vvinhvvo98/Basketball-Launcher/docs/FINAL.JPEG

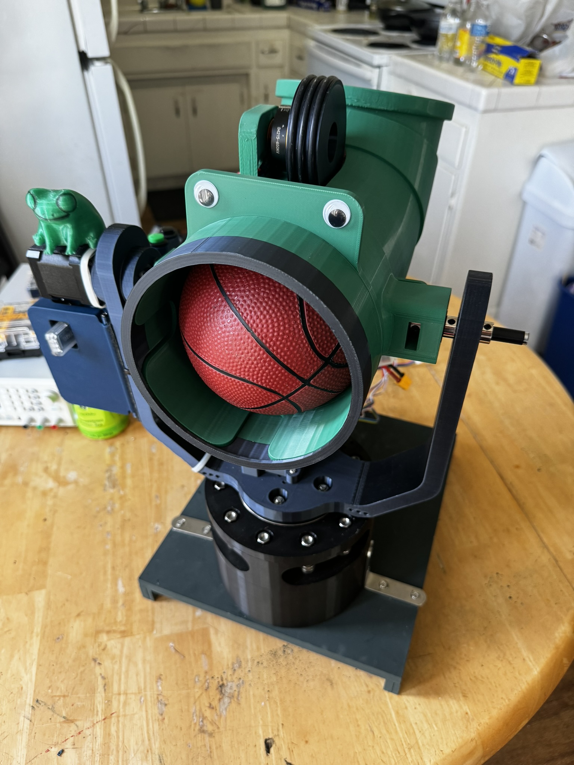
docs/FINAL.JPEG
