vvinhvvo98/Basketball-Launcher/docs/nut.png

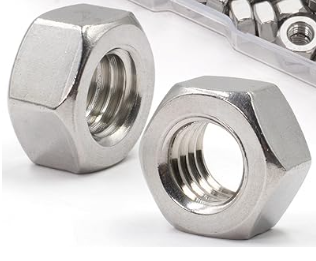
docs/nut.png
