vvinhvvo98/Basketball-Launcher/docs/latex/reports_detail.tex

\chapter{REFERENCE}
\label{reports_detail}\index{REFERENCE@{REFERENCE}}
\doxysection{OVERALL REPORT}\label{reports_detail_doc4}
 {\texttt{  }} 

~\newline
~\newline
~\newline
\doxysection{PROPOSAL}\label{reports_detail_doc1}
 {\texttt{  }} 

~\newline
~\newline
~\newline
\doxysection{REFERENCE MANUAL}\label{reports_detail_doc3}
 {\texttt{  }} 

~\newline
~\newline
~\newline
\doxysection{IDEATION SKETCH}\label{reports_detail_doc5}
 {\texttt{  }} 

~\newline
~\newline
~\newline
\doxysection{LAUNCHER SCHEMATIC}\label{reports_detail_doc8}
 {\texttt{  }} 

~\newline
~\newline
~\newline
\doxysection{CONTROLLER SCHEMATIC}\label{reports_detail_doc7}
 {\texttt{  }} 

~\newline
~\newline
~\newline
\doxysection{BILL OF MATERIAL}\label{reports_detail_doc2}
 {\texttt{  }} 

~\newline
~\newline
~\newline
\doxysection{3D MODEL}\label{reports_detail_doc6}
 {\texttt{  }} 

~\newline
~\newline
~\newline
\doxysection{YOUTUBE}\label{reports_detail_youtube11}
 {\texttt{  }} 

~\newline
~\newline
~\newline
\doxysection{REPOSITORY}\label{reports_detail_repository1}
 {\texttt{  }}
