vvinhvvo98/Basketball-Launcher/docs/latex/mpu6050_8h.tex

\doxysection{Ball\+\_\+\+Launcher\+\_\+\+Controller/\+Core/\+Inc/mpu6050.h File Reference}
\label{mpu6050_8h}\index{Ball\_Launcher\_Controller/Core/Inc/mpu6050.h@{Ball\_Launcher\_Controller/Core/Inc/mpu6050.h}}

Header for \doxyref{mpu6050.\+c}{p.}{mpu6050_8c} file. This file contains the common defines of the application.  

{\ttfamily \#include $<$stdio.\+h$>$}\newline
{\ttfamily \#include $<$stdint.\+h$>$}\newline
{\ttfamily \#include "{}stm32f4xx\+\_\+hal.\+h"{}}\newline
\doxysubsubsection*{Data Structures}
\begin{DoxyCompactItemize}
\item 
struct \textbf{ MPU6050}
\begin{DoxyCompactList}\small\item\em Struct representing a mpu6050 imu sensor. \end{DoxyCompactList}\end{DoxyCompactItemize}
\doxysubsubsection*{Functions}
\begin{DoxyCompactItemize}
\item 
uint16\+\_\+t \textbf{ mpu6050\+\_\+init} (\textbf{ MPU6050} $\ast$imux, I2\+C\+\_\+\+Handle\+Type\+Def $\ast$hi2c)
\begin{DoxyCompactList}\small\item\em Initializes the \doxyref{MPU6050}{p.}{struct_m_p_u6050} sensor. \end{DoxyCompactList}\item 
void \textbf{ mpu6050\+\_\+calibrate} (\textbf{ MPU6050} $\ast$imux)
\begin{DoxyCompactList}\small\item\em Calibrates the \doxyref{MPU6050}{p.}{struct_m_p_u6050} sensor. \end{DoxyCompactList}\item 
void \textbf{ mpu6050\+\_\+update} (\textbf{ MPU6050} $\ast$imux)
\begin{DoxyCompactList}\small\item\em Updates the \doxyref{MPU6050}{p.}{struct_m_p_u6050} sensor data. \end{DoxyCompactList}\item 
int16\+\_\+t \textbf{ mpu6050\+\_\+get\+\_\+gX} (\textbf{ MPU6050} $\ast$imux)
\begin{DoxyCompactList}\small\item\em Gets the calibrated X-\/axis gyroscope data. \end{DoxyCompactList}\item 
int16\+\_\+t \textbf{ mpu6050\+\_\+get\+\_\+gY} (\textbf{ MPU6050} $\ast$imux)
\begin{DoxyCompactList}\small\item\em Gets the calibrated Y-\/axis gyroscope data. \end{DoxyCompactList}\item 
int16\+\_\+t \textbf{ mpu6050\+\_\+get\+\_\+gZ} (\textbf{ MPU6050} $\ast$imux)
\begin{DoxyCompactList}\small\item\em Gets the calibrated Z-\/axis gyroscope data. \end{DoxyCompactList}\item 
int32\+\_\+t \textbf{ mpu6050\+\_\+get\+\_\+X} (\textbf{ MPU6050} $\ast$imux)
\begin{DoxyCompactList}\small\item\em Gets the X-\/axis accelerometer data. \end{DoxyCompactList}\item 
int32\+\_\+t \textbf{ mpu6050\+\_\+get\+\_\+Y} (\textbf{ MPU6050} $\ast$imux)
\begin{DoxyCompactList}\small\item\em Gets the Y-\/axis accelerometer data. \end{DoxyCompactList}\item 
int32\+\_\+t \textbf{ mpu6050\+\_\+get\+\_\+Z} (\textbf{ MPU6050} $\ast$imux)
\begin{DoxyCompactList}\small\item\em Gets the Z-\/axis accelerometer data. \end{DoxyCompactList}\end{DoxyCompactItemize}

\doxysubsection{Detailed Description}
Header for \doxyref{mpu6050.\+c}{p.}{mpu6050_8c} file. This file contains the common defines of the application. 

\doxysubsection{Function Documentation}
\label{mpu6050_8h_afce6eaf948ee778c47de0ee0a1eed19b} 
\index{mpu6050.h@{mpu6050.h}!mpu6050\_calibrate@{mpu6050\_calibrate}}
\index{mpu6050\_calibrate@{mpu6050\_calibrate}!mpu6050.h@{mpu6050.h}}
\doxysubsubsection{mpu6050\_calibrate()}
{\footnotesize\ttfamily void mpu6050\+\_\+calibrate (\begin{DoxyParamCaption}\item[{\textbf{ MPU6050} $\ast$}]{imux }\end{DoxyParamCaption})}

Calibrates the \doxyref{MPU6050}{p.}{struct_m_p_u6050} sensor. 

\begin{DoxyParams}{Parameters}
{\em imux} & Pointer to the \doxyref{MPU6050}{p.}{struct_m_p_u6050} structure. \\
\hline
\end{DoxyParams}
\label{mpu6050_8h_a9ea00ce90e91d89bd407680c26e726bc} 
\index{mpu6050.h@{mpu6050.h}!mpu6050\_get\_gX@{mpu6050\_get\_gX}}
\index{mpu6050\_get\_gX@{mpu6050\_get\_gX}!mpu6050.h@{mpu6050.h}}
\doxysubsubsection{mpu6050\_get\_gX()}
{\footnotesize\ttfamily int16\+\_\+t mpu6050\+\_\+get\+\_\+gX (\begin{DoxyParamCaption}\item[{\textbf{ MPU6050} $\ast$}]{imux }\end{DoxyParamCaption})}

Gets the calibrated X-\/axis gyroscope data. 

\begin{DoxyParams}{Parameters}
{\em imux} & Pointer to the \doxyref{MPU6050}{p.}{struct_m_p_u6050} structure. \\
\hline
\end{DoxyParams}
\begin{DoxyReturn}{Returns}
int16\+\_\+t Calibrated X-\/axis gyroscope data. 
\end{DoxyReturn}
\label{mpu6050_8h_aff1ec64e5ad571812ea3cdede42fb546} 
\index{mpu6050.h@{mpu6050.h}!mpu6050\_get\_gY@{mpu6050\_get\_gY}}
\index{mpu6050\_get\_gY@{mpu6050\_get\_gY}!mpu6050.h@{mpu6050.h}}
\doxysubsubsection{mpu6050\_get\_gY()}
{\footnotesize\ttfamily int16\+\_\+t mpu6050\+\_\+get\+\_\+gY (\begin{DoxyParamCaption}\item[{\textbf{ MPU6050} $\ast$}]{imux }\end{DoxyParamCaption})}

Gets the calibrated Y-\/axis gyroscope data. 

\begin{DoxyParams}{Parameters}
{\em imux} & Pointer to the \doxyref{MPU6050}{p.}{struct_m_p_u6050} structure. \\
\hline
\end{DoxyParams}
\begin{DoxyReturn}{Returns}
int16\+\_\+t Calibrated Y-\/axis gyroscope data. 
\end{DoxyReturn}
\label{mpu6050_8h_a43d5b475f578b8f07e2281ced858173f} 
\index{mpu6050.h@{mpu6050.h}!mpu6050\_get\_gZ@{mpu6050\_get\_gZ}}
\index{mpu6050\_get\_gZ@{mpu6050\_get\_gZ}!mpu6050.h@{mpu6050.h}}
\doxysubsubsection{mpu6050\_get\_gZ()}
{\footnotesize\ttfamily int16\+\_\+t mpu6050\+\_\+get\+\_\+gZ (\begin{DoxyParamCaption}\item[{\textbf{ MPU6050} $\ast$}]{imux }\end{DoxyParamCaption})}

Gets the calibrated Z-\/axis gyroscope data. 

\begin{DoxyParams}{Parameters}
{\em imux} & Pointer to the \doxyref{MPU6050}{p.}{struct_m_p_u6050} structure. \\
\hline
\end{DoxyParams}
\begin{DoxyReturn}{Returns}
int16\+\_\+t Calibrated Z-\/axis gyroscope data. 
\end{DoxyReturn}
\label{mpu6050_8h_a46f9847b0bc4a9ac73eeeaba24bb8dfc} 
\index{mpu6050.h@{mpu6050.h}!mpu6050\_get\_X@{mpu6050\_get\_X}}
\index{mpu6050\_get\_X@{mpu6050\_get\_X}!mpu6050.h@{mpu6050.h}}
\doxysubsubsection{mpu6050\_get\_X()}
{\footnotesize\ttfamily int32\+\_\+t mpu6050\+\_\+get\+\_\+X (\begin{DoxyParamCaption}\item[{\textbf{ MPU6050} $\ast$}]{imux }\end{DoxyParamCaption})}

Gets the X-\/axis accelerometer data. 

\begin{DoxyParams}{Parameters}
{\em imux} & Pointer to the \doxyref{MPU6050}{p.}{struct_m_p_u6050} structure. \\
\hline
\end{DoxyParams}
\begin{DoxyReturn}{Returns}
int32\+\_\+t X-\/axis accelerometer data. 
\end{DoxyReturn}
\label{mpu6050_8h_a604feb09984cc64950d98b711044bbf3} 
\index{mpu6050.h@{mpu6050.h}!mpu6050\_get\_Y@{mpu6050\_get\_Y}}
\index{mpu6050\_get\_Y@{mpu6050\_get\_Y}!mpu6050.h@{mpu6050.h}}
\doxysubsubsection{mpu6050\_get\_Y()}
{\footnotesize\ttfamily int32\+\_\+t mpu6050\+\_\+get\+\_\+Y (\begin{DoxyParamCaption}\item[{\textbf{ MPU6050} $\ast$}]{imux }\end{DoxyParamCaption})}

Gets the Y-\/axis accelerometer data. 

\begin{DoxyParams}{Parameters}
{\em imux} & Pointer to the \doxyref{MPU6050}{p.}{struct_m_p_u6050} structure. \\
\hline
\end{DoxyParams}
\begin{DoxyReturn}{Returns}
int32\+\_\+t Y-\/axis accelerometer data. 
\end{DoxyReturn}
\label{mpu6050_8h_a34ebf02768ba66f4d160afe9adbcc458} 
\index{mpu6050.h@{mpu6050.h}!mpu6050\_get\_Z@{mpu6050\_get\_Z}}
\index{mpu6050\_get\_Z@{mpu6050\_get\_Z}!mpu6050.h@{mpu6050.h}}
\doxysubsubsection{mpu6050\_get\_Z()}
{\footnotesize\ttfamily int32\+\_\+t mpu6050\+\_\+get\+\_\+Z (\begin{DoxyParamCaption}\item[{\textbf{ MPU6050} $\ast$}]{imux }\end{DoxyParamCaption})}

Gets the Z-\/axis accelerometer data. 

\begin{DoxyParams}{Parameters}
{\em imux} & Pointer to the \doxyref{MPU6050}{p.}{struct_m_p_u6050} structure. \\
\hline
\end{DoxyParams}
\begin{DoxyReturn}{Returns}
int32\+\_\+t Z-\/axis accelerometer data. 
\end{DoxyReturn}
\label{mpu6050_8h_a84091077cde2737d6afa76ee69cbe2e7} 
\index{mpu6050.h@{mpu6050.h}!mpu6050\_init@{mpu6050\_init}}
\index{mpu6050\_init@{mpu6050\_init}!mpu6050.h@{mpu6050.h}}
\doxysubsubsection{mpu6050\_init()}
{\footnotesize\ttfamily uint16\+\_\+t mpu6050\+\_\+init (\begin{DoxyParamCaption}\item[{\textbf{ MPU6050} $\ast$}]{imux,  }\item[{I2\+C\+\_\+\+Handle\+Type\+Def $\ast$}]{hi2c }\end{DoxyParamCaption})}

Initializes the \doxyref{MPU6050}{p.}{struct_m_p_u6050} sensor. 

\begin{DoxyParams}{Parameters}
{\em imux} & Pointer to the \doxyref{MPU6050}{p.}{struct_m_p_u6050} structure. \\
\hline
{\em hi2c} & Pointer to the I2C handle structure. \\
\hline
\end{DoxyParams}
\begin{DoxyReturn}{Returns}
uint16\+\_\+t Returns 1 if initialization is successful, otherwise 0. 
\end{DoxyReturn}
\label{mpu6050_8h_a617e3e6502d7a67be5e844967eb454f3} 
\index{mpu6050.h@{mpu6050.h}!mpu6050\_update@{mpu6050\_update}}
\index{mpu6050\_update@{mpu6050\_update}!mpu6050.h@{mpu6050.h}}
\doxysubsubsection{mpu6050\_update()}
{\footnotesize\ttfamily void mpu6050\+\_\+update (\begin{DoxyParamCaption}\item[{\textbf{ MPU6050} $\ast$}]{imux }\end{DoxyParamCaption})}

Updates the \doxyref{MPU6050}{p.}{struct_m_p_u6050} sensor data. 

\begin{DoxyParams}{Parameters}
{\em imux} & Pointer to the \doxyref{MPU6050}{p.}{struct_m_p_u6050} structure. \\
\hline
{\em dt} & Time interval in milliseconds. \\
\hline
\end{DoxyParams}
