vvinhvvo98/Basketball-Launcher/docs/latex/stm32f4xx__it___c_8h.tex

\doxysection{Ball\+\_\+\+Launcher\+\_\+\+Controller/\+Core/\+Inc/stm32f4xx\+\_\+it\+\_\+C.h File Reference}
\label{stm32f4xx__it___c_8h}\index{Ball\_Launcher\_Controller/Core/Inc/stm32f4xx\_it\_C.h@{Ball\_Launcher\_Controller/Core/Inc/stm32f4xx\_it\_C.h}}

This file contains the headers of the interrupt handlers.  

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

\doxysubsection{Detailed Description}
This file contains the headers of the interrupt handlers. 

\begin{DoxyAttention}{Attention}

\end{DoxyAttention}
Copyright (c) 2024 STMicroelectronics. All rights reserved.

This software is licensed under terms that can be found in the LICENSE file in the root directory of this software component. If no LICENSE file comes with this software, it is provided AS-\/\+IS. 

\doxysubsection{Function Documentation}
\label{stm32f4xx__it___c_8h_a850cefb17a977292ae5eb4cafa9976c3} 
\index{stm32f4xx\_it\_C.h@{stm32f4xx\_it\_C.h}!BusFault\_Handler@{BusFault\_Handler}}
\index{BusFault\_Handler@{BusFault\_Handler}!stm32f4xx\_it\_C.h@{stm32f4xx\_it\_C.h}}
\doxysubsubsection{BusFault\_Handler()}
{\footnotesize\ttfamily void Bus\+Fault\+\_\+\+Handler (\begin{DoxyParamCaption}\item[{void}]{ }\end{DoxyParamCaption})}

This function handles Pre-\/fetch fault, memory access fault. 

\label{stm32f4xx__it___c_8h_adbdfb05858cc36fc520974df37ec3cb0} 
\index{stm32f4xx\_it\_C.h@{stm32f4xx\_it\_C.h}!DebugMon\_Handler@{DebugMon\_Handler}}
\index{DebugMon\_Handler@{DebugMon\_Handler}!stm32f4xx\_it\_C.h@{stm32f4xx\_it\_C.h}}
\doxysubsubsection{DebugMon\_Handler()}
{\footnotesize\ttfamily void Debug\+Mon\+\_\+\+Handler (\begin{DoxyParamCaption}\item[{void}]{ }\end{DoxyParamCaption})}

This function handles Debug monitor. 

\label{stm32f4xx__it___c_8h_a2bffc10d5bd4106753b7c30e86903bea} 
\index{stm32f4xx\_it\_C.h@{stm32f4xx\_it\_C.h}!HardFault\_Handler@{HardFault\_Handler}}
\index{HardFault\_Handler@{HardFault\_Handler}!stm32f4xx\_it\_C.h@{stm32f4xx\_it\_C.h}}
\doxysubsubsection{HardFault\_Handler()}
{\footnotesize\ttfamily void Hard\+Fault\+\_\+\+Handler (\begin{DoxyParamCaption}\item[{void}]{ }\end{DoxyParamCaption})}

This function handles Hard fault interrupt. 

\label{stm32f4xx__it___c_8h_a3150f74512510287a942624aa9b44cc5} 
\index{stm32f4xx\_it\_C.h@{stm32f4xx\_it\_C.h}!MemManage\_Handler@{MemManage\_Handler}}
\index{MemManage\_Handler@{MemManage\_Handler}!stm32f4xx\_it\_C.h@{stm32f4xx\_it\_C.h}}
\doxysubsubsection{MemManage\_Handler()}
{\footnotesize\ttfamily void Mem\+Manage\+\_\+\+Handler (\begin{DoxyParamCaption}\item[{void}]{ }\end{DoxyParamCaption})}

This function handles Memory management fault. 

\label{stm32f4xx__it___c_8h_a6ad7a5e3ee69cb6db6a6b9111ba898bc} 
\index{stm32f4xx\_it\_C.h@{stm32f4xx\_it\_C.h}!NMI\_Handler@{NMI\_Handler}}
\index{NMI\_Handler@{NMI\_Handler}!stm32f4xx\_it\_C.h@{stm32f4xx\_it\_C.h}}
\doxysubsubsection{NMI\_Handler()}
{\footnotesize\ttfamily void NMI\+\_\+\+Handler (\begin{DoxyParamCaption}\item[{void}]{ }\end{DoxyParamCaption})}

This function handles Non maskable interrupt. 

\label{stm32f4xx__it___c_8h_a6303e1f258cbdc1f970ce579cc015623} 
\index{stm32f4xx\_it\_C.h@{stm32f4xx\_it\_C.h}!PendSV\_Handler@{PendSV\_Handler}}
\index{PendSV\_Handler@{PendSV\_Handler}!stm32f4xx\_it\_C.h@{stm32f4xx\_it\_C.h}}
\doxysubsubsection{PendSV\_Handler()}
{\footnotesize\ttfamily void Pend\+SV\+\_\+\+Handler (\begin{DoxyParamCaption}\item[{void}]{ }\end{DoxyParamCaption})}

This function handles Pendable request for system service. 

\label{stm32f4xx__it___c_8h_a3e5ddb3df0d62f2dc357e64a3f04a6ce} 
\index{stm32f4xx\_it\_C.h@{stm32f4xx\_it\_C.h}!SVC\_Handler@{SVC\_Handler}}
\index{SVC\_Handler@{SVC\_Handler}!stm32f4xx\_it\_C.h@{stm32f4xx\_it\_C.h}}
\doxysubsubsection{SVC\_Handler()}
{\footnotesize\ttfamily void SVC\+\_\+\+Handler (\begin{DoxyParamCaption}\item[{void}]{ }\end{DoxyParamCaption})}

This function handles System service call via SWI instruction. 

\label{stm32f4xx__it___c_8h_ab5e09814056d617c521549e542639b7e} 
\index{stm32f4xx\_it\_C.h@{stm32f4xx\_it\_C.h}!SysTick\_Handler@{SysTick\_Handler}}
\index{SysTick\_Handler@{SysTick\_Handler}!stm32f4xx\_it\_C.h@{stm32f4xx\_it\_C.h}}
\doxysubsubsection{SysTick\_Handler()}
{\footnotesize\ttfamily void Sys\+Tick\+\_\+\+Handler (\begin{DoxyParamCaption}\item[{void}]{ }\end{DoxyParamCaption})}

This function handles System tick timer. 

\label{stm32f4xx__it___c_8h_a1d98923de2ed6b7309b66f9ba2971647} 
\index{stm32f4xx\_it\_C.h@{stm32f4xx\_it\_C.h}!UsageFault\_Handler@{UsageFault\_Handler}}
\index{UsageFault\_Handler@{UsageFault\_Handler}!stm32f4xx\_it\_C.h@{stm32f4xx\_it\_C.h}}
\doxysubsubsection{UsageFault\_Handler()}
{\footnotesize\ttfamily void Usage\+Fault\+\_\+\+Handler (\begin{DoxyParamCaption}\item[{void}]{ }\end{DoxyParamCaption})}

This function handles Undefined instruction or illegal state.
