vvinhvvo98/Basketball-Launcher/docs/latex/main_8h.tex

\doxysection{Ball\+\_\+\+Launcher\+\_\+\+Main/\+Core/\+Inc/main.h File Reference}
\label{main_8h}\index{Ball\_Launcher\_Main/Core/Inc/main.h@{Ball\_Launcher\_Main/Core/Inc/main.h}}

Header for \doxyref{main.\+c}{p.}{main_8c} file. This file contains the common defines of the application.  

{\ttfamily \#include "{}stm32f4xx\+\_\+hal.\+h"{}}\newline
\doxysubsubsection*{Functions}
\begin{DoxyCompactItemize}
\item 
void \textbf{ HAL\+\_\+\+TIM\+\_\+\+Msp\+Post\+Init} (TIM\+\_\+\+Handle\+Type\+Def $\ast$htim)
\item 
void \textbf{ Error\+\_\+\+Handler} (void)
\begin{DoxyCompactList}\small\item\em This function is executed in case of error occurrence. \end{DoxyCompactList}\end{DoxyCompactItemize}

\doxysubsection{Detailed Description}
Header for \doxyref{main.\+c}{p.}{main_8c} file. This file contains the common defines of the application. 

\begin{DoxyAttention}{Attention}

\end{DoxyAttention}
Copyright (c) 2024 STMicroelectronics. All rights reserved.

This software is licensed under terms that can be found in the LICENSE file in the root directory of this software component. If no LICENSE file comes with this software, it is provided AS-\/\+IS. 

\doxysubsection{Function Documentation}
\label{main_8h_a1730ffe1e560465665eb47d9264826f9} 
\index{main.h@{main.h}!Error\_Handler@{Error\_Handler}}
\index{Error\_Handler@{Error\_Handler}!main.h@{main.h}}
\doxysubsubsection{Error\_Handler()}
{\footnotesize\ttfamily void Error\+\_\+\+Handler (\begin{DoxyParamCaption}\item[{void}]{ }\end{DoxyParamCaption})}

This function is executed in case of error occurrence. 

\begin{DoxyRetVals}{Return values}
{\em None} & \\
\hline
\end{DoxyRetVals}
\label{main_8h_ae70bce6c39d0b570a7523b86738cec4b} 
\index{main.h@{main.h}!HAL\_TIM\_MspPostInit@{HAL\_TIM\_MspPostInit}}
\index{HAL\_TIM\_MspPostInit@{HAL\_TIM\_MspPostInit}!main.h@{main.h}}
\doxysubsubsection{HAL\_TIM\_MspPostInit()}
{\footnotesize\ttfamily void HAL\+\_\+\+TIM\+\_\+\+Msp\+Post\+Init (\begin{DoxyParamCaption}\item[{TIM\+\_\+\+Handle\+Type\+Def $\ast$}]{htim }\end{DoxyParamCaption})}

TIM2 GPIO Configuration PA1 -\/-\/-\/-\/-\/-\/$>$ TIM2\+\_\+\+CH2 PA2 -\/-\/-\/-\/-\/-\/$>$ TIM2\+\_\+\+CH3

TIM3 GPIO Configuration PB5 -\/-\/-\/-\/-\/-\/$>$ TIM3\+\_\+\+CH2
