vvinhvvo98/Basketball-Launcher/docs/latex/main___c_8c.tex

\doxysection{Ball\+\_\+\+Launcher\+\_\+\+Controller/\+Core/\+Src/main\+\_\+C.c File Reference}
\label{main___c_8c}\index{Ball\_Launcher\_Controller/Core/Src/main\_C.c@{Ball\_Launcher\_Controller/Core/Src/main\_C.c}}

Main program body.  

{\ttfamily \#include "{}main.\+h"{}}\newline
{\ttfamily \#include "{}mpu6050.\+h"{}}\newline
{\ttfamily \#include $<$stdio.\+h$>$}\newline
{\ttfamily \#include $<$string.\+h$>$}\newline
\doxysubsubsection*{Functions}
\begin{DoxyCompactItemize}
\item 
void \textbf{ System\+Clock\+\_\+\+Config} (void)
\begin{DoxyCompactList}\small\item\em System Clock Configuration. \end{DoxyCompactList}\item 
int \textbf{ main} (void)
\begin{DoxyCompactList}\small\item\em The application entry point. \end{DoxyCompactList}\item 
void \textbf{ Error\+\_\+\+Handler} (void)
\begin{DoxyCompactList}\small\item\em This function is executed in case of error occurrence. \end{DoxyCompactList}\end{DoxyCompactItemize}
\doxysubsubsection*{Variables}
\begin{DoxyCompactItemize}
\item 
I2\+C\+\_\+\+Handle\+Type\+Def \textbf{ hi2c1}
\item 
UART\+\_\+\+Handle\+Type\+Def \textbf{ huart1}
\item 
UART\+\_\+\+Handle\+Type\+Def \textbf{ huart2}
\item 
int16\+\_\+t \textbf{ gX} = 0
\item 
int16\+\_\+t \textbf{ gY} = 0
\item 
int16\+\_\+t \textbf{ gZ} = 0
\item 
uint16\+\_\+t \textbf{ stat} = 0
\item 
uint16\+\_\+t \textbf{ shot} = 0
\item 
uint16\+\_\+t \textbf{ move} = 0
\item 
uint16\+\_\+t \textbf{ STATE} = 0
\item 
uint16\+\_\+t \textbf{ STATE\+\_\+0\+\_\+\+INIT} = 0
\item 
uint16\+\_\+t \textbf{ STATE\+\_\+1\+\_\+\+ERROR} = 1
\item 
uint16\+\_\+t \textbf{ STATE\+\_\+2\+\_\+\+IMU} = 2
\item 
uint16\+\_\+t \textbf{ STATE\+\_\+3\+\_\+\+BUTTON\+\_\+\+LED} = 3
\item 
uint16\+\_\+t \textbf{ STATE\+\_\+4\+\_\+\+TRANSFER} = 4
\item 
char \textbf{ buffer} [100]
\end{DoxyCompactItemize}

\doxysubsection{Detailed Description}
Main program body. 

\begin{DoxyAttention}{Attention}

\end{DoxyAttention}
Copyright (c) 2024 STMicroelectronics. All rights reserved.

This software is licensed under terms that can be found in the LICENSE file in the root directory of this software component. If no LICENSE file comes with this software, it is provided AS-\/\+IS. 

\doxysubsection{Function Documentation}
\label{main___c_8c_a1730ffe1e560465665eb47d9264826f9} 
\index{main\_C.c@{main\_C.c}!Error\_Handler@{Error\_Handler}}
\index{Error\_Handler@{Error\_Handler}!main\_C.c@{main\_C.c}}
\doxysubsubsection{Error\_Handler()}
{\footnotesize\ttfamily void Error\+\_\+\+Handler (\begin{DoxyParamCaption}\item[{void}]{ }\end{DoxyParamCaption})}

This function is executed in case of error occurrence. 

\begin{DoxyRetVals}{Return values}
{\em None} & \\
\hline
\end{DoxyRetVals}
\label{main___c_8c_a840291bc02cba5474a4cb46a9b9566fe} 
\index{main\_C.c@{main\_C.c}!main@{main}}
\index{main@{main}!main\_C.c@{main\_C.c}}
\doxysubsubsection{main()}
{\footnotesize\ttfamily int main (\begin{DoxyParamCaption}\item[{void}]{ }\end{DoxyParamCaption})}

The application entry point. 

\begin{DoxyRetVals}{Return values}
{\em int} & \\
\hline
\end{DoxyRetVals}
\label{main___c_8c_a70af21c671abfcc773614a9a4f63d920} 
\index{main\_C.c@{main\_C.c}!SystemClock\_Config@{SystemClock\_Config}}
\index{SystemClock\_Config@{SystemClock\_Config}!main\_C.c@{main\_C.c}}
\doxysubsubsection{SystemClock\_Config()}
{\footnotesize\ttfamily void System\+Clock\+\_\+\+Config (\begin{DoxyParamCaption}\item[{void}]{ }\end{DoxyParamCaption})}

System Clock Configuration. 

\begin{DoxyRetVals}{Return values}
{\em None} & \\
\hline
\end{DoxyRetVals}
Configure the main internal regulator output voltage

Initializes the RCC Oscillators according to the specified parameters in the RCC\+\_\+\+Osc\+Init\+Type\+Def structure.

Initializes the CPU, AHB and APB buses clocks

\doxysubsection{Variable Documentation}
\label{main___c_8c_a542df3d5bbe8c96a672476931ec18220} 
\index{main\_C.c@{main\_C.c}!buffer@{buffer}}
\index{buffer@{buffer}!main\_C.c@{main\_C.c}}
\doxysubsubsection{buffer}
{\footnotesize\ttfamily char buffer[100]}

\label{main___c_8c_af311395520d3063de824b529c9cdb10d} 
\index{main\_C.c@{main\_C.c}!gX@{gX}}
\index{gX@{gX}!main\_C.c@{main\_C.c}}
\doxysubsubsection{gX}
{\footnotesize\ttfamily int16\+\_\+t gX = 0}

\label{main___c_8c_a158916f3f452bccade03134dd750e452} 
\index{main\_C.c@{main\_C.c}!gY@{gY}}
\index{gY@{gY}!main\_C.c@{main\_C.c}}
\doxysubsubsection{gY}
{\footnotesize\ttfamily int16\+\_\+t gY = 0}

\label{main___c_8c_a2c037649b97f103359d32fc55121c752} 
\index{main\_C.c@{main\_C.c}!gZ@{gZ}}
\index{gZ@{gZ}!main\_C.c@{main\_C.c}}
\doxysubsubsection{gZ}
{\footnotesize\ttfamily int16\+\_\+t gZ = 0}

\label{main___c_8c_af7b2c26e44dadaaa798a5c3d82914ba7} 
\index{main\_C.c@{main\_C.c}!hi2c1@{hi2c1}}
\index{hi2c1@{hi2c1}!main\_C.c@{main\_C.c}}
\doxysubsubsection{hi2c1}
{\footnotesize\ttfamily I2\+C\+\_\+\+Handle\+Type\+Def hi2c1}

\label{main___c_8c_a2cf715bef37f7e8ef385a30974a5f0d5} 
\index{main\_C.c@{main\_C.c}!huart1@{huart1}}
\index{huart1@{huart1}!main\_C.c@{main\_C.c}}
\doxysubsubsection{huart1}
{\footnotesize\ttfamily UART\+\_\+\+Handle\+Type\+Def huart1}

\label{main___c_8c_aa9479c261d65eecedd3d9582f7f0f89c} 
\index{main\_C.c@{main\_C.c}!huart2@{huart2}}
\index{huart2@{huart2}!main\_C.c@{main\_C.c}}
\doxysubsubsection{huart2}
{\footnotesize\ttfamily UART\+\_\+\+Handle\+Type\+Def huart2}

\label{main___c_8c_af0ccf006f74d313e9fcefe4a8edd47b8} 
\index{main\_C.c@{main\_C.c}!move@{move}}
\index{move@{move}!main\_C.c@{main\_C.c}}
\doxysubsubsection{move}
{\footnotesize\ttfamily uint16\+\_\+t move = 0}

\label{main___c_8c_a734a6bb09e6a5fc98ebb8436df7ae452} 
\index{main\_C.c@{main\_C.c}!shot@{shot}}
\index{shot@{shot}!main\_C.c@{main\_C.c}}
\doxysubsubsection{shot}
{\footnotesize\ttfamily uint16\+\_\+t shot = 0}

\label{main___c_8c_a9ebb6eed90bd90fa99f9cf9e1f6c69fd} 
\index{main\_C.c@{main\_C.c}!stat@{stat}}
\index{stat@{stat}!main\_C.c@{main\_C.c}}
\doxysubsubsection{stat}
{\footnotesize\ttfamily uint16\+\_\+t stat = 0}

\label{main___c_8c_a942cbc58d5df6ff6e78e7de2da6bb43d} 
\index{main\_C.c@{main\_C.c}!STATE@{STATE}}
\index{STATE@{STATE}!main\_C.c@{main\_C.c}}
\doxysubsubsection{STATE}
{\footnotesize\ttfamily uint16\+\_\+t STATE = 0}

\label{main___c_8c_a18428ffe41044eaa981a9aa5d12c0268} 
\index{main\_C.c@{main\_C.c}!STATE\_0\_INIT@{STATE\_0\_INIT}}
\index{STATE\_0\_INIT@{STATE\_0\_INIT}!main\_C.c@{main\_C.c}}
\doxysubsubsection{STATE\_0\_INIT}
{\footnotesize\ttfamily uint16\+\_\+t STATE\+\_\+0\+\_\+\+INIT = 0}

\label{main___c_8c_ac121bcf9c6185c1391e9d76671c0cab9} 
\index{main\_C.c@{main\_C.c}!STATE\_1\_ERROR@{STATE\_1\_ERROR}}
\index{STATE\_1\_ERROR@{STATE\_1\_ERROR}!main\_C.c@{main\_C.c}}
\doxysubsubsection{STATE\_1\_ERROR}
{\footnotesize\ttfamily uint16\+\_\+t STATE\+\_\+1\+\_\+\+ERROR = 1}

\label{main___c_8c_a5552820803f06a882be3bf1cdfbde998} 
\index{main\_C.c@{main\_C.c}!STATE\_2\_IMU@{STATE\_2\_IMU}}
\index{STATE\_2\_IMU@{STATE\_2\_IMU}!main\_C.c@{main\_C.c}}
\doxysubsubsection{STATE\_2\_IMU}
{\footnotesize\ttfamily uint16\+\_\+t STATE\+\_\+2\+\_\+\+IMU = 2}

\label{main___c_8c_aca0f5e1c40d574009ccfb91fe42929d0} 
\index{main\_C.c@{main\_C.c}!STATE\_3\_BUTTON\_LED@{STATE\_3\_BUTTON\_LED}}
\index{STATE\_3\_BUTTON\_LED@{STATE\_3\_BUTTON\_LED}!main\_C.c@{main\_C.c}}
\doxysubsubsection{STATE\_3\_BUTTON\_LED}
{\footnotesize\ttfamily uint16\+\_\+t STATE\+\_\+3\+\_\+\+BUTTON\+\_\+\+LED = 3}

\label{main___c_8c_a6e420747c5d2d0820f7a909bb0084f66} 
\index{main\_C.c@{main\_C.c}!STATE\_4\_TRANSFER@{STATE\_4\_TRANSFER}}
\index{STATE\_4\_TRANSFER@{STATE\_4\_TRANSFER}!main\_C.c@{main\_C.c}}
\doxysubsubsection{STATE\_4\_TRANSFER}
{\footnotesize\ttfamily uint16\+\_\+t STATE\+\_\+4\+\_\+\+TRANSFER = 4}
