vvinhvvo98/Basketball-Launcher/docs/latex/main___c_8h.tex

\doxysection{Ball\+\_\+\+Launcher\+\_\+\+Controller/\+Core/\+Inc/main\+\_\+C.h File Reference}
\label{main___c_8h}\index{Ball\_Launcher\_Controller/Core/Inc/main\_C.h@{Ball\_Launcher\_Controller/Core/Inc/main\_C.h}}

Header for \doxyref{main\+\_\+\+C.\+c}{p.}{main___c_8c} file. This file contains the common defines of the application.  

{\ttfamily \#include "{}stm32f4xx\+\_\+hal.\+h"{}}\newline
\doxysubsubsection*{Functions}
\begin{DoxyCompactItemize}
\item 
void \textbf{ Error\+\_\+\+Handler} (void)
\begin{DoxyCompactList}\small\item\em This function is executed in case of error occurrence. \end{DoxyCompactList}\end{DoxyCompactItemize}

\doxysubsection{Detailed Description}
Header for \doxyref{main\+\_\+\+C.\+c}{p.}{main___c_8c} file. This file contains the common defines of the application. 

\begin{DoxyAttention}{Attention}

\end{DoxyAttention}
Copyright (c) 2024 STMicroelectronics. All rights reserved.

This software is licensed under terms that can be found in the LICENSE file in the root directory of this software component. If no LICENSE file comes with this software, it is provided AS-\/\+IS. 

\doxysubsection{Function Documentation}
\label{main___c_8h_a1730ffe1e560465665eb47d9264826f9} 
\index{main\_C.h@{main\_C.h}!Error\_Handler@{Error\_Handler}}
\index{Error\_Handler@{Error\_Handler}!main\_C.h@{main\_C.h}}
\doxysubsubsection{Error\_Handler()}
{\footnotesize\ttfamily void Error\+\_\+\+Handler (\begin{DoxyParamCaption}\item[{void}]{ }\end{DoxyParamCaption})}

This function is executed in case of error occurrence. 

\begin{DoxyRetVals}{Return values}
{\em None} & \\
\hline
\end{DoxyRetVals}
