vvinhvvo98/Basketball-Launcher/docs/latex/sysmem_8c.tex

\doxysection{Ball\+\_\+\+Launcher\+\_\+\+Main/\+Core/\+Src/sysmem.c File Reference}
\label{sysmem_8c}\index{Ball\_Launcher\_Main/Core/Src/sysmem.c@{Ball\_Launcher\_Main/Core/Src/sysmem.c}}

STM32\+Cube\+IDE System Memory calls file.  

{\ttfamily \#include $<$errno.\+h$>$}\newline
{\ttfamily \#include $<$stdint.\+h$>$}\newline
\doxysubsubsection*{Functions}
\begin{DoxyCompactItemize}
\item 
void $\ast$ \textbf{ \+\_\+sbrk} (ptrdiff\+\_\+t incr)
\begin{DoxyCompactList}\small\item\em \doxyref{\+\_\+sbrk()}{p.}{sysmem_8c_a68125648bcce70b6bb3aa0be50e99700} allocates memory to the newlib heap and is used by malloc and others from the C library \end{DoxyCompactList}\end{DoxyCompactItemize}

\doxysubsection{Detailed Description}
STM32\+Cube\+IDE System Memory calls file. 

\begin{DoxyAuthor}{Author}
Generated by STM32\+Cube\+IDE \begin{DoxyVerb}       For more information about which C functions
       need which of these lowlevel functions
       please consult the newlib libc manual
\end{DoxyVerb}
 
\end{DoxyAuthor}
\begin{DoxyAttention}{Attention}

\end{DoxyAttention}
Copyright (c) 2024 STMicroelectronics. All rights reserved.

This software is licensed under terms that can be found in the LICENSE file in the root directory of this software component. If no LICENSE file comes with this software, it is provided AS-\/\+IS. 

\doxysubsection{Function Documentation}
\label{sysmem_8c_a68125648bcce70b6bb3aa0be50e99700} 
\index{sysmem.c@{sysmem.c}!\_sbrk@{\_sbrk}}
\index{\_sbrk@{\_sbrk}!sysmem.c@{sysmem.c}}
\doxysubsubsection{\_sbrk()}
{\footnotesize\ttfamily void $\ast$ \+\_\+sbrk (\begin{DoxyParamCaption}\item[{ptrdiff\+\_\+t}]{incr }\end{DoxyParamCaption})}

\doxyref{\+\_\+sbrk()}{p.}{sysmem_8c_a68125648bcce70b6bb3aa0be50e99700} allocates memory to the newlib heap and is used by malloc and others from the C library 

\begin{DoxyVerb}* ############################################################################
* #  .data  #  .bss  #       newlib heap       #          MSP stack          #
* #         #        #                         # Reserved by _Min_Stack_Size #
* ############################################################################
* ^-- RAM start      ^-- _end                             _estack, RAM end --^
* \end{DoxyVerb}

This implementation starts allocating at the \textquotesingle{}\+\_\+end\textquotesingle{} linker symbol The \textquotesingle{}\+\_\+\+Min\+\_\+\+Stack\+\_\+\+Size\textquotesingle{} linker symbol reserves a memory for the MSP stack The implementation considers \textquotesingle{}\+\_\+estack\textquotesingle{} linker symbol to be RAM end NOTE\+: If the MSP stack, at any point during execution, grows larger than the reserved size, please increase the \textquotesingle{}\+\_\+\+Min\+\_\+\+Stack\+\_\+\+Size\textquotesingle{}.

\begin{DoxyParams}{Parameters}
{\em incr} & Memory size \\
\hline
\end{DoxyParams}
\begin{DoxyReturn}{Returns}
Pointer to allocated memory 
\end{DoxyReturn}
