vvinhvvo98/Basketball-Launcher/docs/latex/system__stm32f4xx_8c.tex

\doxysection{Ball\+\_\+\+Launcher\+\_\+\+Main/\+Core/\+Src/system\+\_\+stm32f4xx.c File Reference}
\label{system__stm32f4xx_8c}\index{Ball\_Launcher\_Main/Core/Src/system\_stm32f4xx.c@{Ball\_Launcher\_Main/Core/Src/system\_stm32f4xx.c}}

CMSIS Cortex-\/\+M4 Device Peripheral Access Layer System Source File.  

{\ttfamily \#include "{}stm32f4xx.\+h"{}}\newline
\doxysubsubsection*{Macros}
\begin{DoxyCompactItemize}
\item 
\#define \textbf{ HSE\+\_\+\+VALUE}~((uint32\+\_\+t)25000000)
\item 
\#define \textbf{ HSI\+\_\+\+VALUE}~((uint32\+\_\+t)16000000)
\end{DoxyCompactItemize}
\doxysubsubsection*{Functions}
\begin{DoxyCompactItemize}
\item 
void \textbf{ System\+Init} (void)
\begin{DoxyCompactList}\small\item\em Setup the microcontroller system Initialize the FPU setting, vector table location and External memory configuration. \end{DoxyCompactList}\item 
void \textbf{ System\+Core\+Clock\+Update} (void)
\begin{DoxyCompactList}\small\item\em Update System\+Core\+Clock variable according to Clock Register Values. The System\+Core\+Clock variable contains the core clock (HCLK), it can be used by the user application to setup the Sys\+Tick timer or configure other parameters. \end{DoxyCompactList}\end{DoxyCompactItemize}
\doxysubsubsection*{Variables}
\begin{DoxyCompactItemize}
\item 
uint32\+\_\+t \textbf{ System\+Core\+Clock} = 16000000
\item 
const uint8\+\_\+t \textbf{ AHBPresc\+Table} [16] = \{0, 0, 0, 0, 0, 0, 0, 0, 1, 2, 3, 4, 6, 7, 8, 9\}
\item 
const uint8\+\_\+t \textbf{ APBPresc\+Table} [8] = \{0, 0, 0, 0, 1, 2, 3, 4\}
\end{DoxyCompactItemize}

\doxysubsection{Detailed Description}
CMSIS Cortex-\/\+M4 Device Peripheral Access Layer System Source File. 

\begin{DoxyAuthor}{Author}
MCD Application Team 
\end{DoxyAuthor}
This file provides two functions and one global variable to be called from user application\+:
\begin{DoxyItemize}
\item \doxyref{System\+Init()}{p.}{group___s_t_m32_f4xx___system___private___functions_ga93f514700ccf00d08dbdcff7f1224eb2}\+: This function is called at startup just after reset and before branch to main program. This call is made inside the "{}startup\+\_\+stm32f4xx.\+s"{} file.
\item System\+Core\+Clock variable\+: Contains the core clock (HCLK), it can be used by the user application to setup the Sys\+Tick timer or configure other parameters.
\item \doxyref{System\+Core\+Clock\+Update()}{p.}{group___s_t_m32_f4xx___system___private___functions_gae0c36a9591fe6e9c45ecb21a794f0f0f}\+: Updates the variable System\+Core\+Clock and must be called whenever the core clock is changed during program execution.
\end{DoxyItemize}

\begin{DoxyAttention}{Attention}

\end{DoxyAttention}
Copyright (c) 2017 STMicroelectronics. All rights reserved.

This software is licensed under terms that can be found in the LICENSE file in the root directory of this software component. If no LICENSE file comes with this software, it is provided AS-\/\+IS.
