vvinhvvo98/Basketball-Launcher/docs/25bearing.png

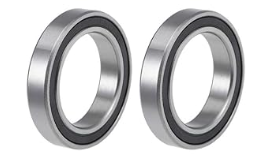
docs/25bearing.png
