vvinhvvo98/Basketball-Launcher/docs/35bearing.png

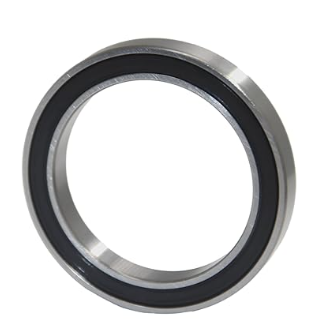
docs/35bearing.png
