vvinhvvo98/Basketball-Launcher/docs/45bearing.png

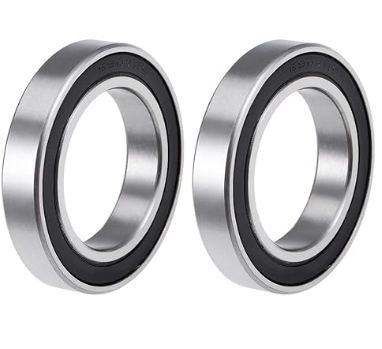
docs/45bearing.png
