vvinhvvo98/Basketball-Launcher/docs/basketball.png

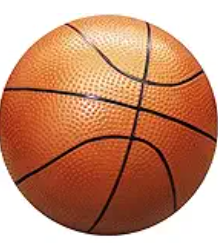
docs/basketball.png
