vvinhvvo98/Basketball-Launcher/docs/battery.png

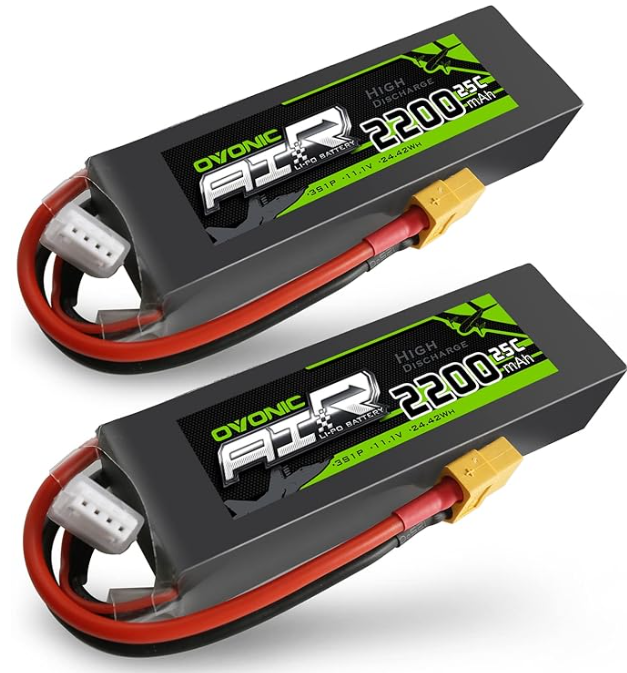
docs/battery.png
