vvinhvvo98/Basketball-Launcher/docs/bolt.png

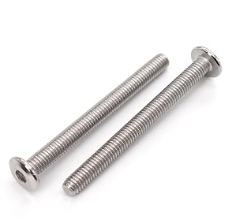
docs/bolt.png
