vvinhvvo98/Basketball-Launcher/docs/cable.png

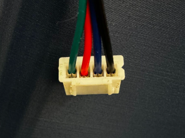
docs/cable.png
