vvinhvvo98/Basketball-Launcher/docs/CAD.png

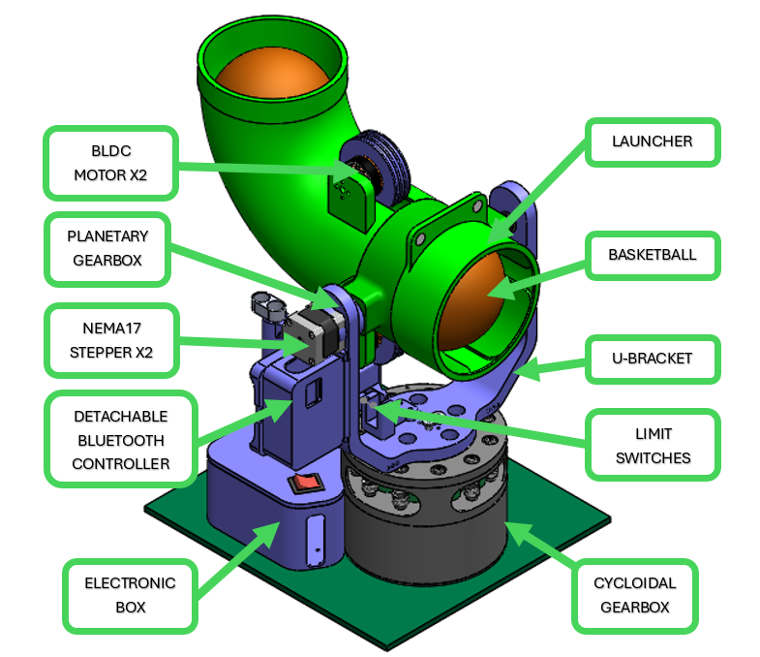
docs/CAD.png
