vvinhvvo98/Basketball-Launcher/docs/CG.png

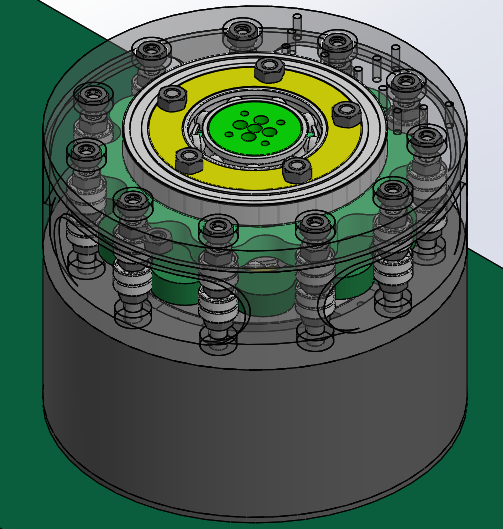
docs/CG.png
