vvinhvvo98/Basketball-Launcher/docs/d4215_bldc.png

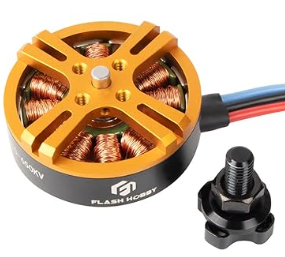
docs/d4215_bldc.png
