vvinhvvo98/Basketball-Launcher/docs/ebox.png

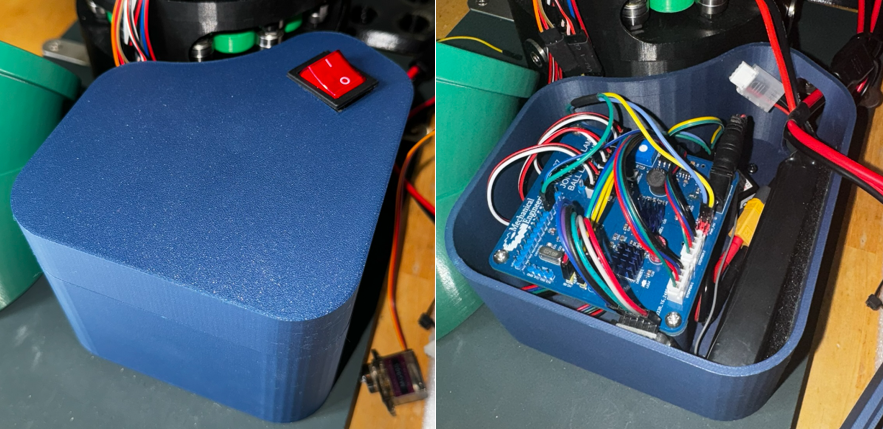
docs/ebox.png
