vvinhvvo98/Basketball-Launcher/docs/FINAL.png

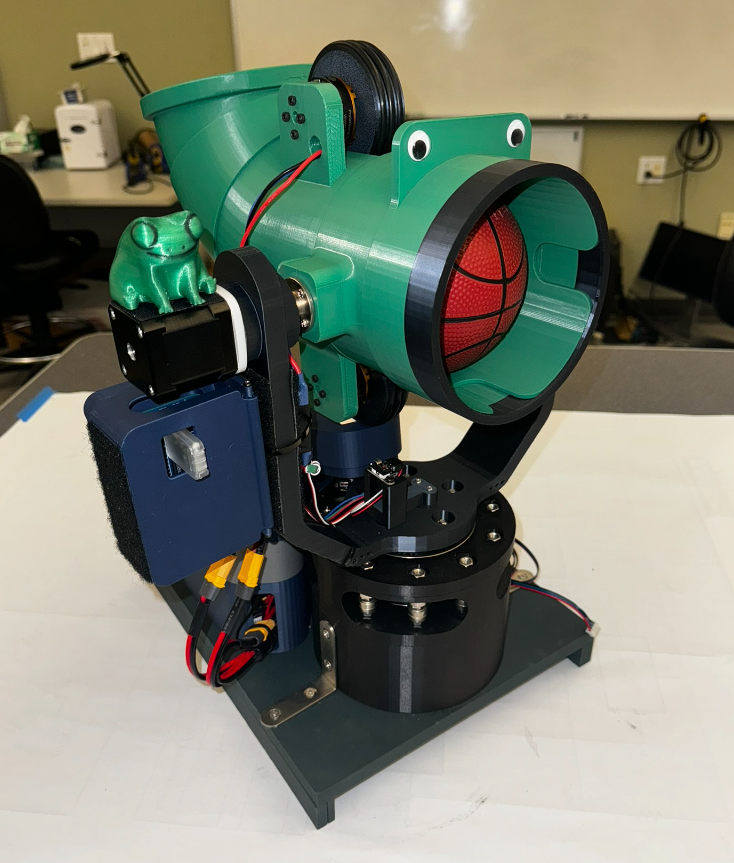
docs/FINAL.png
