vvinhvvo98/Basketball-Launcher/docs/finalpcb2.png

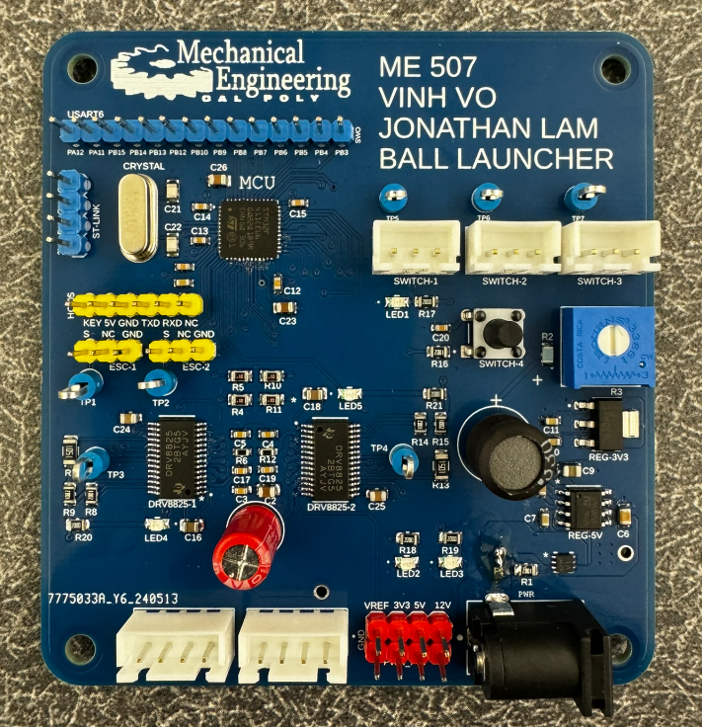
docs/finalpcb2.png
