vvinhvvo98/Basketball-Launcher/docs/fppf.png

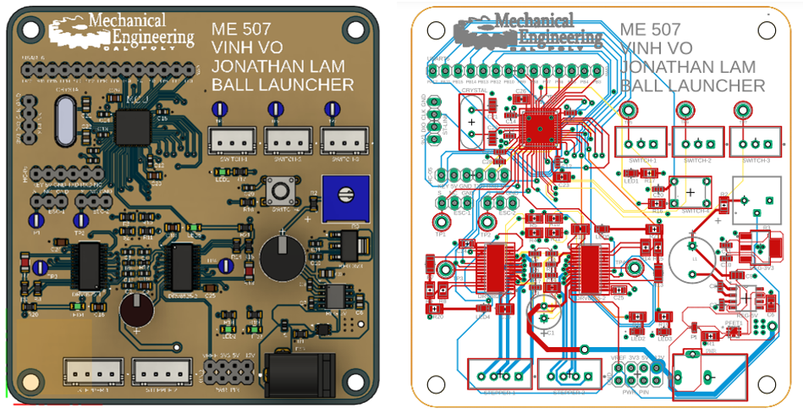
docs/fppf.png
