vvinhvvo98/Basketball-Launcher/docs/FSM2.png

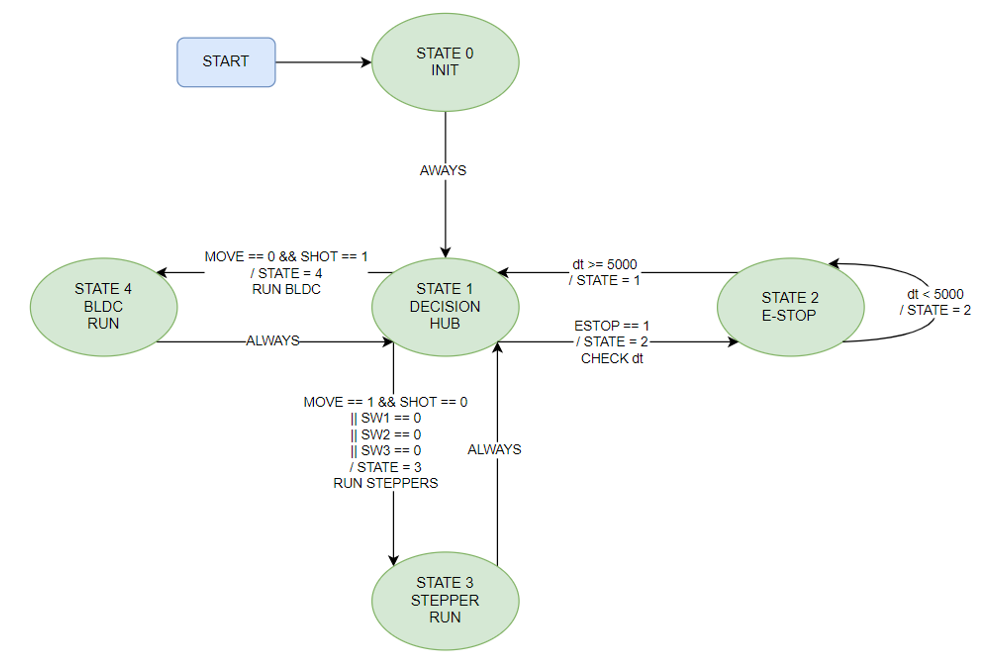
docs/FSM2.png
