vvinhvvo98/Basketball-Launcher/docs/github.png

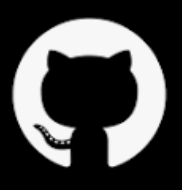
docs/github.png
