vvinhvvo98/Basketball-Launcher/docs/idea.png

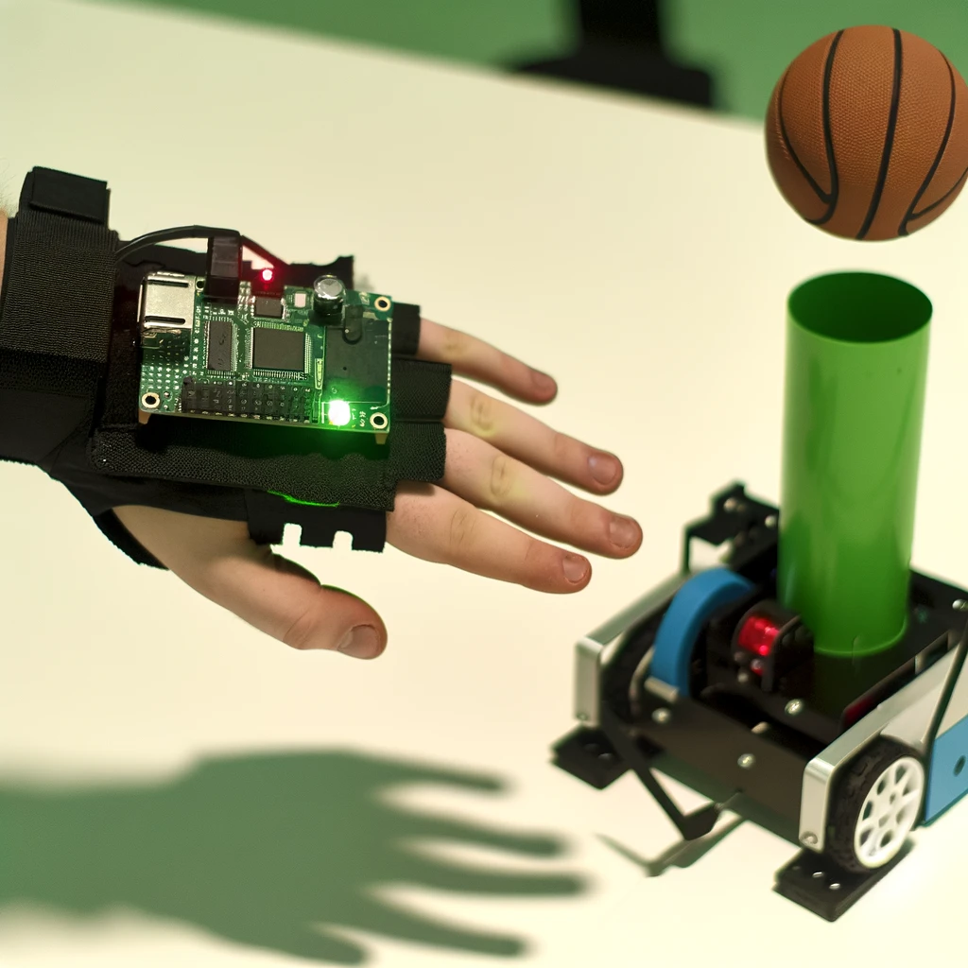
docs/idea.png
