vvinhvvo98/Basketball-Launcher/docs/latex/peashooter.png

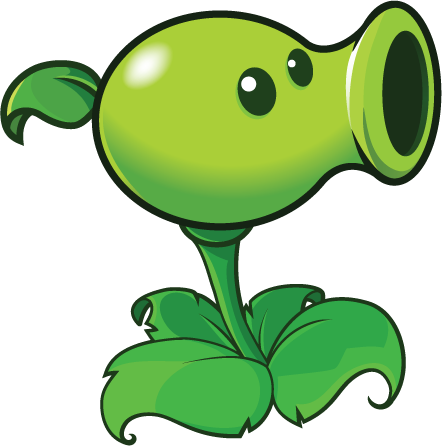
docs/latex/peashooter.png
