vvinhvvo98/Basketball-Launcher/docs/launcher.png

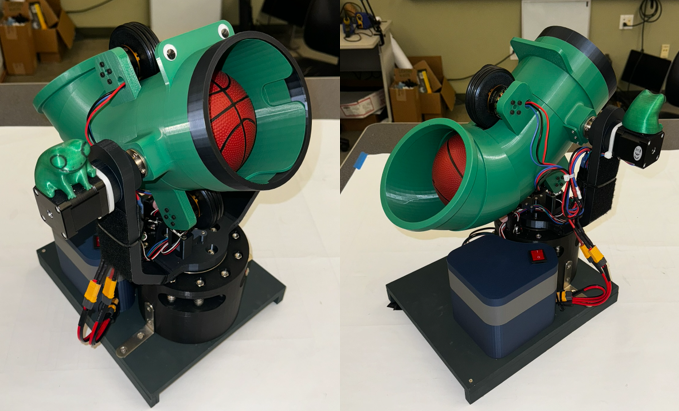
docs/launcher.png
