vvinhvvo98/Basketball-Launcher/docs/limit_switch.png

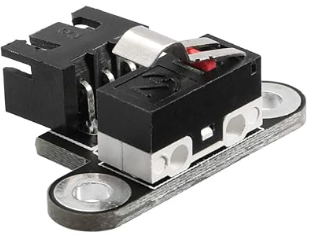
docs/limit_switch.png
