vvinhvvo98/Basketball-Launcher/docs/link.png

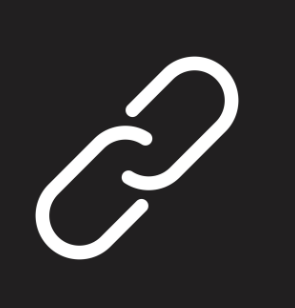
docs/link.png
