vvinhvvo98/Basketball-Launcher/docs/locknut.png

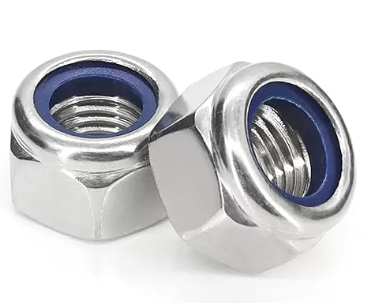
docs/locknut.png
