vvinhvvo98/Basketball-Launcher/docs/nema17.png

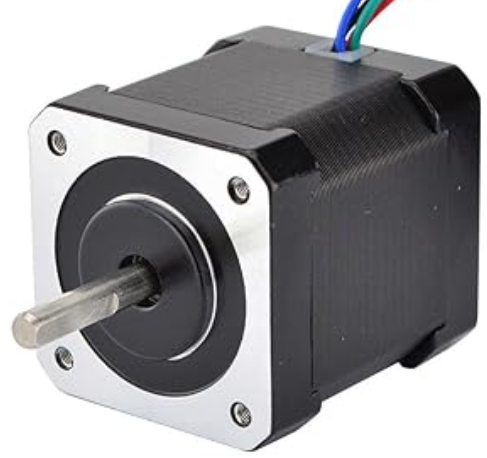
docs/nema17.png
