vvinhvvo98/Basketball-Launcher/docs/nema17_gearbox.png

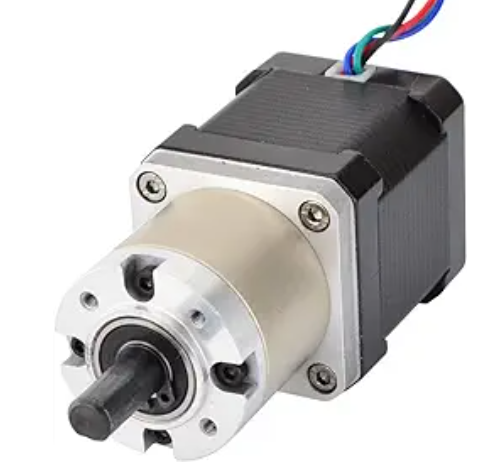
docs/nema17_gearbox.png
