vvinhvvo98/Basketball-Launcher/docs/o_ring.png

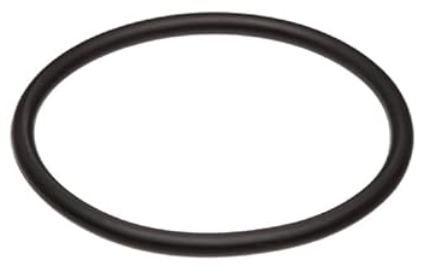
docs/o_ring.png
