vvinhvvo98/Basketball-Launcher/docs/pcb1.png

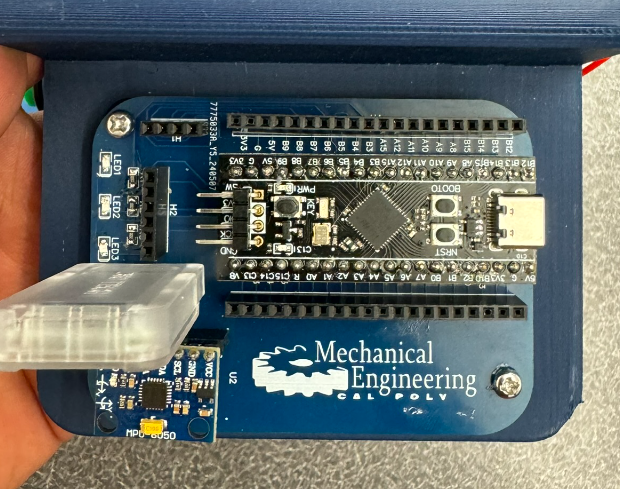
docs/pcb1.png
