vvinhvvo98/Basketball-Launcher/docs/PCBCONTROLLERLAYOUT.png

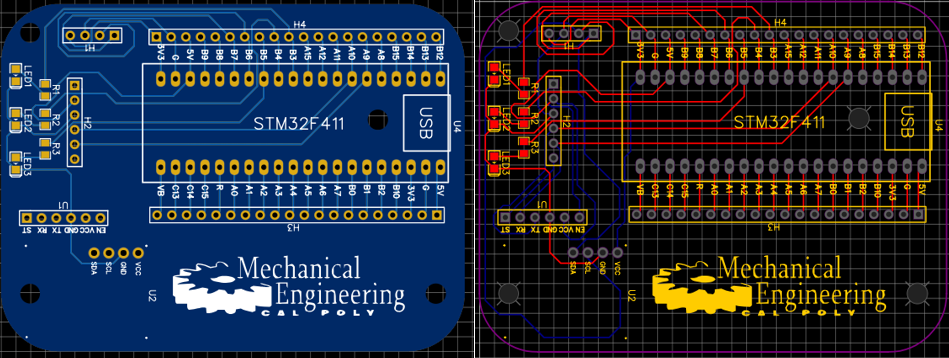
docs/PCBCONTROLLERLAYOUT.png
