vvinhvvo98/Basketball-Launcher/docs/pdf.png

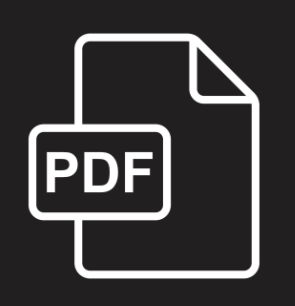
docs/pdf.png
