vvinhvvo98/Basketball-Launcher/docs/pp.png

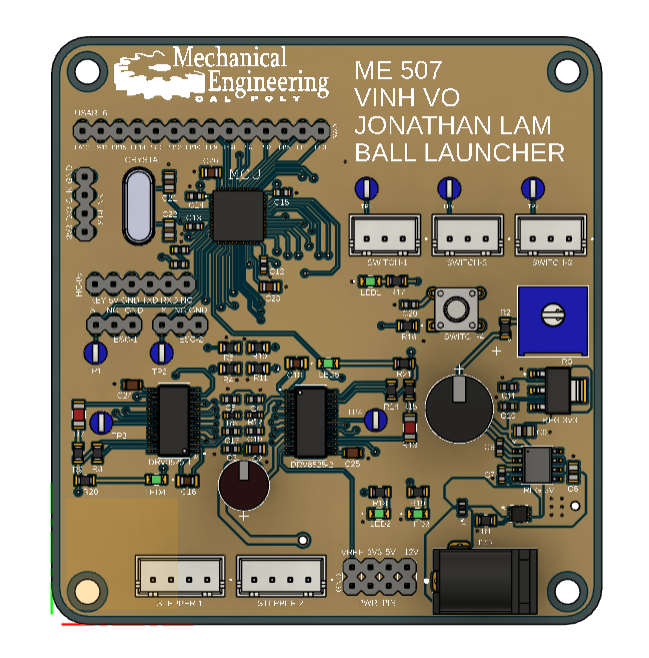
docs/pp.png
