vvinhvvo98/Basketball-Launcher/docs/solidworks.png

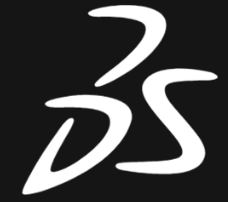
docs/solidworks.png
