vvinhvvo98/Basketball-Launcher/docs/switch.png

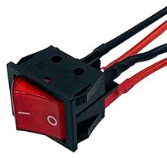
docs/switch.png
