vvinhvvo98/Basketball-Launcher/docs/ubec_esc.png

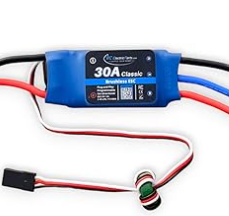
docs/ubec_esc.png
