vvinhvvo98/Basketball-Launcher/docs/xlsx.png

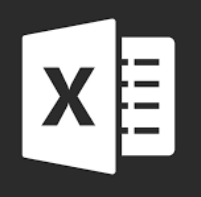
docs/xlsx.png
