vvinhvvo98/Basketball-Launcher/docs/youtube.png

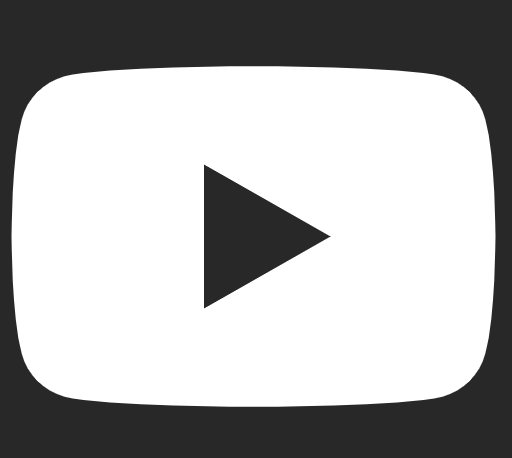
docs/youtube.png
