vvinhvvo98/Basketball-Launcher/images/bp.png

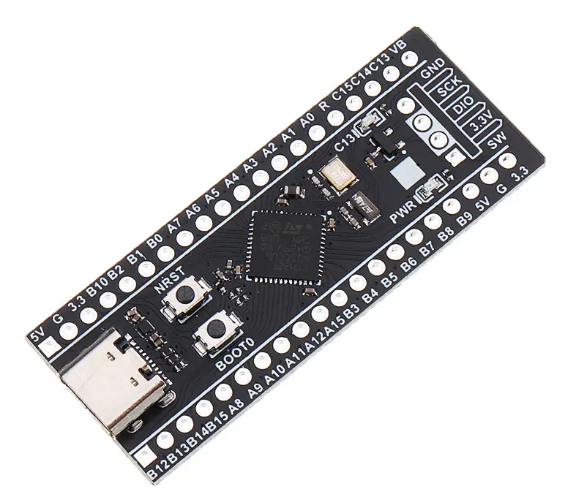
images/bp.png
