vvinhvvo98/Basketball-Launcher/images/brk.png

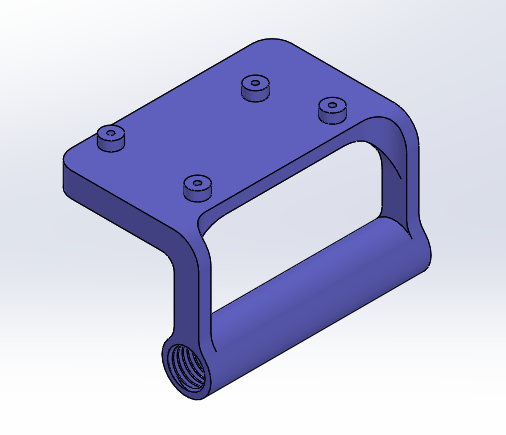
images/brk.png
