vvinhvvo98/Basketball-Launcher/images/button.png

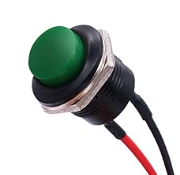
images/button.png
