vvinhvvo98/Basketball-Launcher/images/fp.png

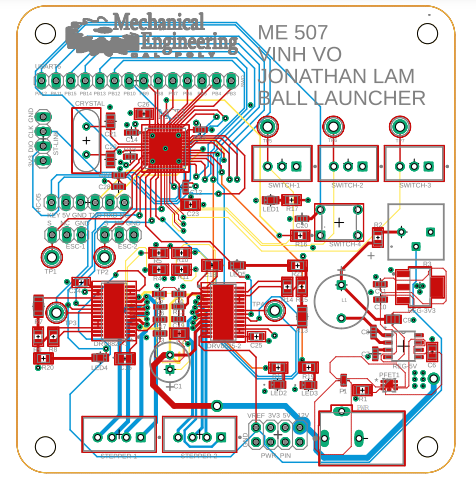
images/fp.png
