vvinhvvo98/Basketball-Launcher/images/hc05.png

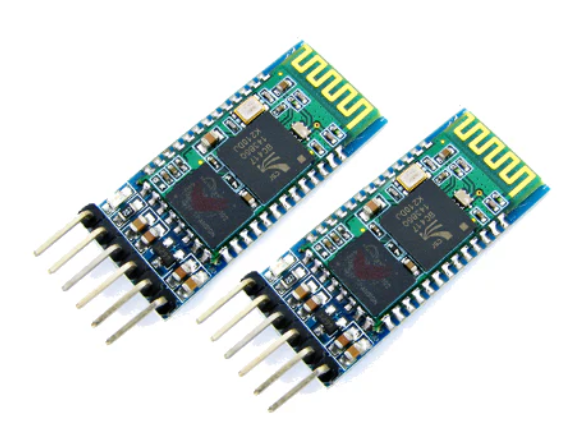
images/hc05.png
