vvinhvvo98/Basketball-Launcher/images/imu.png

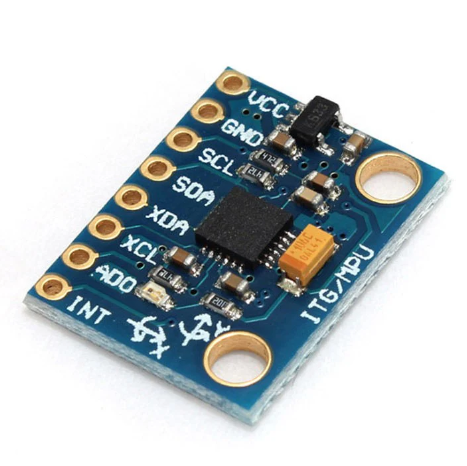
images/imu.png
