vvinhvvo98/Basketball-Launcher/images/led.png

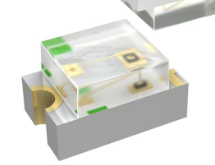
images/led.png
