vvinhvvo98/Basketball-Launcher/images/r.png

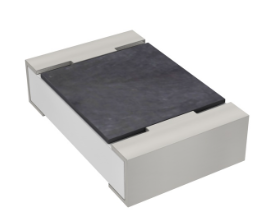
images/r.png
