vvinhvvo98/Basketball-Launcher/REPORTS/BOM(UPDATE).xlsx

Sheet: AMAZON
No | Picture | Parts | Unit Price | Qty | Total Amount
1 | #VALUE! | NEMA17 | $15.00 | 1 | $15.00
2 | #VALUE! | NEMA17 + GEAR BOX | $40.00 | 1 | $40.00
3 | #VALUE! | D421 BLDC | $27.00 | 2 | $54.00
4 | #VALUE! | UBEC ESC | $22.00 | 2 | $44.00
5 | #VALUE! | O RING | $2.00 | 2 | $4.00
6 | #VALUE! | SWITCH | $10.00 | 1 | $10.00
7 | #VALUE! | BASKETBALL | $6.00 | 1 | $6.00
8 | #VALUE! | HC-05 | $10.00 | 2 | $20.00
9 | #VALUE! | LIMIT SWITCH | $1.00 | 3 | $3.00
10 | #VALUE! | CONNECTOR | $10.00 | 1 | $10.00
11 | #VALUE! | CONNECTOR | $3.00 | 2 | $6.00
12 | #VALUE! | BATTERY | $18.00 | 2 | $36.00
13 | #VALUE! | FILLAMENT | $20.00 | 4 | $80.00
14 | #VALUE! | BEARINGS | $10.00 | 2 | $20.00
15 | #VALUE! | BEARINGS | $10.00 | 3 | $30.00
16 | #VALUE! | BEARINGS | $6.00 | 2 | $12.00
17 | #VALUE! | BEARINGS | $10.00 | 1 | $10.00
18 | #VALUE! | NUTS | $6.00 | 1 | $6.00
19 | #VALUE! | NUTS | $10.00 | 1 | $10.00
20 | #VALUE! | BOLTS | $10.00 | 2 | $20.00
 |  |  |  |  | $436.00

Sheet: DIGIKEY
No | Syms | Parts | Picture | Number Part | Amount | Cost | Total | Buy | Cost | Links
CONNECTORS
1 | PWR | CONN PWR JACK 2X5.5MM SOLDER | #VALUE! | PJ-102AH | 1 | $0.70 | $0.70 | 1 | $0.70 | https://www.digikey.com/en/products/detail/cui-devices/PJ-102AH/408448
2 | SWITCH-1 SWITCH-2 SWITCH-3 | CONN HEADER VERT 3POS 2.5MM | #VALUE! | B3B-XH-A | 3 | $0.21 | $0.63 | 4 | $0.84 | https://www.digikey.com/en/products/detail/jst-sales-america-inc/B3B-XH-A/1651046
3 | STEPPER-1 STEPPER-2 | CONN HEADER VERT 4POS 2.5MM | #VALUE! | B4B-XH-A | 2 | $0.23 | $0.46 | 3 | $0.69 | https://www.digikey.com/en/products/detail/jst-sales-america-inc/B4B-XH-A/1651047
CAPACITORS
4 | C16 C18 | CAP CER 0805 10NF 100V C0G 5% | #VALUE! | C0805C103J1GEC7800 | 2 | $0.14 | $0.29 | 4 | $0.58 | https://www.digikey.com/en/products/detail/kemet/C0805C103J1GEC7800/8644543
5 | C3, C4, C5 C8, C12, C13, C14,C15, C17, C19, C20, C27 | CAP CER 0.1UF 25V X7R 0603 | #VALUE! | CC0603KRX7R8BB104 | 12 | $0.10 | $1.20 | 20 | $2.00 | https://www.digikey.com/en/products/detail/yageo/CC0603KRX7R8BB104/2103079
6 | C2,C23 | CAP CER 4.7UF 25V X5R 0805 | #VALUE! | C2012X5R1E475K125AB | 2 | $0.19 | $0.38 | 5 | $0.95 | https://www.digikey.com/en/products/detail/tdk-corporation/C2012X5R1E475K125AB/1986842
7 | C6 | CAP CER 10UF 25V X5R 0805 | #VALUE! | CC0805KRX5R8BB106 | 1 | $0.38 | $0.38 | 3 | $1.14 | https://www.digikey.com/en/products/detail/yageo/CC0805KRX5R8BB106/7164524
8 | C1 | CAP ALUM 100UF 20% 25V RADIAL | #VALUE! | 860020473008 | 1 | $0.13 | $0.13 | 2 | $0.26 | https://www.digikey.com/en/products/detail/w%C3%BCrth-elektronik/860020473008/5727062
9 | C7, C10, C11, C28 | CAP CER 1UF 25V X5R 0603 | #VALUE! | CC0603KRX5R8BB105 | 4 | $0.10 | $0.40 | 10 | $1.00 | https://www.digikey.com/en/products/detail/yageo/CC0603KRX5R8BB105/2833610
10 | C9 | CAP CER 22UF 25V X5R 0805 | #VALUE! | CC0805MKX5R8BB226 | 1 | $0.41 | $0.41 | 3 | $1.23 | https://www.digikey.com/en/products/detail/yageo/CC0805MKX5R8BB226/5195309
11 | C21,C22 | CAP CER 30PF 25V NP0 0805 | #VALUE! | C0805C300M3GAC7800 | 2 | $0.24 | $0.48 | 5 | $1.20 | https://www.digikey.com/en/products/detail/kemet/C0805C300M3GAC7800/2212480?
12 | C24, C25 | CAP CER 0.47UF 25V X7R 0805 | #VALUE! | CGA4J2X7R1E474K125AA | 2 | $0.24 | $0.48 | 5 | $1.20 | https://www.digikey.com/en/products/detail/tdk-corporation/CGA4J2X7R1E474K125AA/2443725
RESISTORS
13 | R3 | TRIMMER 5K OHM 0.5W PC PIN TOP | #VALUE! | 3386P-1-502LF | 1 | $1.77 | $1.77 | 1 | $1.77 | https://www.digikey.com.br/en/models/1088535
14 | R2 | RES 50K OHM 0.1% 1/8W 0805 | #VALUE! | MCU08050D5002BP100 | 1 | $0.85 | $0.85 | 2 | $1.70 | https://www.digikey.com.br/en/products/detail/vishay-beyschlag-draloric-bc-components/MCU08050D5002BP100/8125783
14 | R1,R8,R9,R14,R15, R16 | RES 10K OHM 1% 1/8W 0805 | #VALUE! | RC0805FR-0710KL | 6 | $0.10 | $0.60 | 12 | $1.20 | https://www.digikey.com/en/products/detail/yageo/RC0805FR-0710KL/727535
15 | R7,R13 | RES 1.5K OHM 1% 1/4W 1206 | #VALUE! | RC1206FR-071K5L | 2 | $0.10 | $0.20 | 5 | $0.50 | https://www.digikey.com/en/products/detail/yageo/RC1206FR-071K5L/728441
16 | R6, R12 | RES SMD 1M OHM 1% 1/10W 0603 | #VALUE! | ERJ-3EKF1004V | 2 | $0.10 | $0.20 | 5 | $0.50 | https://www.digikey.com/en/products/detail/panasonic-electronic-components/ERJ-3EKF1004V/196033
17 | R4, R5,R10, R11 | RES 0.1 OHM 1% 1/4W 0805 | #VALUE! | ERJ-U6SFR10V | 4 | $0.66 | $2.64 | 8 | $5.28 | https://www.digikey.com/en/products/detail/panasonic-electronic-components/ERJ-U6SFR10V/2811822
18 | R17, R18, R19, R20, R21 | RES 200 OHM 1% 1/8W 0805 | #VALUE! | RC0805FR-07200RL | 5 | $0.10 | $0.50 | 10 | $1.00 | https://www.digikey.com/en/products/detail/yageo/RC0805FR-07200RL/727723
OTHERS
19 | F1 | FUSE BOARD MOUNT 4A 32VDC 0603 | #VALUE! | MFU0603FF04000P500 | 1 | $0.24 | $0.24 | 2 | $0.48 | https://www.digikey.com/en/products/detail/vishay-beyschlag-draloric-bc-components/MFU0603FF04000P500/1202614
20 | L1 | FIXED IND 33UH 1.7A 120 MOHM TH | #VALUE! | RLB0914-330KL | 1 | $0.42 | $0.42 | 2 | $0.84 | https://www.digikey.com/en/products/detail/bourns-inc/RLB0914-330KL/2561360
21 | SWITCH-4 | SWITCH TACTILE SPST-NO 0.05A 12V | #VALUE! | TL1105BF160Q | 1 | $0.20 | $0.20 | 2 | $0.40 | https://www.digikey.com/en/products/detail/e-switch/TL1105BF160Q/1358
22 | CRYSTAL | CRYSTAL 25.0000MHZ 20PF TH | #VALUE! | 631-FC4STCBMF25.0-ND | 1 | $0.34 | $0.34 | 2 | $0.68 | https://www.digikey.com/en/products/detail/fox-electronics/FC4STCBMF25-0/1024704
23 | TP1, TP2, TP3, TP4, TP5, TP6, TP7, TP8, TP9, TP 10 | PC TEST POINT MULTIPURPOSE BLUE | #VALUE! | 36-5127-ND | 10 | $0.38 | $3.80 | 10 | $3.80 | https://www.digikey.com/en/products/detail/keystone-electronics/5127/2170330
24 | LED 1, LED 2, LED 3, LED 4, LED 5 | LED BLUE CLEAR 0805 SMD | #VALUE! | VAOL-S8SB4 | 5 | $0.72 | $3.60 | 6 | $4.32 | https://www.digikey.com/en/models/4515728
IC
25 | REG-3V3 | IC REG LINEAR 3.3V 1A SOT223-4 | #VALUE! | TLV1117LV33DCYR | 1 | $0.35 | $0.35 | 2 | $0.70 | https://www.digikey.com/en/products/detail/texas-instruments/TLV1117LV33DCYR/2666508
26 | PFET1 | MOSFET P-CH 12V 8.2A DFN2020MD-6 | #VALUE! | PMPB15XP,115 | 1 | $0.47 | $0.47 | 2 | $0.94 | https://www.digikey.com/en/products/detail/nexperia-usa-inc/PMPB15XP-115/3679489
27 | REG-5V | IC REG BUCK 5V 1.5A 8SO | #VALUE! | L6981N50DR | 1 | $2.87 | $2.87 | 1 | $2.87 | https://www.digikey.com/en/products/detail/stmicroelectronics/L6981N50DR/16841560
28 | MCU | IC MCU 32BIT 512KB FLSH 48UFQFPN | #VALUE! | STM32F411CEU6 | 1 | $7.40 | $7.40 | 1 | $7.40 | https://www.digikey.com/en/products/detail/stmicroelectronics/STM32F411CEU6/4935720
29 | DRV8825-1 DRV8825-2 | IC MTR DRVR BIPLR 8.2-45V 28SSOP | #VALUE! | DRV8825 | 2 | $5.65 | $11.30 | 2 | $11.30 | https://www.digikey.com/en/products/detail/texas-instruments/DRV8825PWPR/2695909
30 | PCB | PCB ORDER | #VALUE! | MAIN PCB | 1 | $72.28 | $72.28 | 1 | $72.28 | https://jlcpcb.com/
 | PCB | PCB ORDER |  | CONTROL PCB | 1 | $26.42 | $26.42 | 1 | $26.42 | https://jlcpcb.com/
 |  |  |  | Total | 81 |  | $142.39 |  | $156.17
