vvinhvvo98/Basketball-Launcher/docs/bom.png

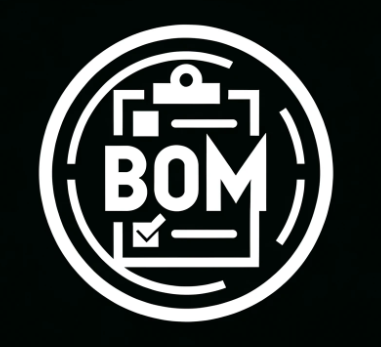
docs/bom.png
