vvinhvvo98/Basketball-Launcher/CAD/Controller_CAD/Assem2.SLDASM

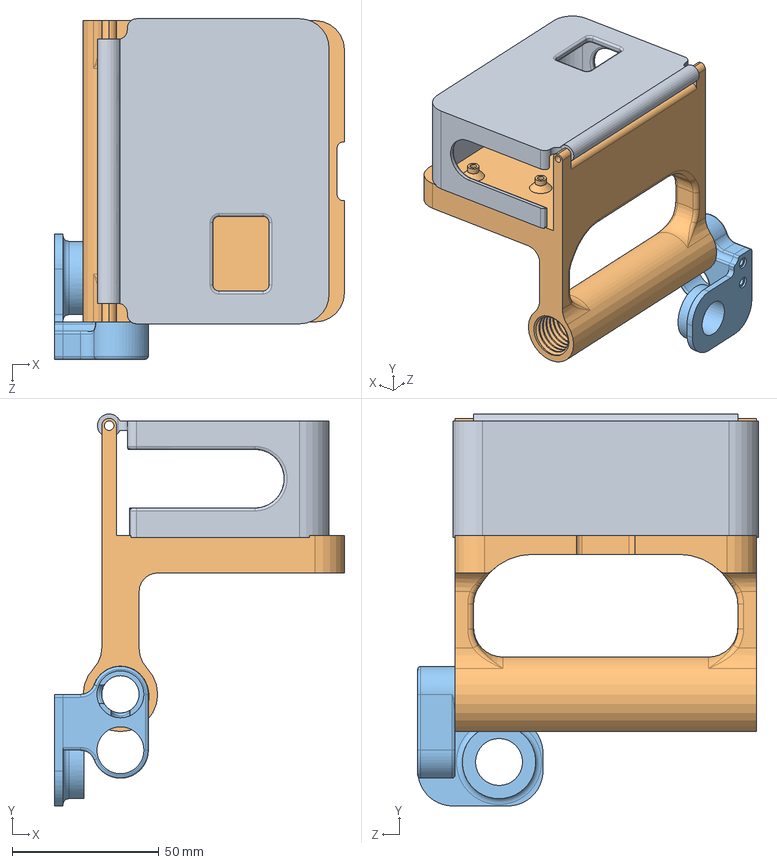
[picture p74: CAD file, 2024-06-01]
CAD/Controller_CAD/Assem2.SLDASM
98.8 x 133.6 x 116.0 mm
