vvinhvvo98/Basketball-Launcher/CAD/Launcher_CAD/Cycloidal Gear Box/Parts/ASSY/Nuts.SLDASM

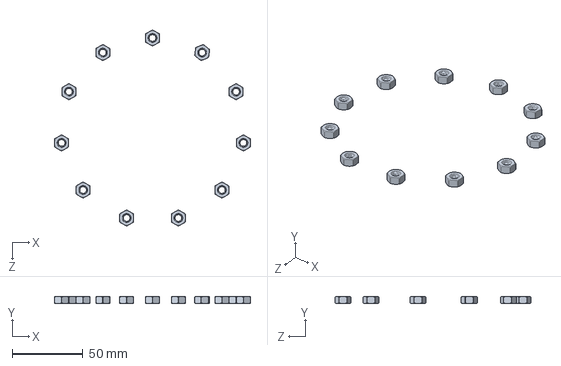
[picture p75: CAD file, 2024-05-14]
CAD/Launcher_CAD/Cycloidal Gear Box/Parts/ASSY/Nuts.SLDASM
138.7 x 5.00 x 138.8 mm
90592A016_Steel Hex Nut x 11
