vvinhvvo98/Basketball-Launcher/CAD/Launcher_CAD/Cycloidal Gear Box/Parts/ASSY/Bearings.SLDASM

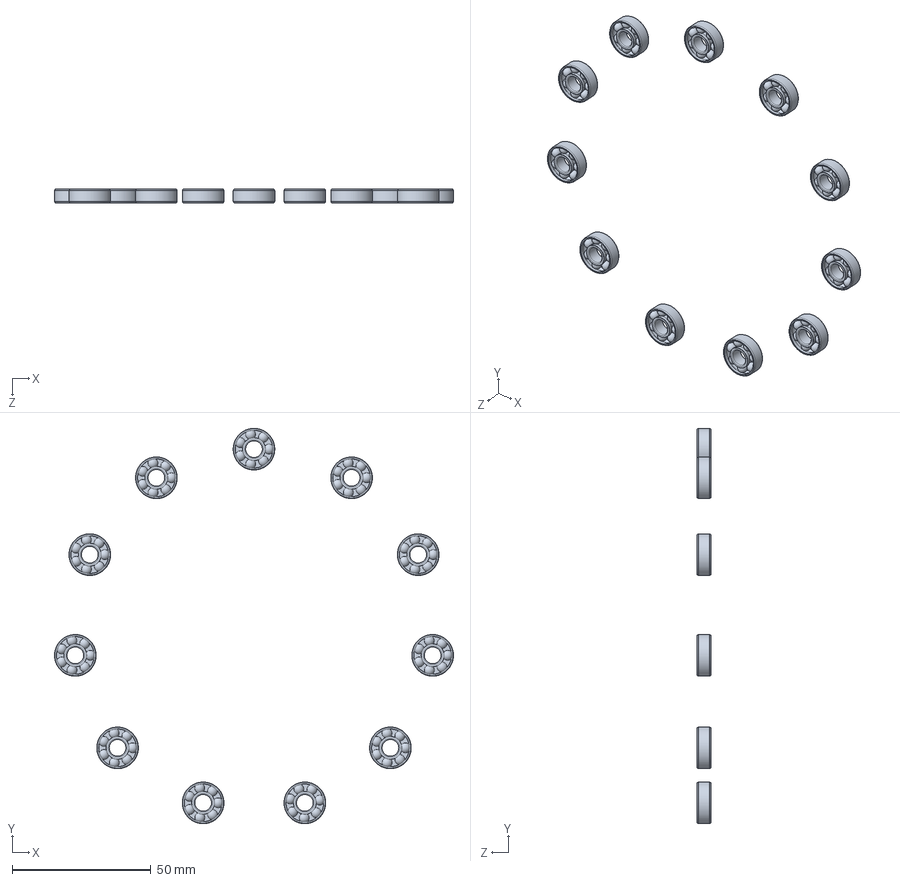
[picture p76: CAD file, 2024-05-14]
CAD/Launcher_CAD/Cycloidal Gear Box/Parts/ASSY/Bearings.SLDASM
143.7 x 142.4 x 5.00 mm
4668K121_Permanently Lubricated Stainless Steel Ball Bearing x 11
