vvinhvvo98/Basketball-Launcher/CAD/Launcher_CAD/Cycloidal Gear Box/Parts/Cycloidal Disk 2.SLDPRT

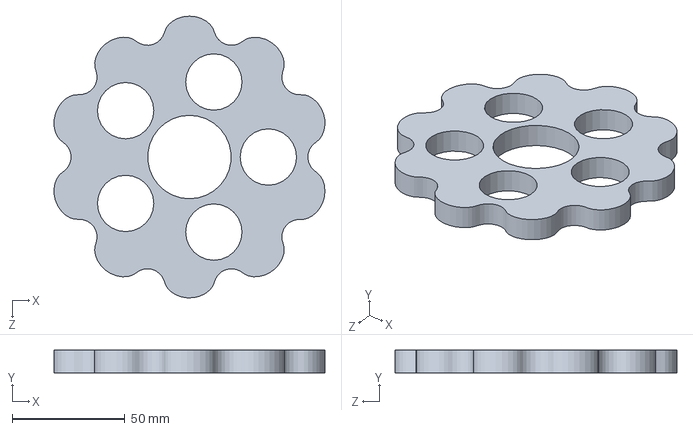
[picture p77: CAD file, 2024-05-14]
CAD/Launcher_CAD/Cycloidal Gear Box/Parts/Cycloidal Disk 2.SLDPRT
120.2 x 10.0 x 125.0 mm
