vvinhvvo98/Basketball-Launcher/CAD/Launcher_CAD/D4215 motor/D4215 Shaft.SLDPRT

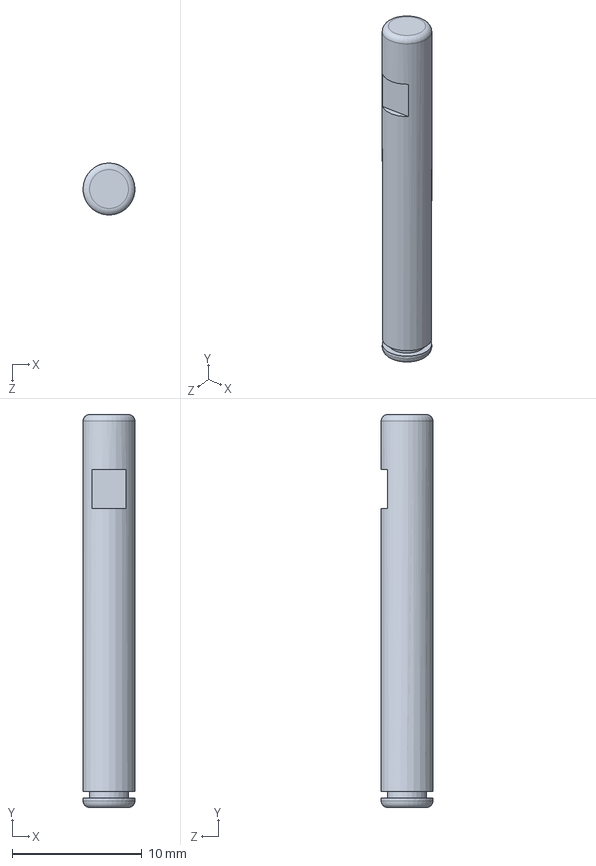
[picture p78: CAD file, 2024-05-14]
CAD/Launcher_CAD/D4215 motor/D4215 Shaft.SLDPRT
4.00 x 30.2 x 4.00 mm
