vvinhvvo98/Basketball-Launcher/CAD/Launcher_CAD/Stands.SLDPRT

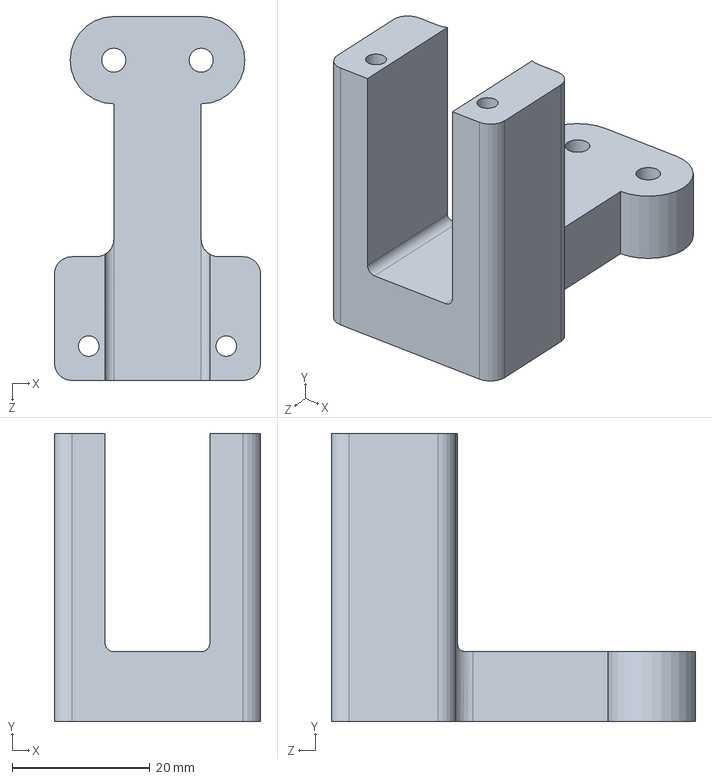
[picture p79: CAD file, 2024-06-13]
CAD/Launcher_CAD/Stands.SLDPRT
30.0 x 41.9 x 52.9 mm
