vvinhvvo98/Basketball-Launcher/CAD/Controller_CAD/Part2.SLDPRT

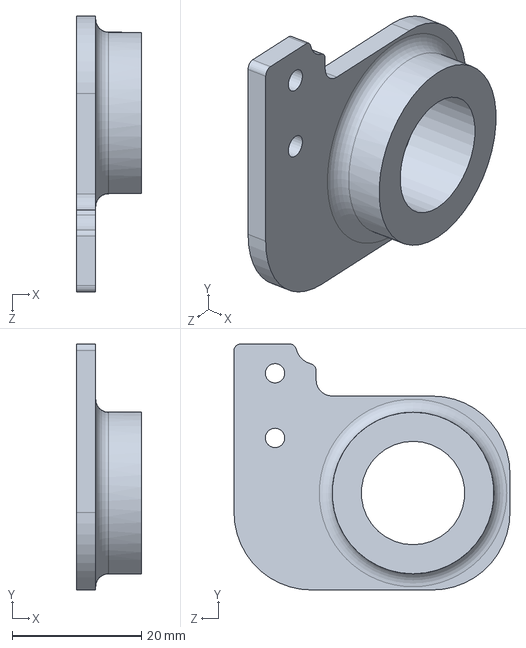
[picture p80: CAD file, 2024-06-01]
CAD/Controller_CAD/Part2.SLDPRT
10.0 x 38.0 x 42.7 mm
