vvinhvvo98/Basketball-Launcher/CAD/Launcher_CAD/lever.SLDPRT

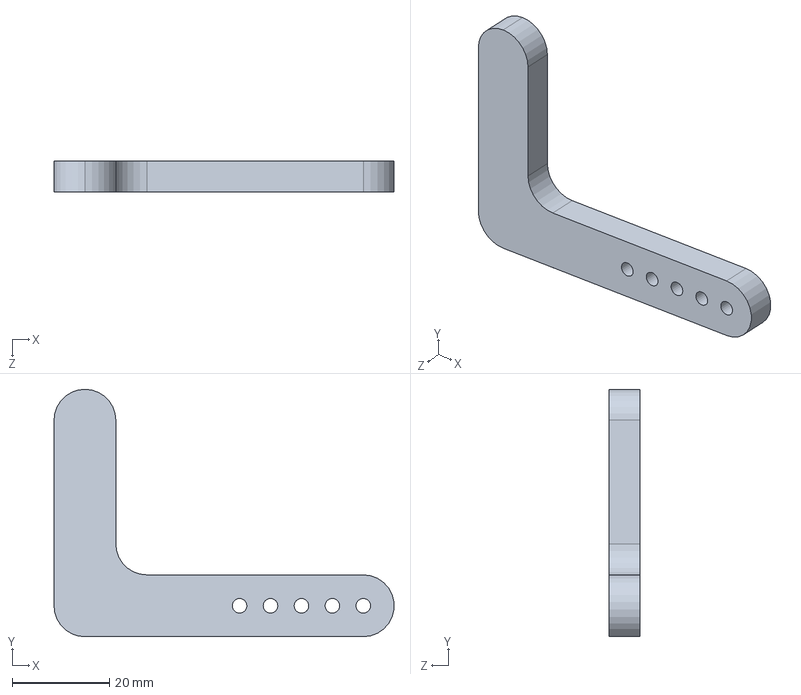
[picture p81: CAD file, 2024-06-03]
CAD/Launcher_CAD/lever.SLDPRT
69.8 x 50.8 x 6.35 mm
