vvinhvvo98/Basketball-Launcher/CAD/Controller_CAD/Part3.SLDPRT

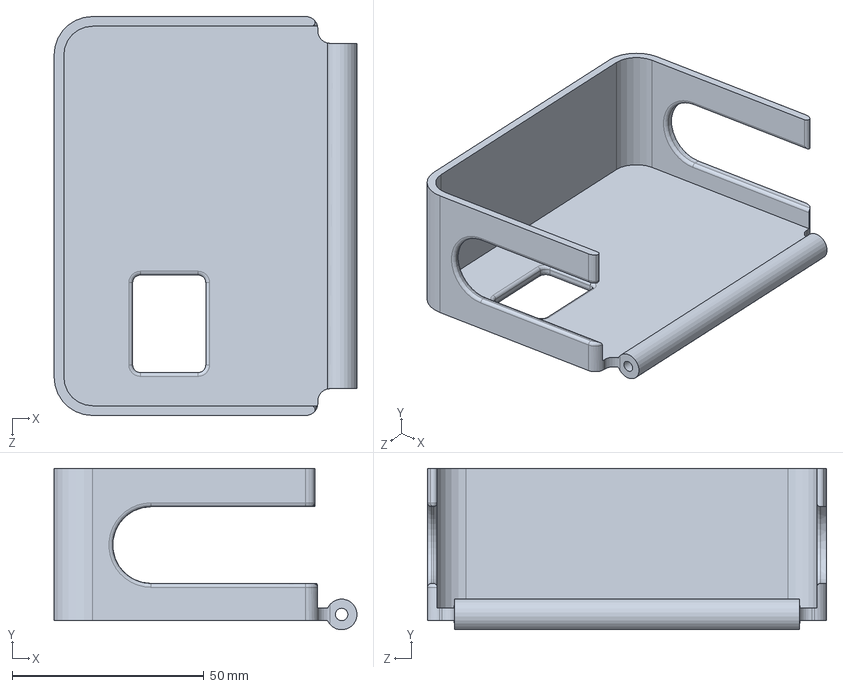
[picture p82: CAD file, 2024-05-22]
CAD/Controller_CAD/Part3.SLDPRT
78.9 x 42.0 x 104.0 mm
