vvinhvvo98/Basketball-Launcher/CAD/Launcher_CAD/D4215 motor/D4215 Rotor Top.SLDPRT

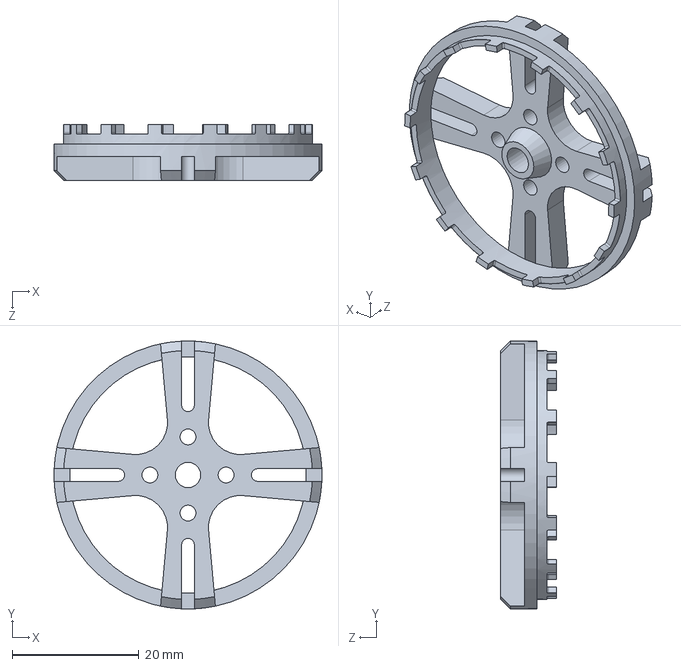
[picture p83: CAD file, 2024-05-14]
CAD/Launcher_CAD/D4215 motor/D4215 Rotor Top.SLDPRT
42.2 x 42.2 x 8.75 mm
