vvinhvvo98/Basketball-Launcher/CAD/Launcher_CAD/mg90s-horn.SLDPRT

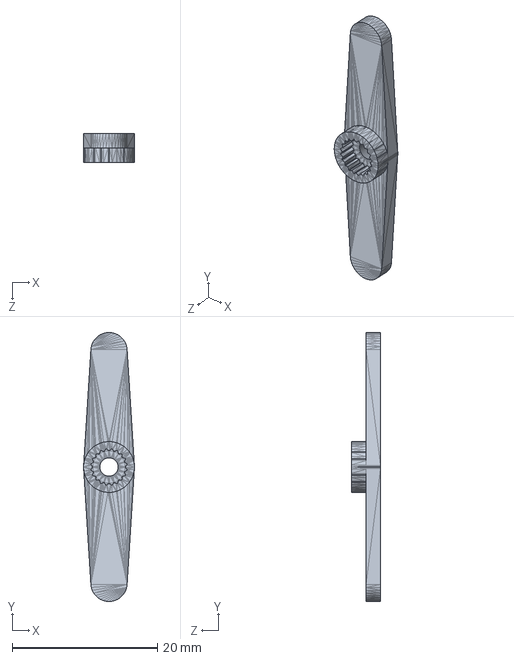
[picture p84: CAD file, 2024-06-03]
CAD/Launcher_CAD/mg90s-horn.SLDPRT
7.00 x 37.0 x 4.00 mm
