vvinhvvo98/Basketball-Launcher/CAD/Controller_CAD/Part1.SLDPRT

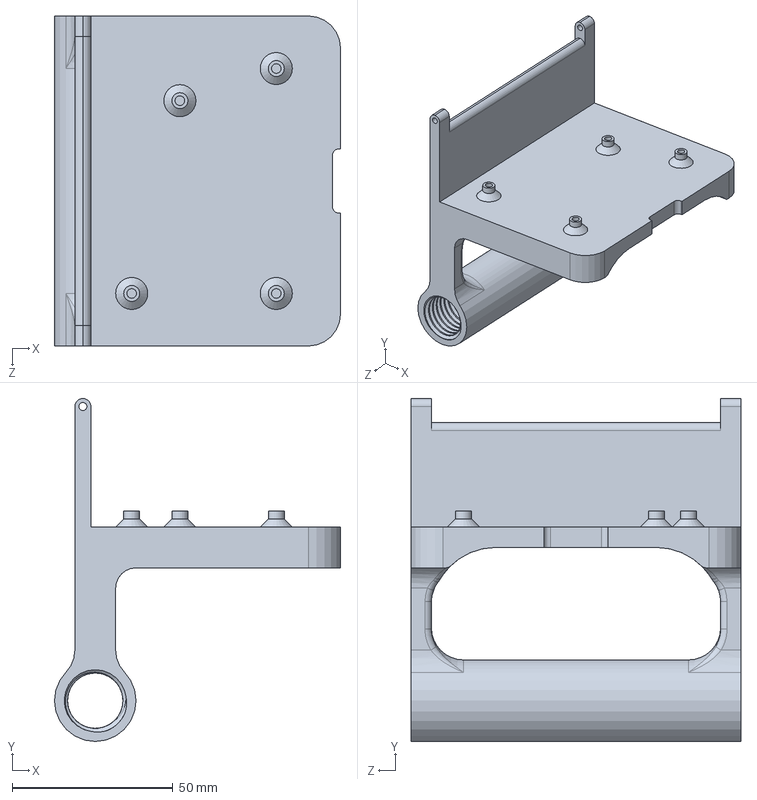
[picture p85: CAD file, 2024-05-20]
CAD/Controller_CAD/Part1.SLDPRT
89.1 x 106.8 x 102.7 mm
