vvinhvvo98/Basketball-Launcher/CAD/Launcher_CAD/Pipe2.SLDPRT

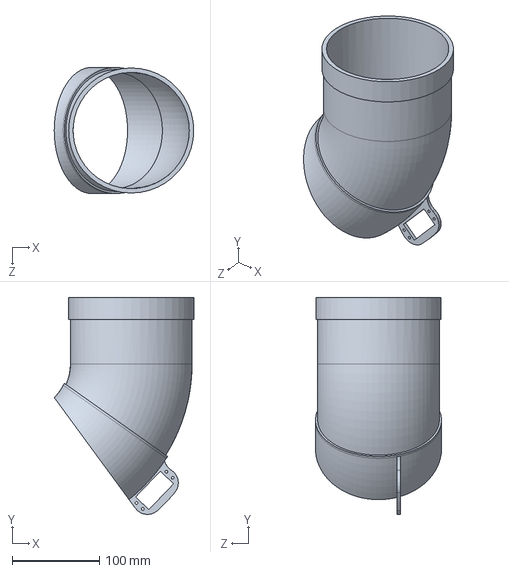
[picture p86: CAD file, 2024-06-03]
CAD/Launcher_CAD/Pipe2.SLDPRT
160.1 x 249.0 x 144.8 mm
