vvinhvvo98/Basketball-Launcher/CAD/Launcher_CAD/Cycloidal Gear Box/Parts/Box.SLDPRT

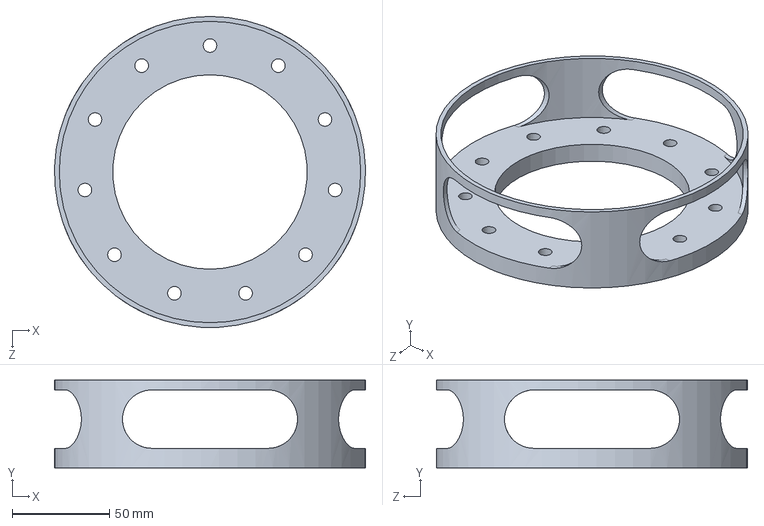
[picture p87: CAD file, 2024-05-14]
CAD/Launcher_CAD/Cycloidal Gear Box/Parts/Box.SLDPRT
159.9 x 45.0 x 160.0 mm
