vvinhvvo98/Basketball-Launcher/CAD/Launcher_CAD/D4215 motor/7804K1_Stainless Steel Ball Bearing.SLDPRT

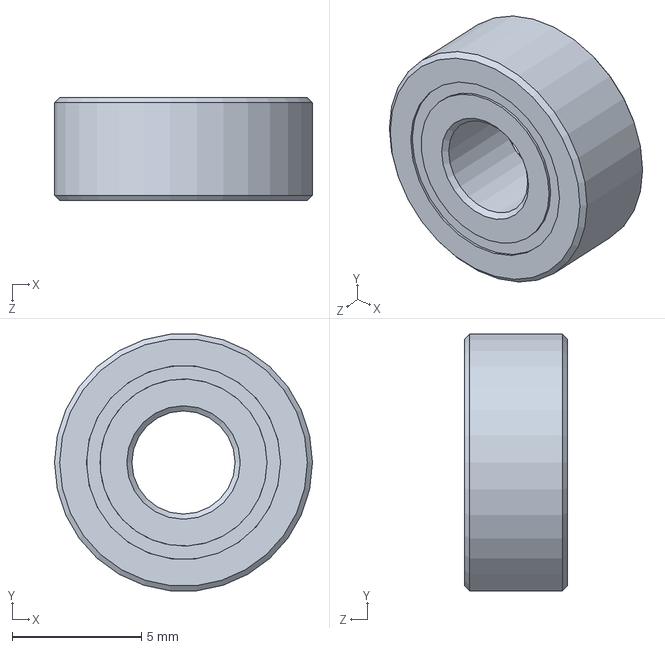
[picture p88: CAD file, 2024-05-14]
CAD/Launcher_CAD/D4215 motor/7804K1_Stainless Steel Ball Bearing.SLDPRT
10.0 x 9.95 x 4.00 mm
