vvinhvvo98/Basketball-Launcher/CAD/Launcher_CAD/servo motor (mg90s) v1.step

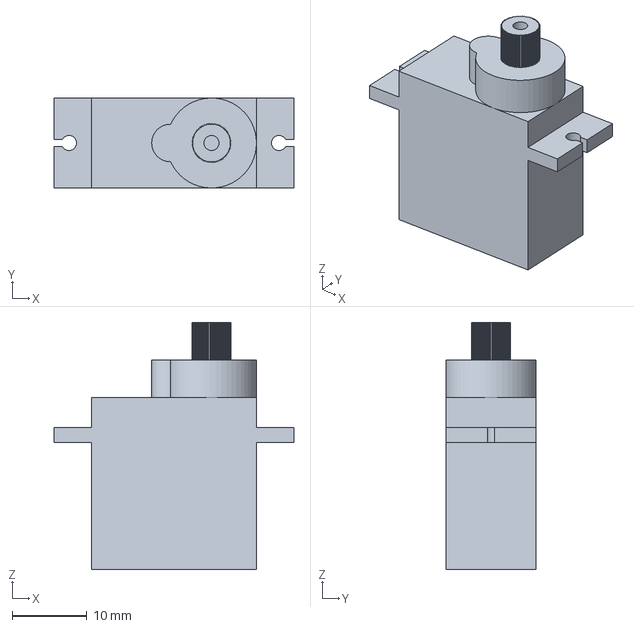
[picture p89: CAD file, 2024-06-01]
CAD/Launcher_CAD/servo motor (mg90s) v1.step
32.0 x 12.0 x 33.0 mm
