vvinhvvo98/Basketball-Launcher/CAD/Launcher_CAD/Ball.SLDPRT

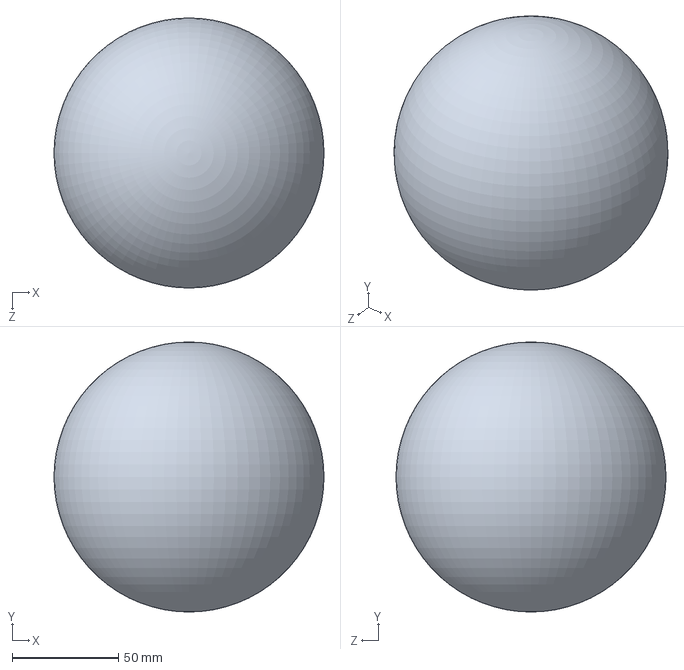
[picture p90: CAD file, 2024-06-01]
CAD/Launcher_CAD/Ball.SLDPRT
127.0 x 127.0 x 127.0 mm
