vvinhvvo98/Basketball-Launcher/CAD/Launcher_CAD/Cycloidal Gear Box/Parts/Input Shaft.SLDPRT

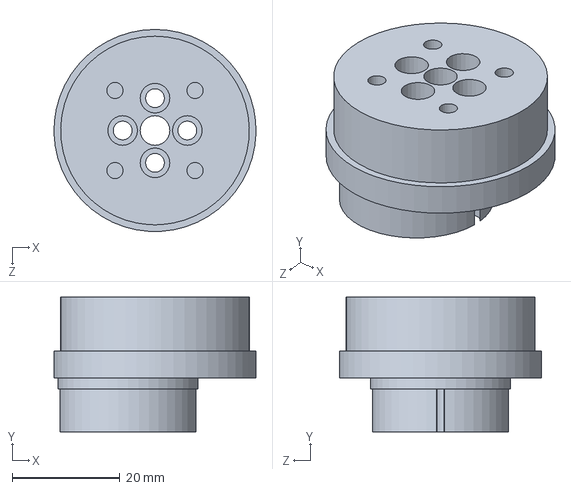
[picture p91: CAD file, 2024-05-14]
CAD/Launcher_CAD/Cycloidal Gear Box/Parts/Input Shaft.SLDPRT
37.5 x 25.0 x 37.5 mm
