vvinhvvo98/Basketball-Launcher/CAD/Launcher_CAD/D4215 motor/D4215 Stator.SLDPRT

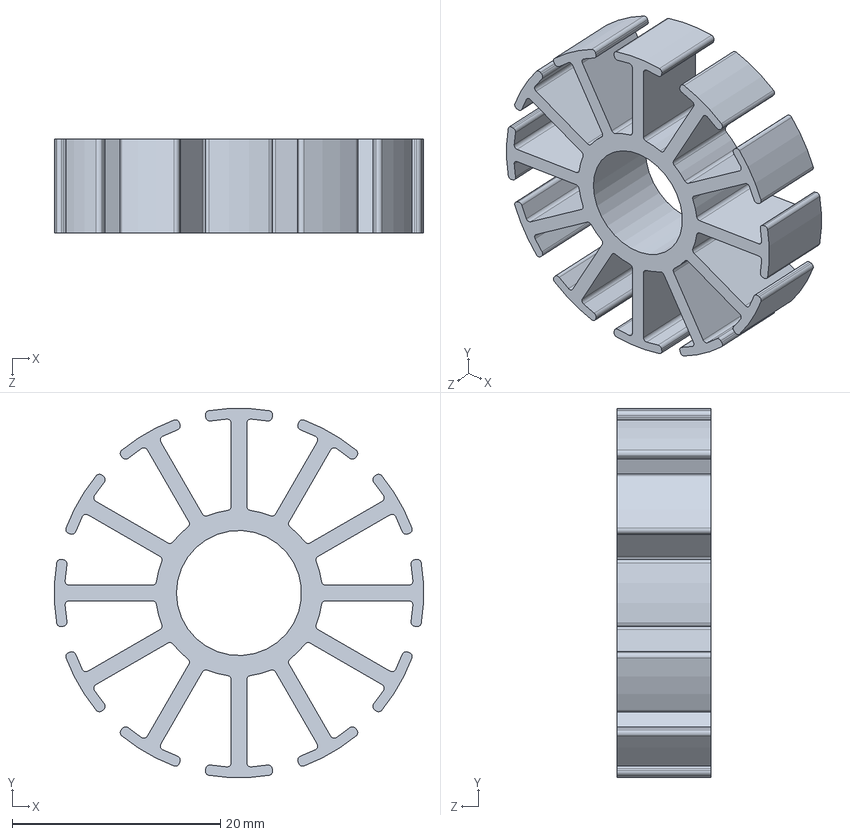
[picture p92: CAD file, 2024-05-14]
CAD/Launcher_CAD/D4215 motor/D4215 Stator.SLDPRT
35.4 x 35.4 x 9.00 mm
