vvinhvvo98/Basketball-Launcher/CAD/Launcher_CAD/Cycloidal Gear Box/Parts/Stepper.SLDPRT

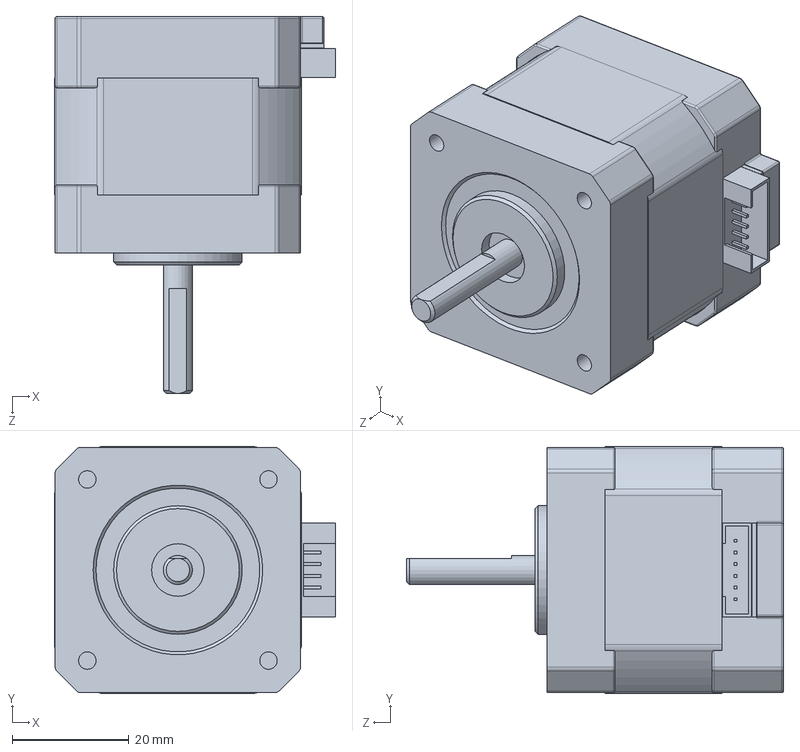
[picture p93: CAD file, 2024-05-14]
CAD/Launcher_CAD/Cycloidal Gear Box/Parts/Stepper.SLDPRT
48.2 x 42.3 x 64.5 mm
