vvinhvvo98/Basketball-Launcher/CAD/Launcher_CAD/Pipe.SLDPRT

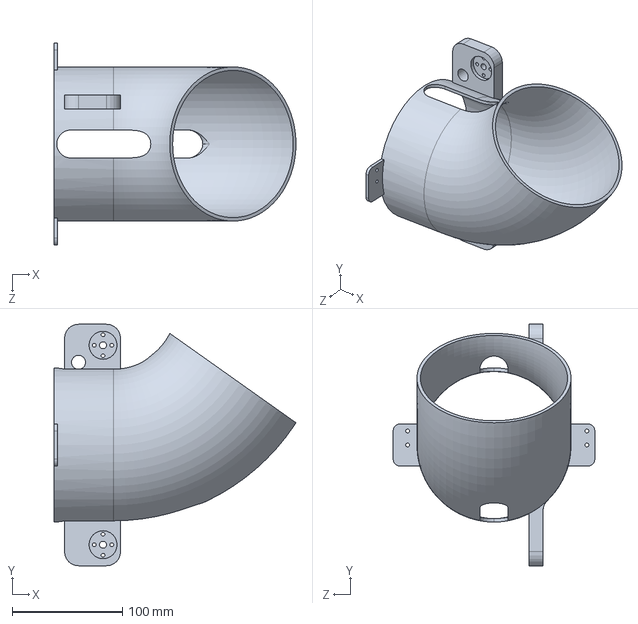
[picture p94: CAD file, 2024-06-01]
CAD/Launcher_CAD/Pipe.SLDPRT
219.3 x 218.9 x 182.9 mm
