vvinhvvo98/Basketball-Launcher/CAD/Launcher_CAD/Cycloidal Gear Box/Parts/Cover.SLDPRT

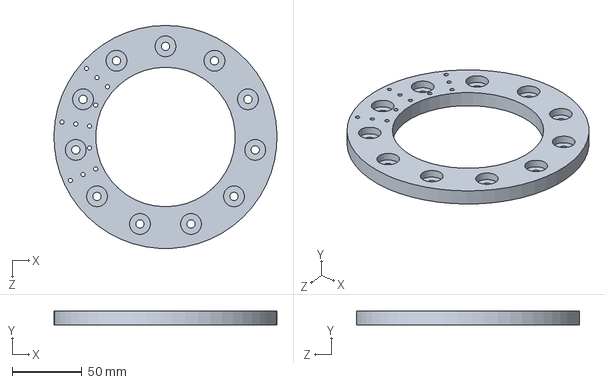
[picture p95: CAD file, 2024-05-14]
CAD/Launcher_CAD/Cycloidal Gear Box/Parts/Cover.SLDPRT
159.9 x 10.0 x 160.0 mm
