vvinhvvo98/Basketball-Launcher/CAD/Launcher_CAD/D4215 motor/D4215 Stator Base.SLDPRT

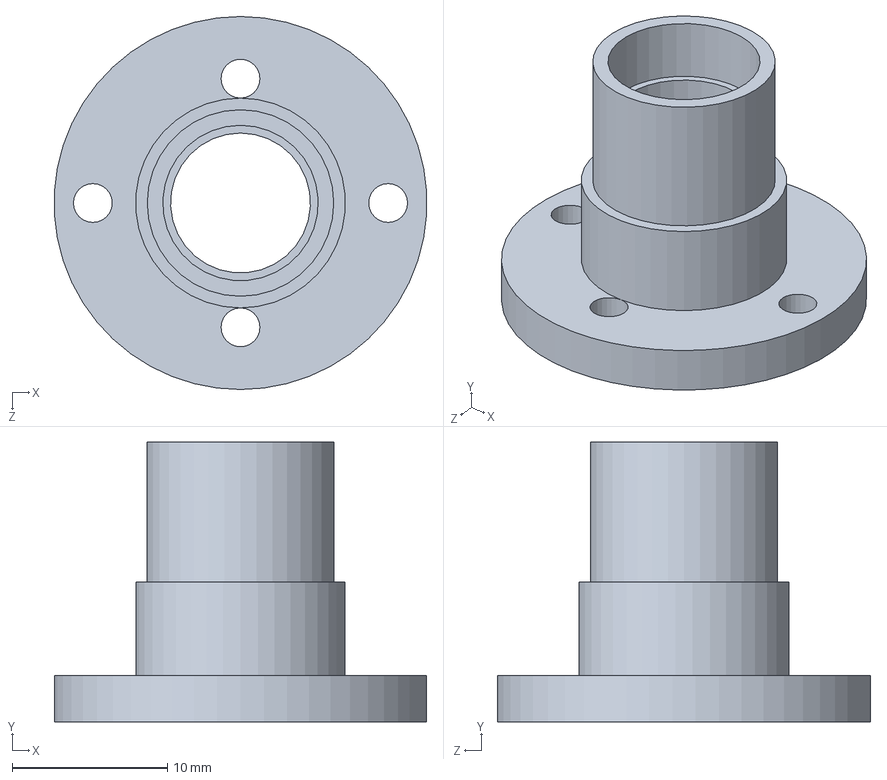
[picture p96: CAD file, 2024-05-14]
CAD/Launcher_CAD/D4215 motor/D4215 Stator Base.SLDPRT
24.0 x 18.0 x 24.0 mm
