vvinhvvo98/Basketball-Launcher/CAD/Launcher_CAD/PCBA Box.SLDPRT

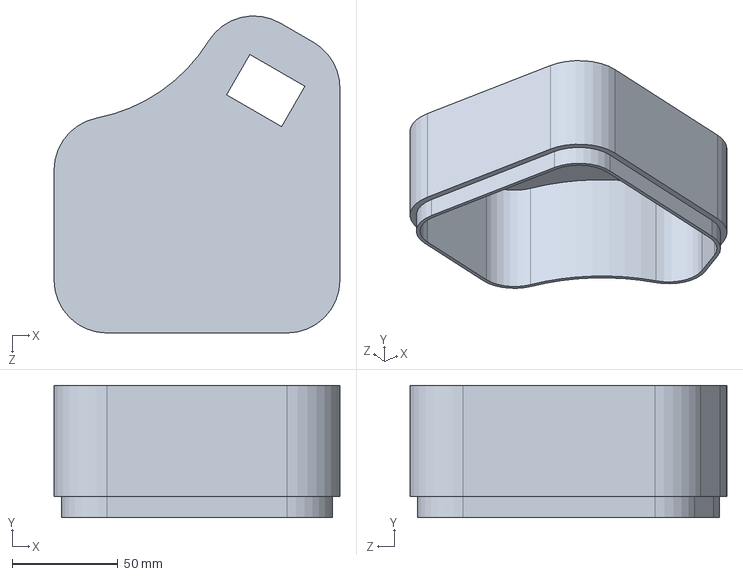
[picture p97: CAD file, 2024-05-30]
CAD/Launcher_CAD/PCBA Box.SLDPRT
135.0 x 62.5 x 149.6 mm
