vvinhvvo98/Basketball-Launcher/CAD/Launcher_CAD/Base2.SLDPRT

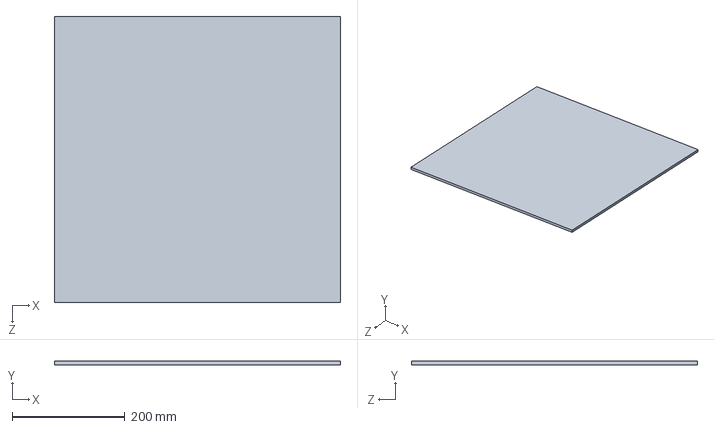
[picture p98: CAD file, 2024-05-20]
CAD/Launcher_CAD/Base2.SLDPRT
508.0 x 6.35 x 508.0 mm
