vvinhvvo98/Basketball-Launcher/CAD/Launcher_CAD/Cycloidal Gear Box/Parts/Bearing Ring.SLDPRT

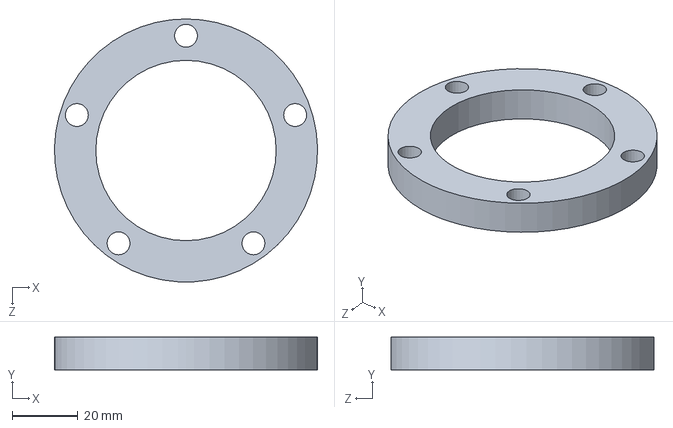
[picture p99: CAD file, 2024-05-14]
CAD/Launcher_CAD/Cycloidal Gear Box/Parts/Bearing Ring.SLDPRT
80.2 x 10.0 x 80.2 mm
