vvinhvvo98/Basketball-Launcher/CAD/Launcher_CAD/D4215 motor/D4215 Magnet ring.SLDPRT

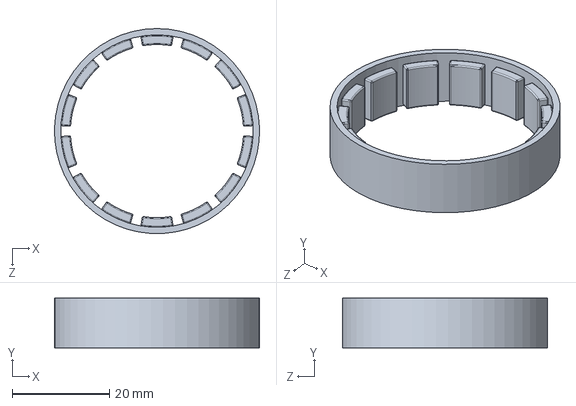
[picture p100: CAD file, 2024-05-14]
CAD/Launcher_CAD/D4215 motor/D4215 Magnet ring.SLDPRT
42.2 x 10.2 x 42.2 mm
