vvinhvvo98/Basketball-Launcher/CAD/Launcher_CAD/ROCKER SWITCH.SLDPRT

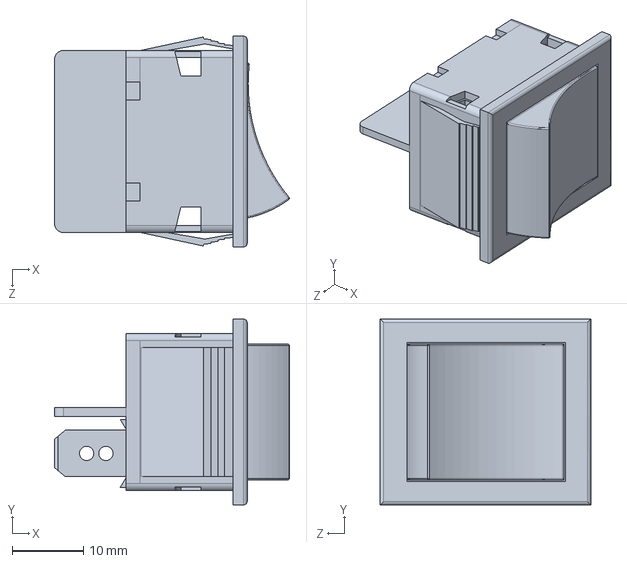
[picture p101: CAD file, 2024-05-20]
CAD/Launcher_CAD/ROCKER SWITCH.SLDPRT
32.9 x 26.0 x 29.5 mm
