vvinhvvo98/Basketball-Launcher/CAD/Launcher_CAD/Cycloidal Gear Box/Parts/Motor Bracket.SLDPRT

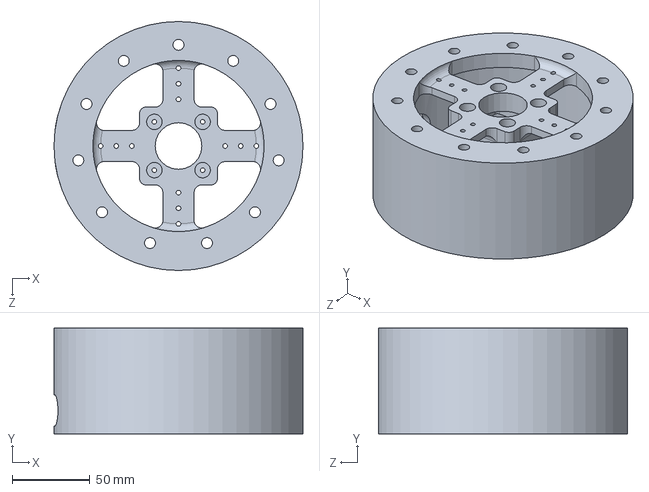
[picture p102: CAD file, 2024-05-14]
CAD/Launcher_CAD/Cycloidal Gear Box/Parts/Motor Bracket.SLDPRT
160.0 x 68.0 x 160.0 mm
