vvinhvvo98/Basketball-Launcher/CAD/Launcher_CAD/PCBA cap.SLDPRT

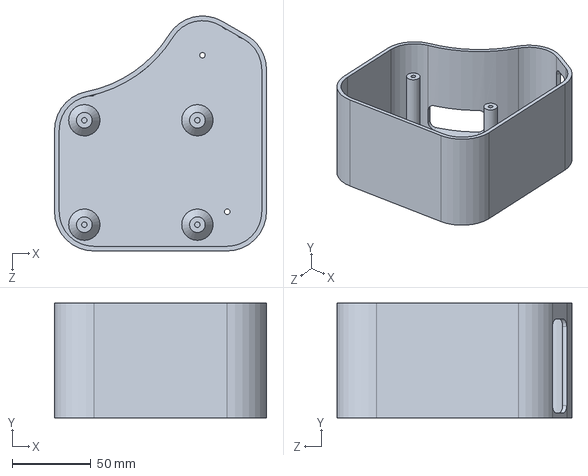
[picture p103: CAD file, 2024-05-20]
CAD/Launcher_CAD/PCBA cap.SLDPRT
135.0 x 73.0 x 149.6 mm
