vvinhvvo98/Basketball-Launcher/CAD/Launcher_CAD/HC-05.SLDPRT

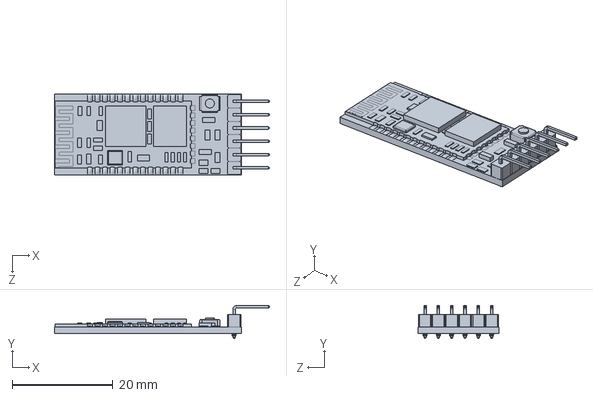
[picture p104: CAD file, 2024-05-20]
CAD/Launcher_CAD/HC-05.SLDPRT
42.6 x 6.55 x 16.0 mm
