vvinhvvo98/Basketball-Launcher/CAD/Launcher_CAD/wire frawe.SLDPRT

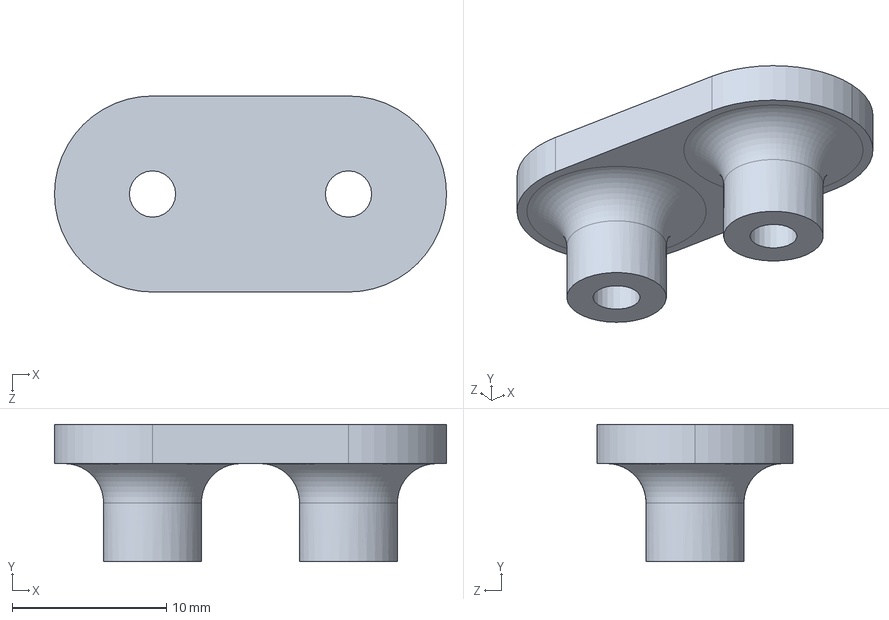
[picture p105: CAD file, 2024-05-20]
CAD/Launcher_CAD/wire frawe.SLDPRT
25.4 x 8.89 x 12.7 mm
