vvinhvvo98/Basketball-Launcher/CAD/Launcher_CAD/Wheel.SLDPRT

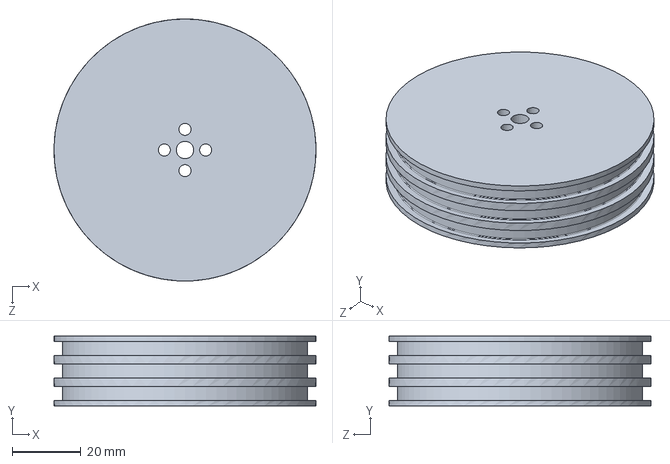
[picture p106: CAD file, 2024-05-14]
CAD/Launcher_CAD/Wheel.SLDPRT
76.2 x 20.3 x 76.2 mm
