vvinhvvo98/Basketball-Launcher/CAD/Launcher_CAD/Base.SLDPRT

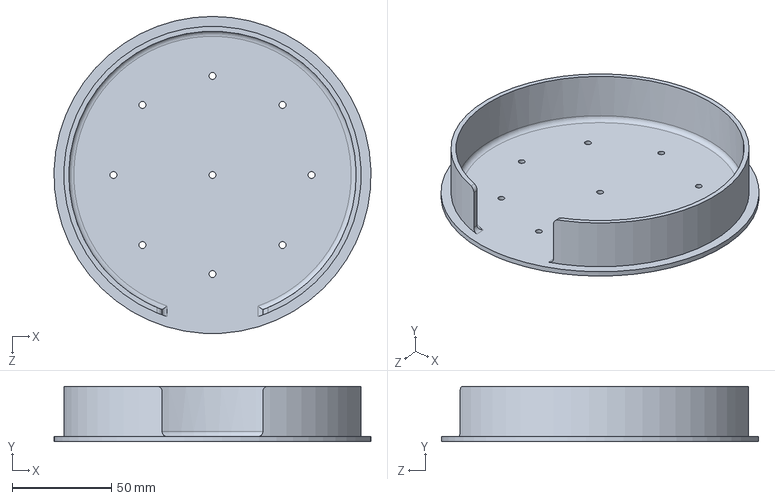
[picture p107: CAD file, 2024-05-14]
CAD/Launcher_CAD/Base.SLDPRT
159.9 x 27.9 x 160.0 mm
