vvinhvvo98/Basketball-Launcher/CAD/Launcher_CAD/nOSE.SLDPRT

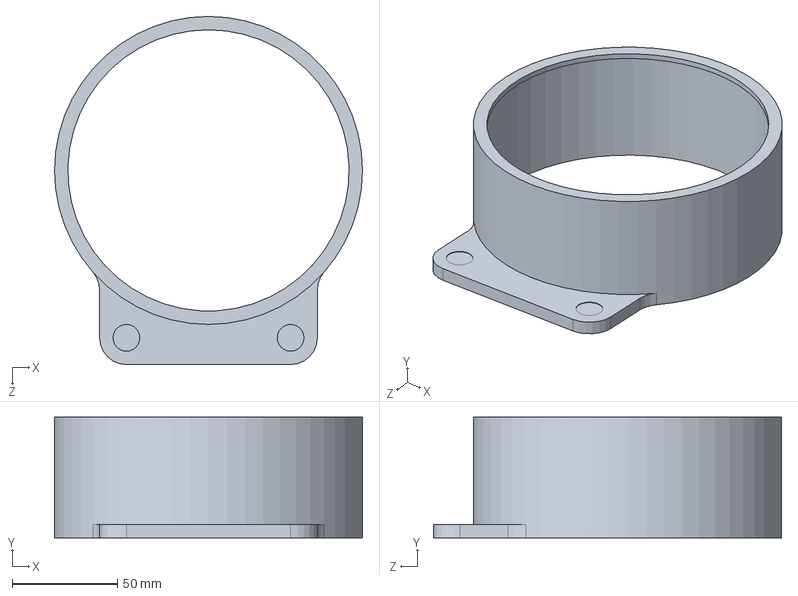
[picture p108: CAD file, 2024-05-14]
CAD/Launcher_CAD/nOSE.SLDPRT
146.1 x 57.1 x 165.1 mm
