vvinhvvo98/Basketball-Launcher/CAD/Launcher_CAD/Shaft.SLDPRT

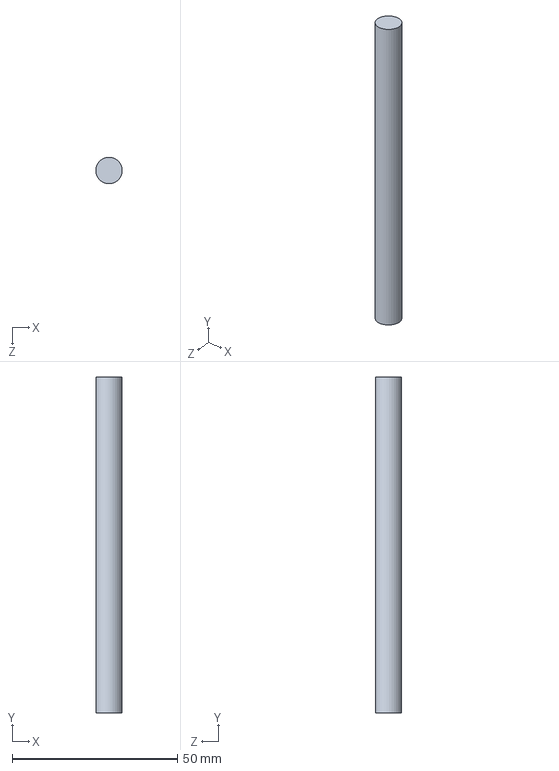
[picture p109: CAD file, 2024-05-14]
CAD/Launcher_CAD/Shaft.SLDPRT
7.99 x 101.6 x 8.00 mm
