vvinhvvo98/Basketball-Launcher/CAD/Launcher_CAD/Barrel.SLDPRT

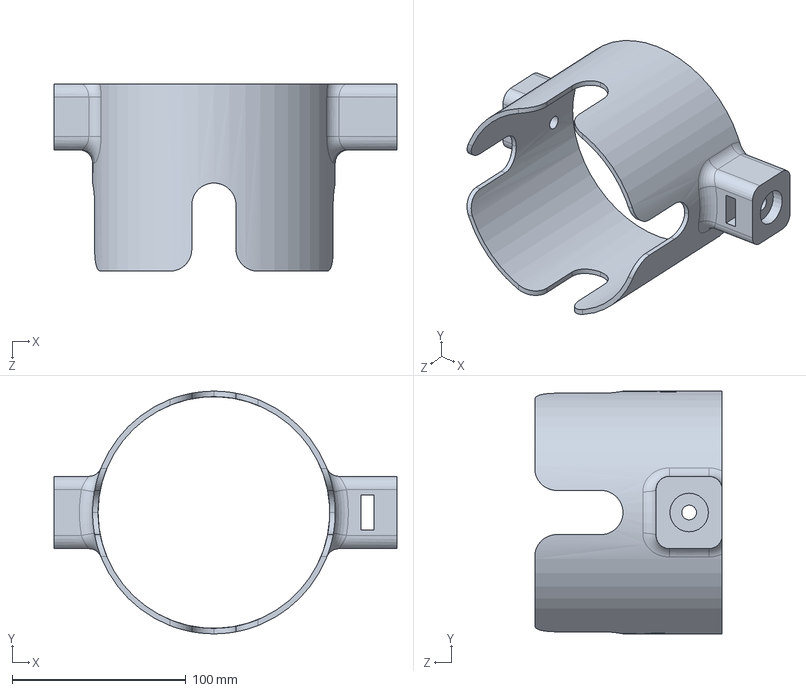
[picture p110: CAD file, 2024-05-14]
CAD/Launcher_CAD/Barrel.SLDPRT
197.5 x 139.7 x 107.9 mm
