vvinhvvo98/Basketball-Launcher/CAD/Launcher_CAD/NEMA GearBox.SLDPRT

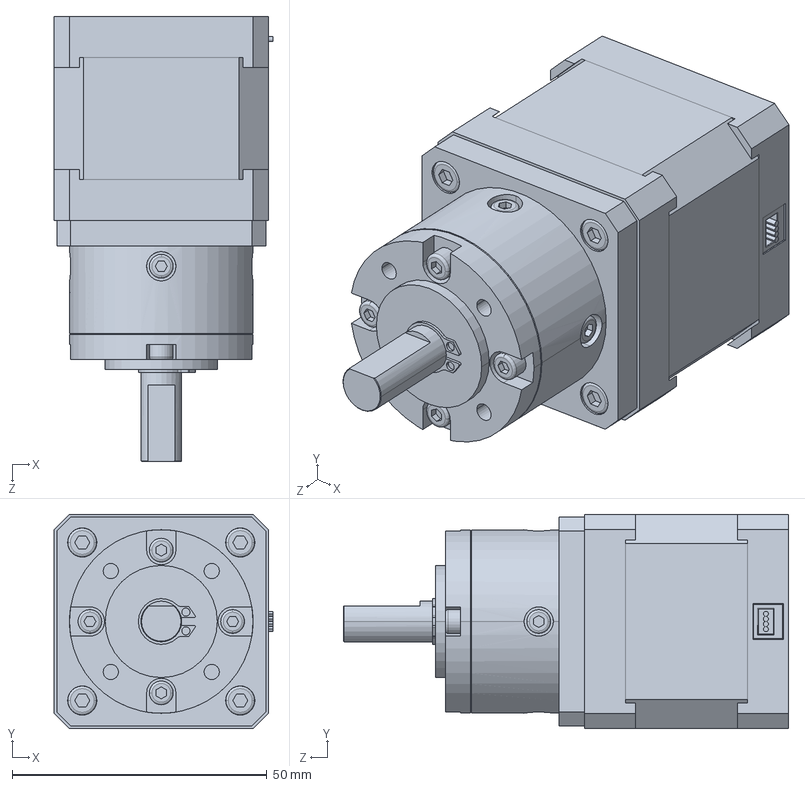
[picture p111: CAD file, 2024-05-14]
CAD/Launcher_CAD/NEMA GearBox.SLDPRT
42.9 x 42.0 x 87.3 mm
