vvinhvvo98/Basketball-Launcher/CAD/Launcher_CAD/Bracket.SLDPRT

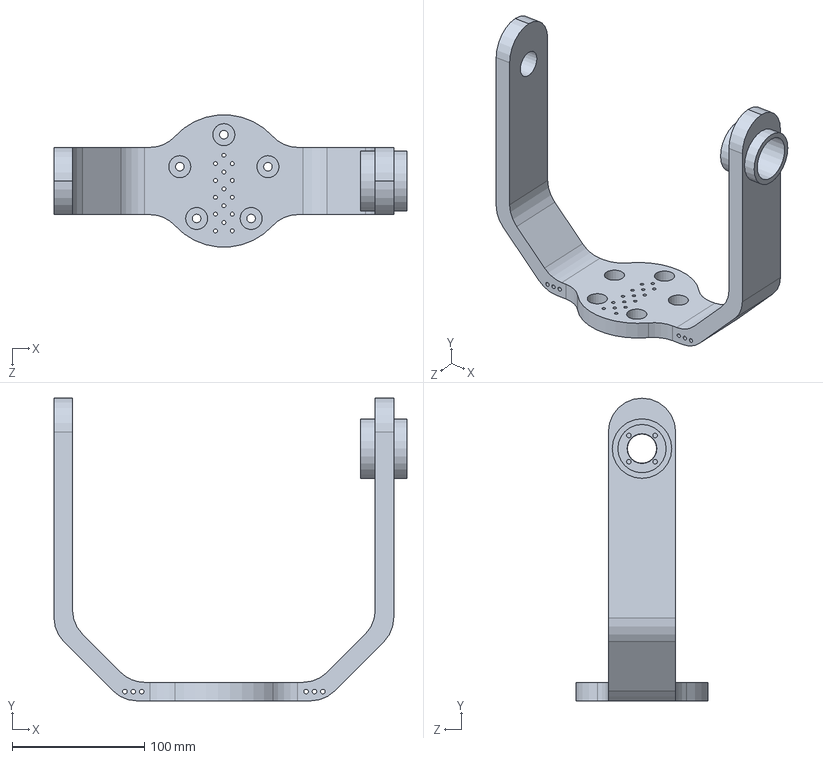
[picture p112: CAD file, 2024-05-14]
CAD/Launcher_CAD/Bracket.SLDPRT
266.6 x 228.6 x 99.6 mm
