vvinhvvo98/Basketball-Launcher/(list of files, cad)

Other CAD files:
CAD/Launcher_CAD/Cycloidal Gear Box/Parts/Cycloidal Disk 1.SLDPRT
CAD/Launcher_CAD/5972K91_Ball Bearing.SLDPRT
CAD/Launcher_CAD/6056N16_Carbon Steel Set Screw Collar.SLDPRT
CAD/Launcher_CAD/Cycloidal Gear Box/Parts/4668K121_Permanently Lubricated Stainless Steel Ball Bearing.SLDPRT
CAD/Launcher_CAD/Cycloidal Gear Box/Parts/5972K248_Ball Bearing.SLDPRT
CAD/Launcher_CAD/Cycloidal Gear Box/Parts/6656K245_Ultra-Thin Ball Bearing.SLDPRT
CAD/Launcher_CAD/Cycloidal Gear Box/Parts/90592A016_Steel Hex Nut.SLDPRT
CAD/Launcher_CAD/Cycloidal Gear Box/Parts/97050A134_Alloy Steel Low-Profile Socket Head Screw.SLDPRT
CAD/Launcher_CAD/Cycloidal Gear Box/Parts/ASSY/Bolts.SLDASM
CAD/Launcher_CAD/D4215 motor/91390A094_ALLOY STEEL CUP POINT SET SCREW.SLDPRT
CAD/Launcher_CAD/D4215 motor/98541A112_BLACK-FINISH STEEL EXTERNAL RETAINING RING.SLDPRT
CAD/Launcher_CAD/D4215 motor/Brass washer.SLDPRT
CAD/Launcher_CAD/PCBA Box.STL
CAD/Launcher_CAD/mg90s-horn.stl
