vvinhvvo98/Basketball-Launcher/docs/OverallDesign.pdf

# LAUNCHER

E

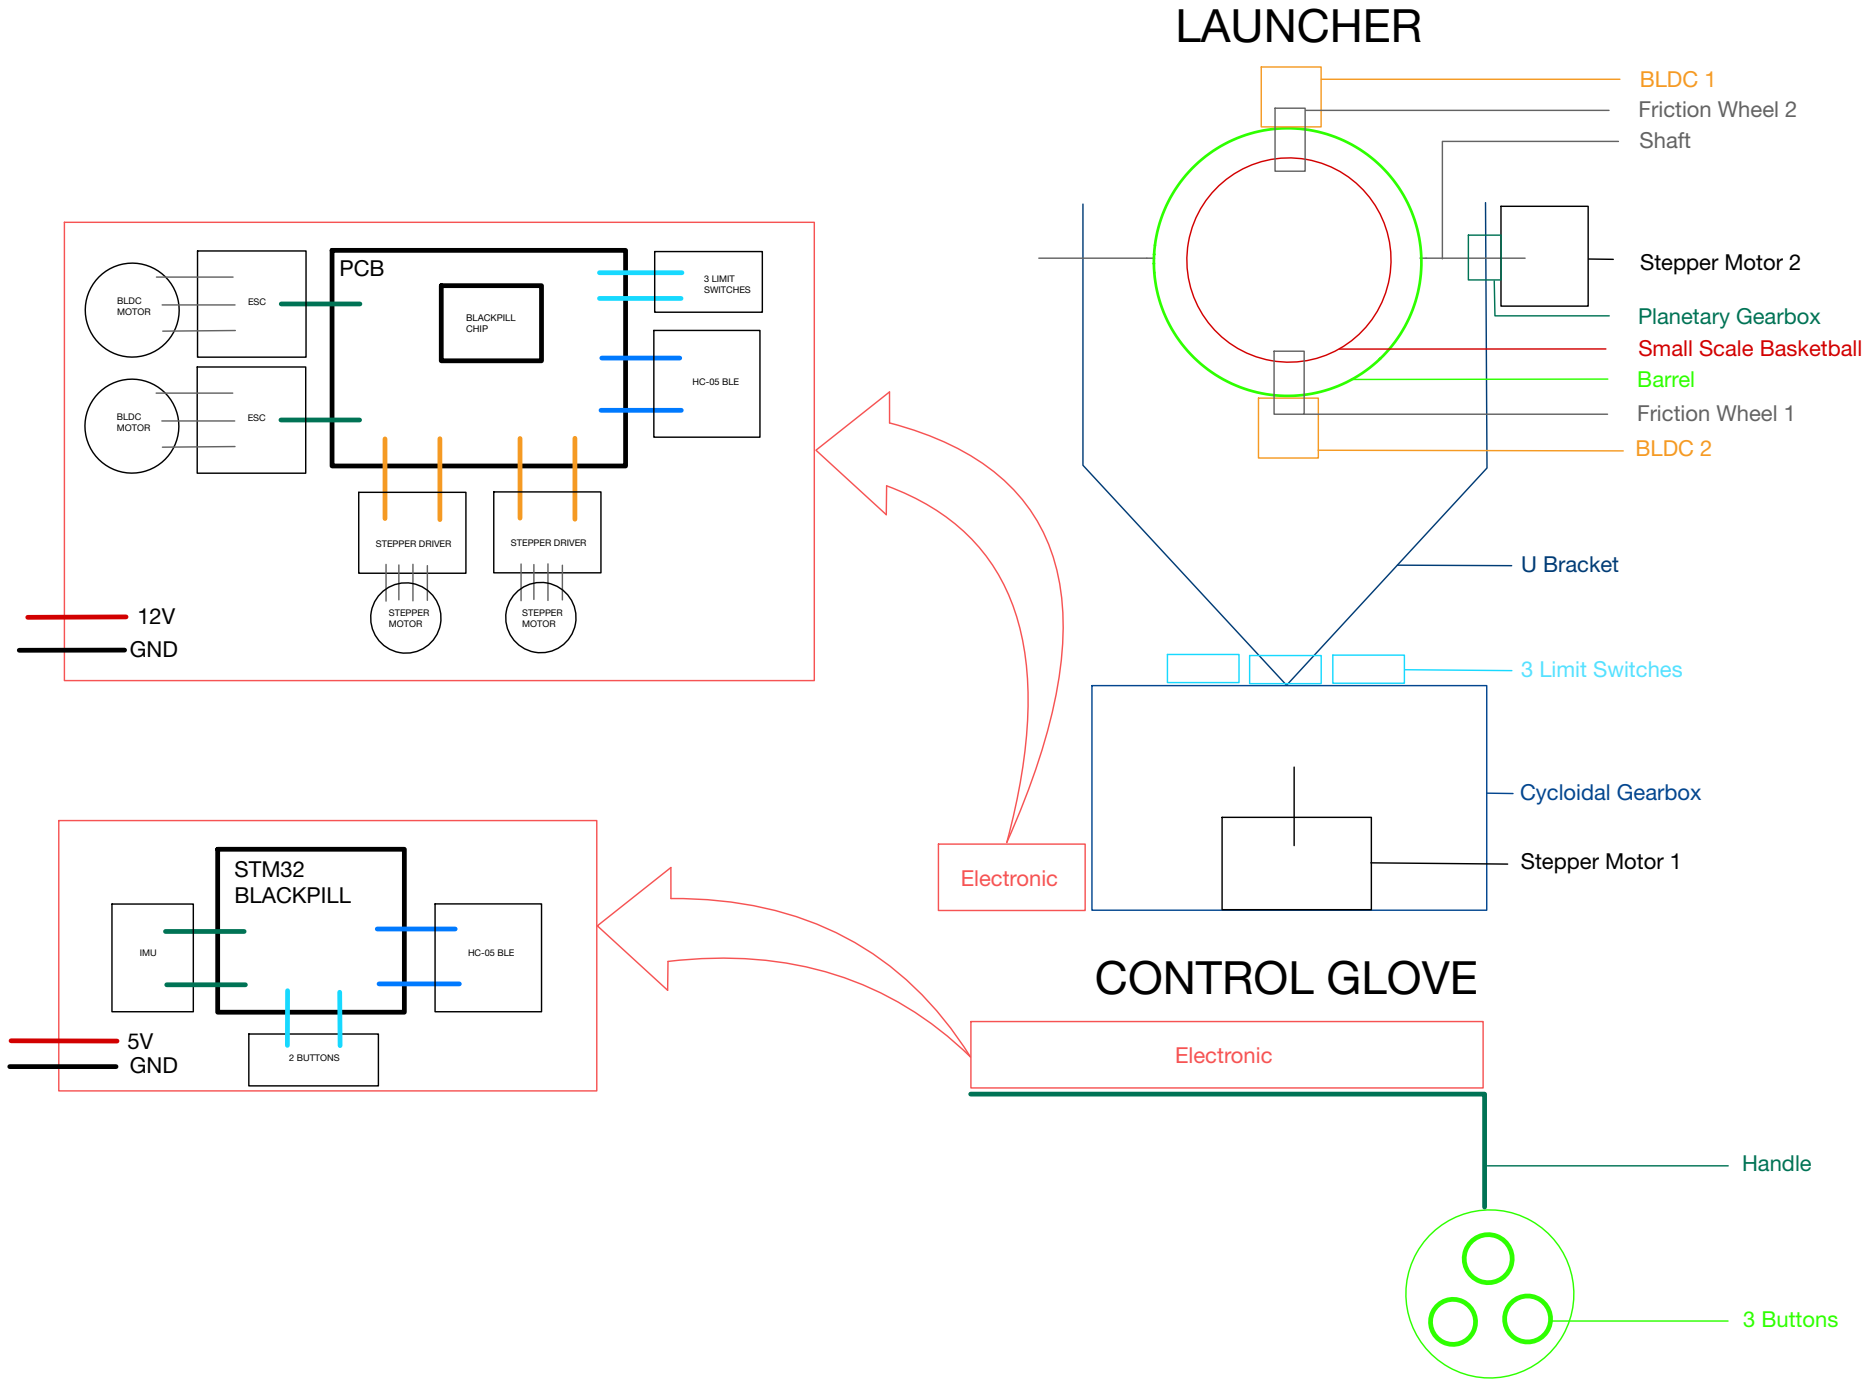
[picture p143: page 1]
PCB; HC-05 BLE; STEPPER DRIVER; STEPPER MOTOR; BLDC MOTOR; ESC; STM32 BLACKPILL; IMU; CONTROL GLOVE; 3 LIMIT SWITCHES; 2 BUTTONS; BLACKPILL CHIP; 12V GND; 5V GND; Cycloidal Gearbox; Stepper Motor 1; 3 Limit Switches; U Bracket; Stepper Motor 2; BLDC 1; Shaft; Friction Wheel 2; Electronic; Handle; 3 Buttons

Planetary Gearbox
Small Scale Basketball
Barrel
Friction Wheel 1
BLDC 2
