vvinhvvo98/Basketball-Launcher/PCBA/PCBA/PCBA_MAIN_VV.pdf

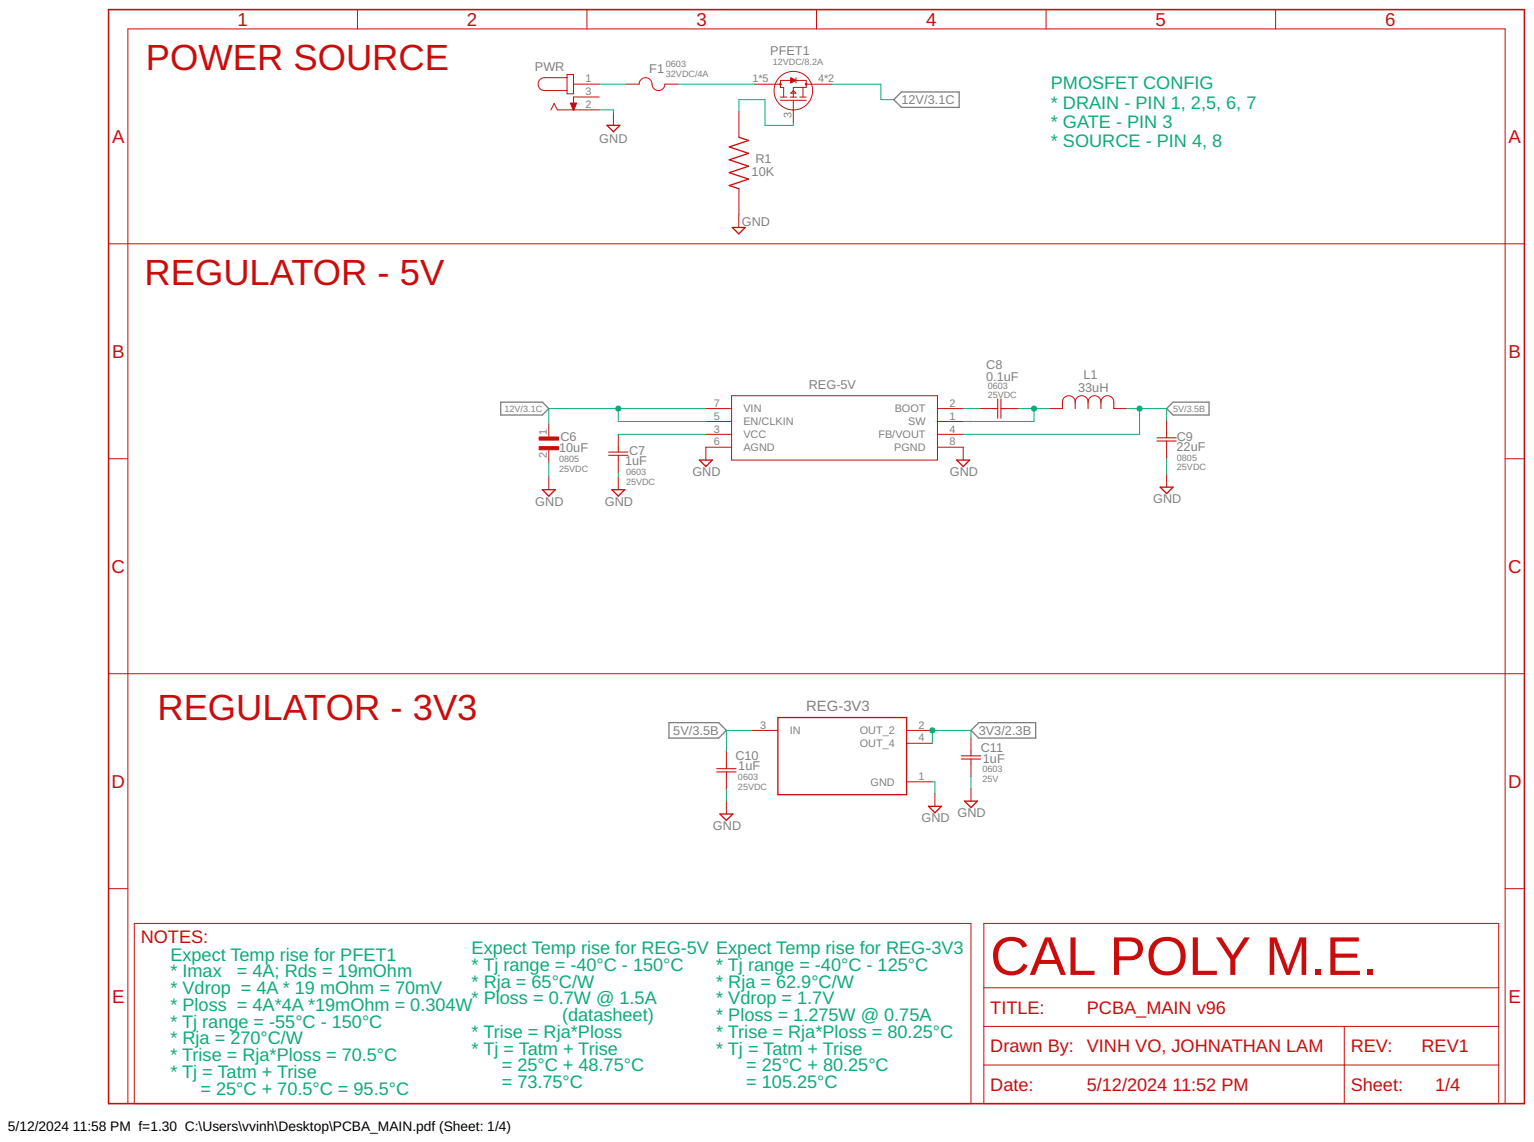
[picture p144: page 1]

D | REGULATOR - 3V3 REG-3V3 | D

NOTES:
Expect Temp rise for PFET1
* Imax = 4A; Rds = 19mOhm
* Vdrop = 4A * 19 mOhm = 70mV
* Ploss = 4A*4A *19mOhm = 0.304W
* Tj range = -55°C - 150°C
* Rja = 270°C/W
* Trise = Rja*Ploss = 70.5°C
* Tj = Tatm + Trise = 25°C + 70.5°C = 95.5°C

Expect Temp rise for REG-5V
* Tj range = -40°C - 150°C
* Rja = 65°C/W
* Ploss = 0.7W @ 1.5A

Expect Temp rise for REG-3V3
* Tj range = -40°C - 125°C
* Rja = 62.9°C/W
* Vdrop = 1.7V
* Ploss = 1.275W @ 0.75A
* Trise = Rja*Ploss = 80.25°C
* Tj = Tatm + Trise = 25°C + 80.25°C

Drawn By: VINH VO, JOHNATHAN LAM | REV: REV1

Date: 5/12/2024 11:52 PM | Sheet:

5/12/2024 11:58 PM f=1.30 C:\Users\vvinh\Desktop\PCBA_MAIN.pdf (Sheet: 1/4)

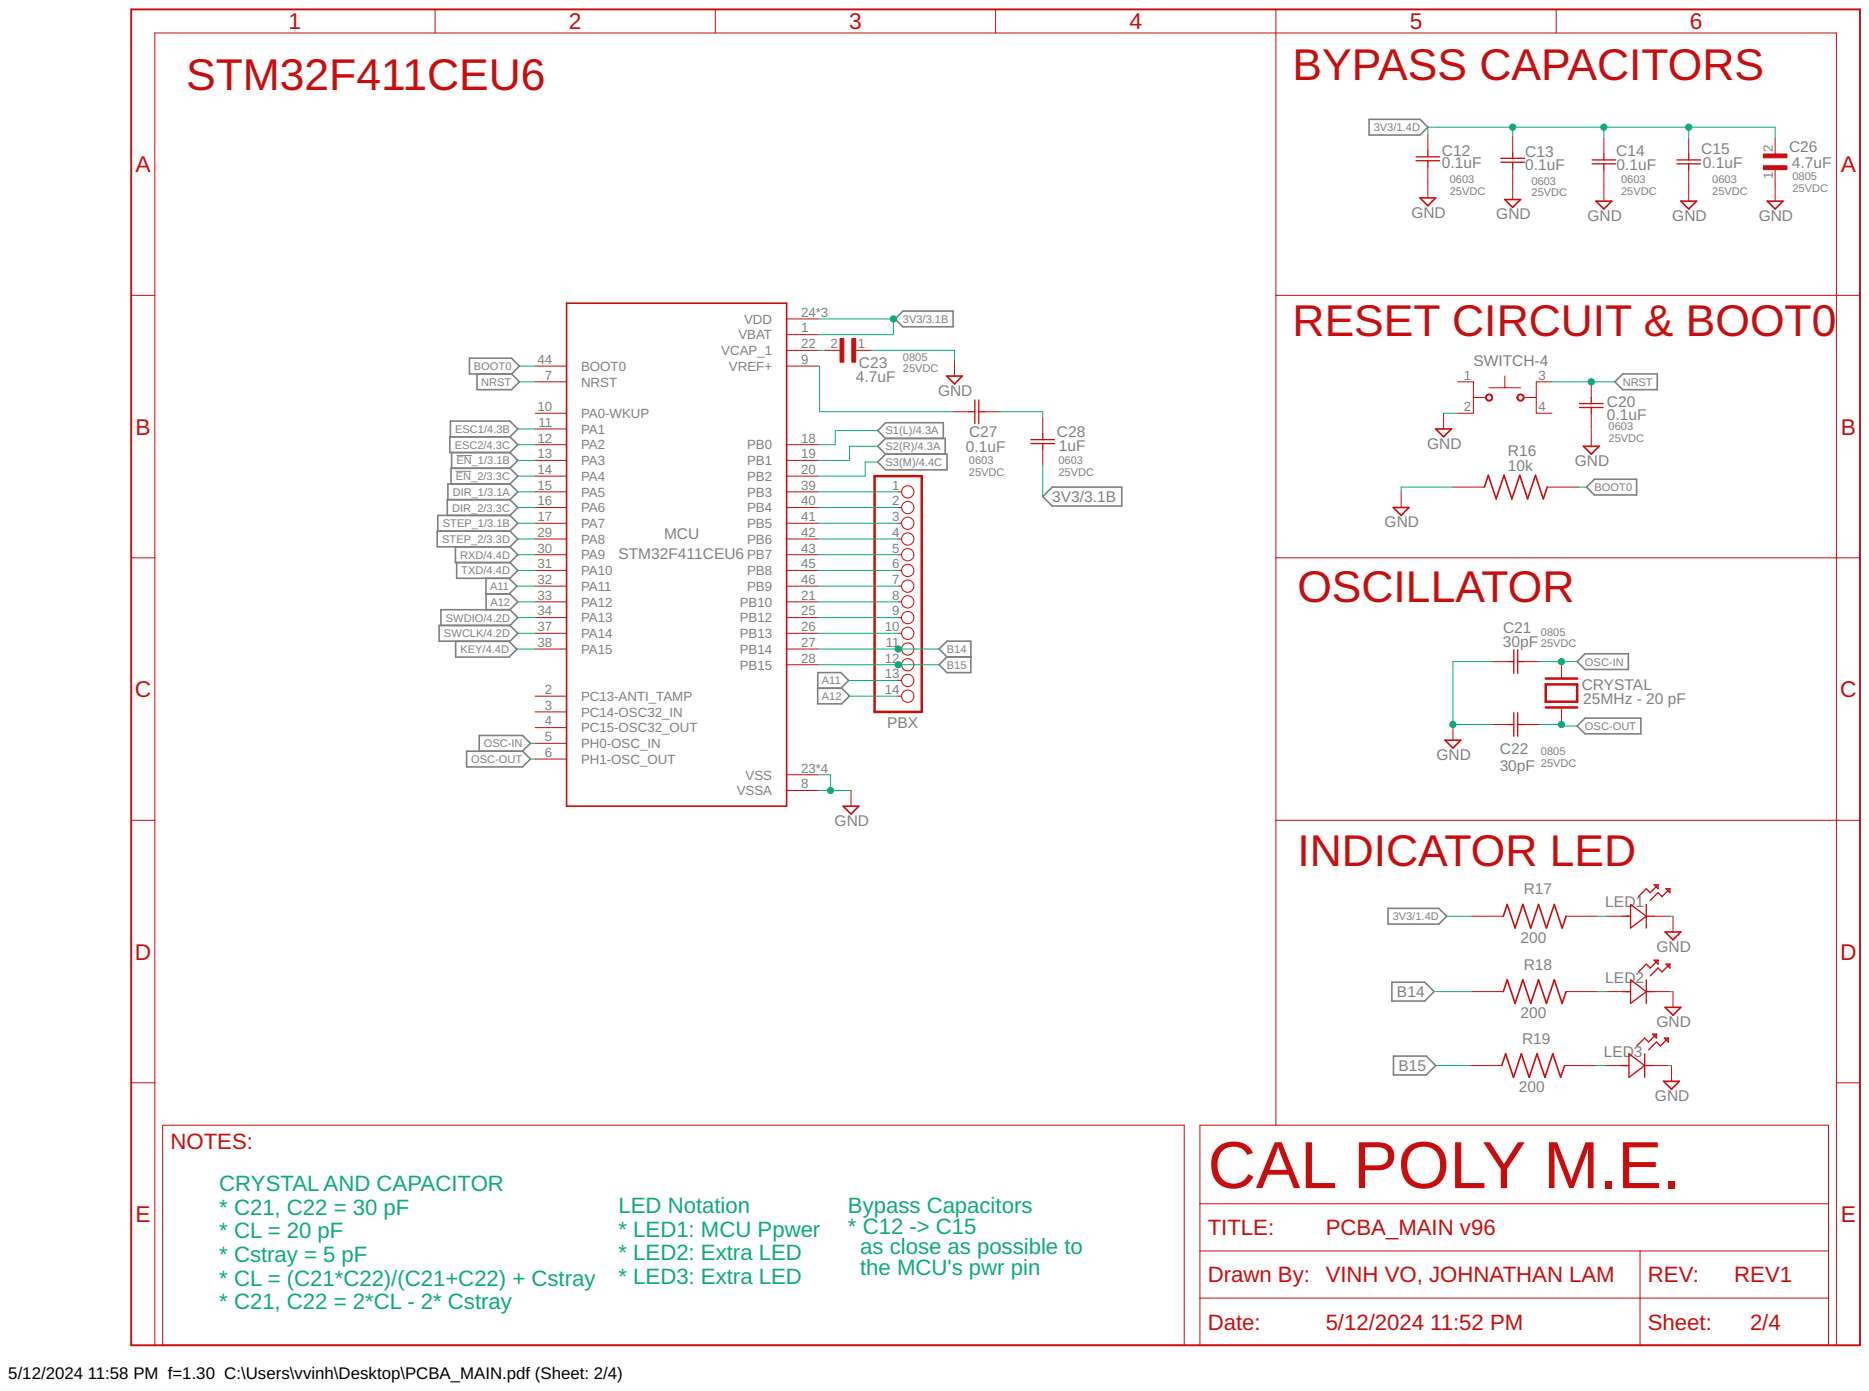
[picture p145: page 2]

28 | 12
23*4 | 13

Bypass Capacitors
as close as possible to
the MCU's pwr pin

5/12/2024 11:58 PM f=1.30 C:\Users\vvinh\Desktop\PCBA_MAIN.pdf (Sheet: 2/4)

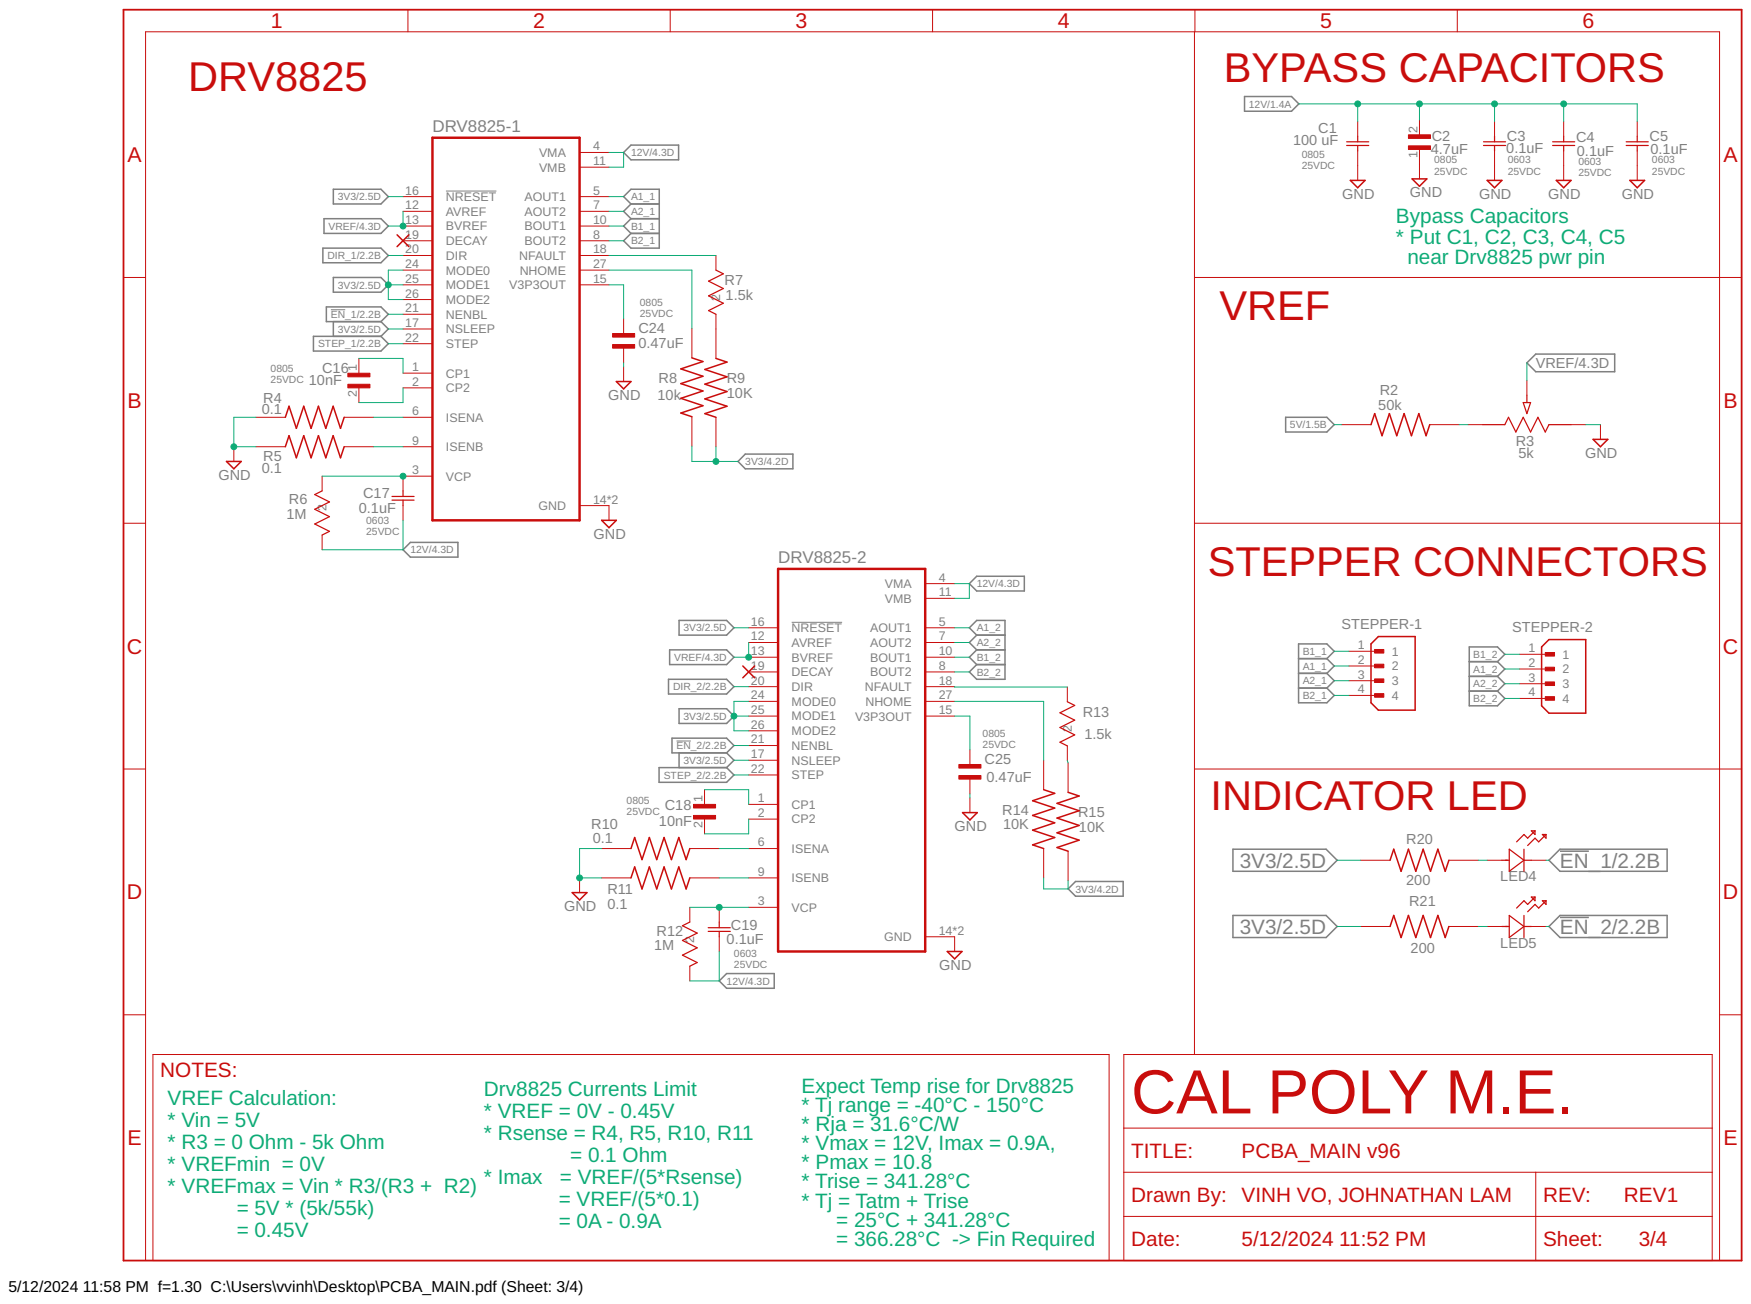
[picture p146: page 3]

25 | 15
26 | 14*2

Expect Temp rise for Drv8825
* Tj range = -40°C - 150°C
* Rja = 31.6°C/W
* Vmax = 12V, Imax = 0.9A, * Pmax = 10.8

* Imax = VREF/(5*Rsense) = VREF/(5*0.1) = 0A - 0.9A

5/12/2024 11:58 PM f=1.30 C:\Users\vvinh\Desktop\PCBA_MAIN.pdf (Sheet: 3/4)

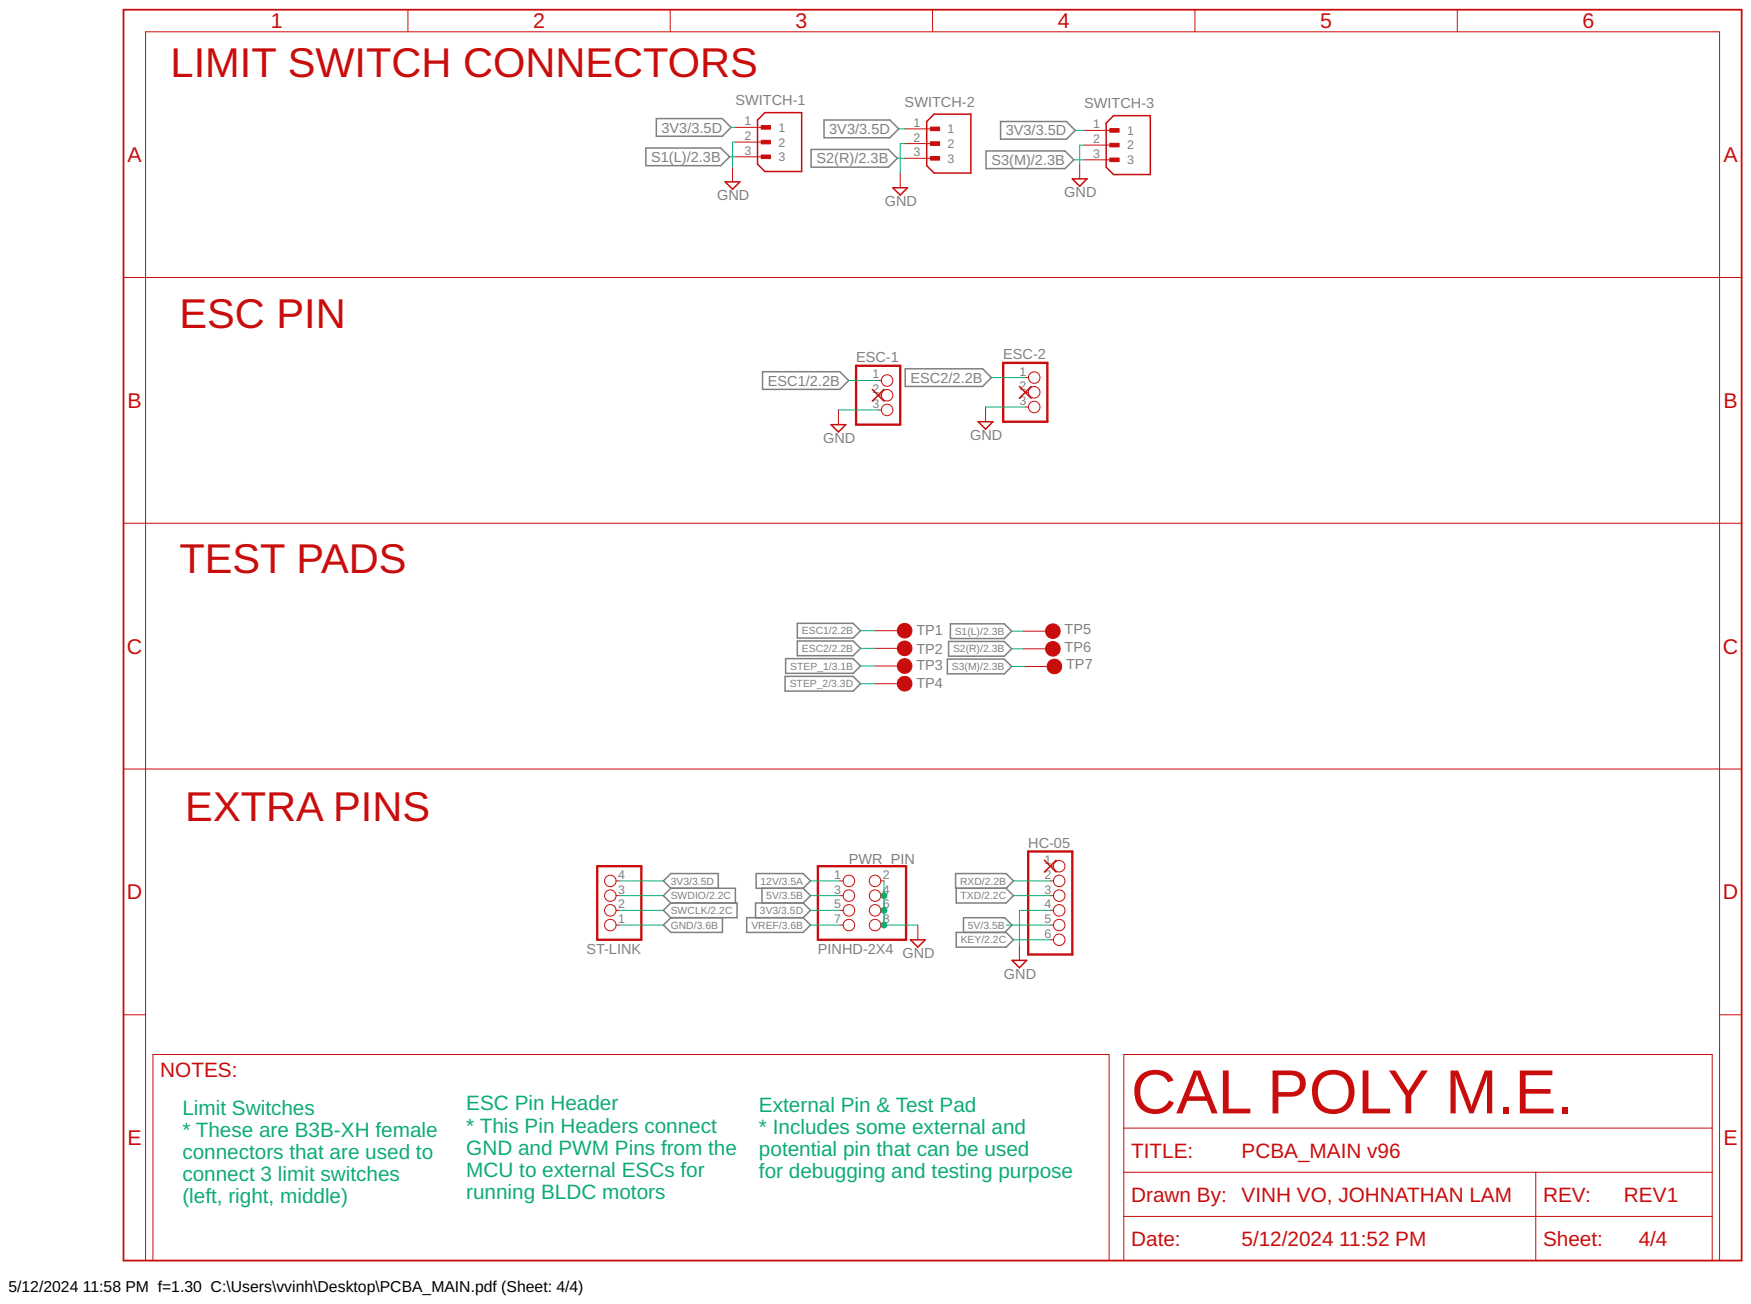
[picture p147: page 4]

C | TEST PADS | C

D | EXTRA PINS HC-05 | D

ESC Pin Header
* This Pin Headers connect
GND and PWM Pins from the
MCU to external ESCs for
running BLDC motors

External Pin & Test Pad
* Includes some external and
potential pin that can be used
for debugging and testing purpose

* These are B3B-XH female

connectors that are used to
connect 3 limit switches
(left, right, middle)

5/12/2024 11:58 PM f=1.30 C:\Users\vvinh\Desktop\PCBA_MAIN.pdf (Sheet: 4/4)
