vvinhvvo98/Basketball-Launcher/docs/ControllerSchematic.pdf

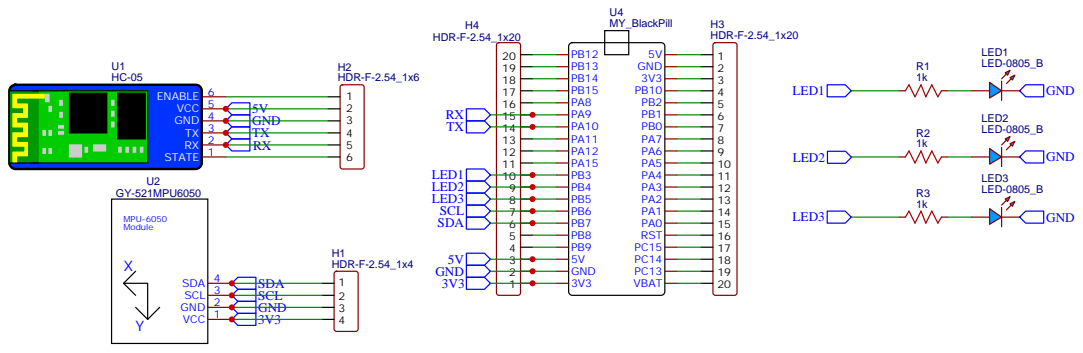
[picture p148: page 1]
