vvinhvvo98/Basketball-Launcher/docs/LauncherSchematic.pdf

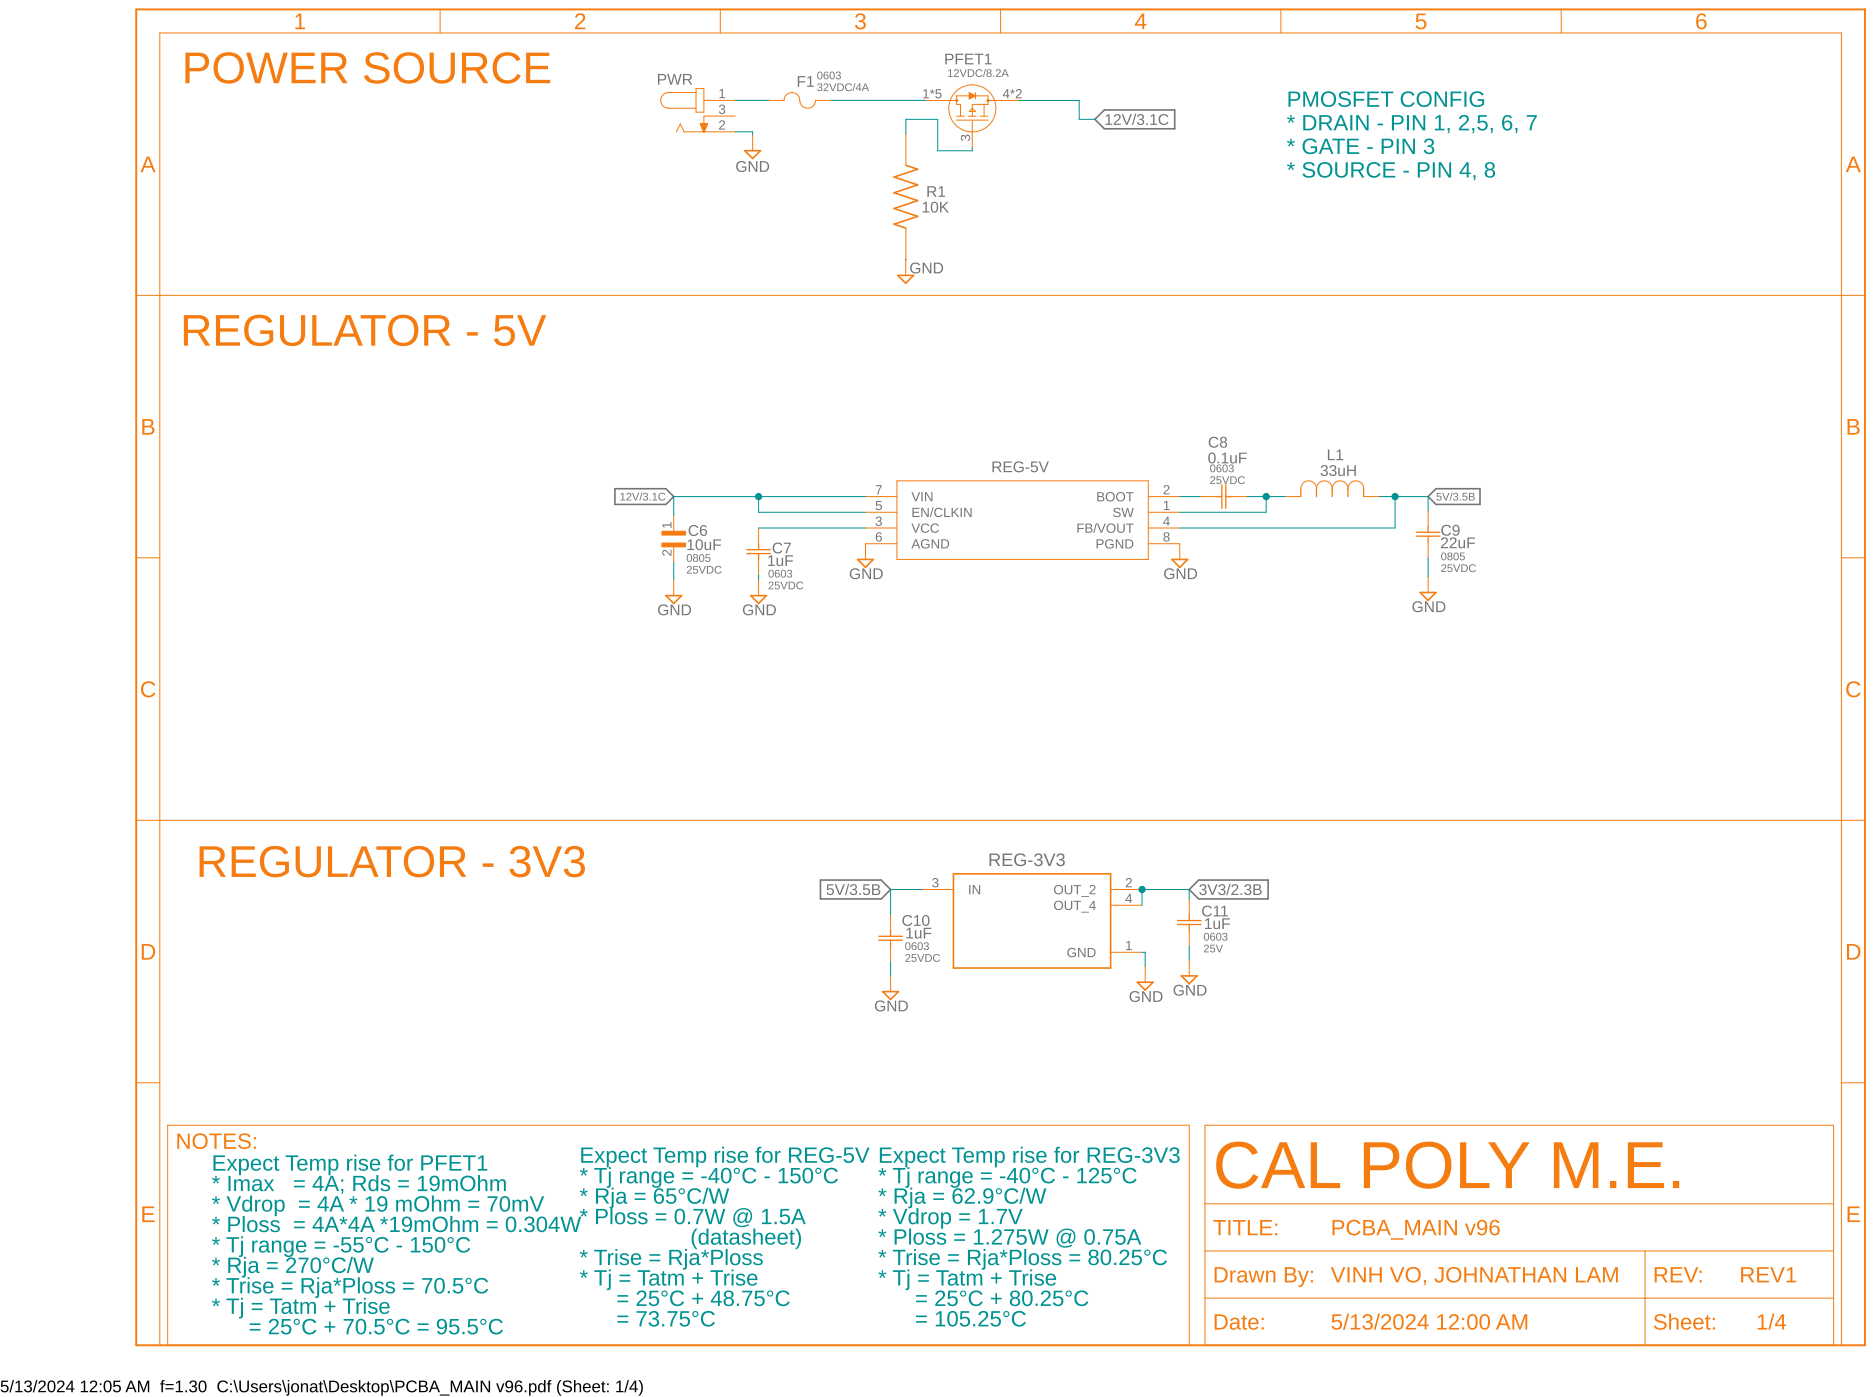
[picture p149: page 1]

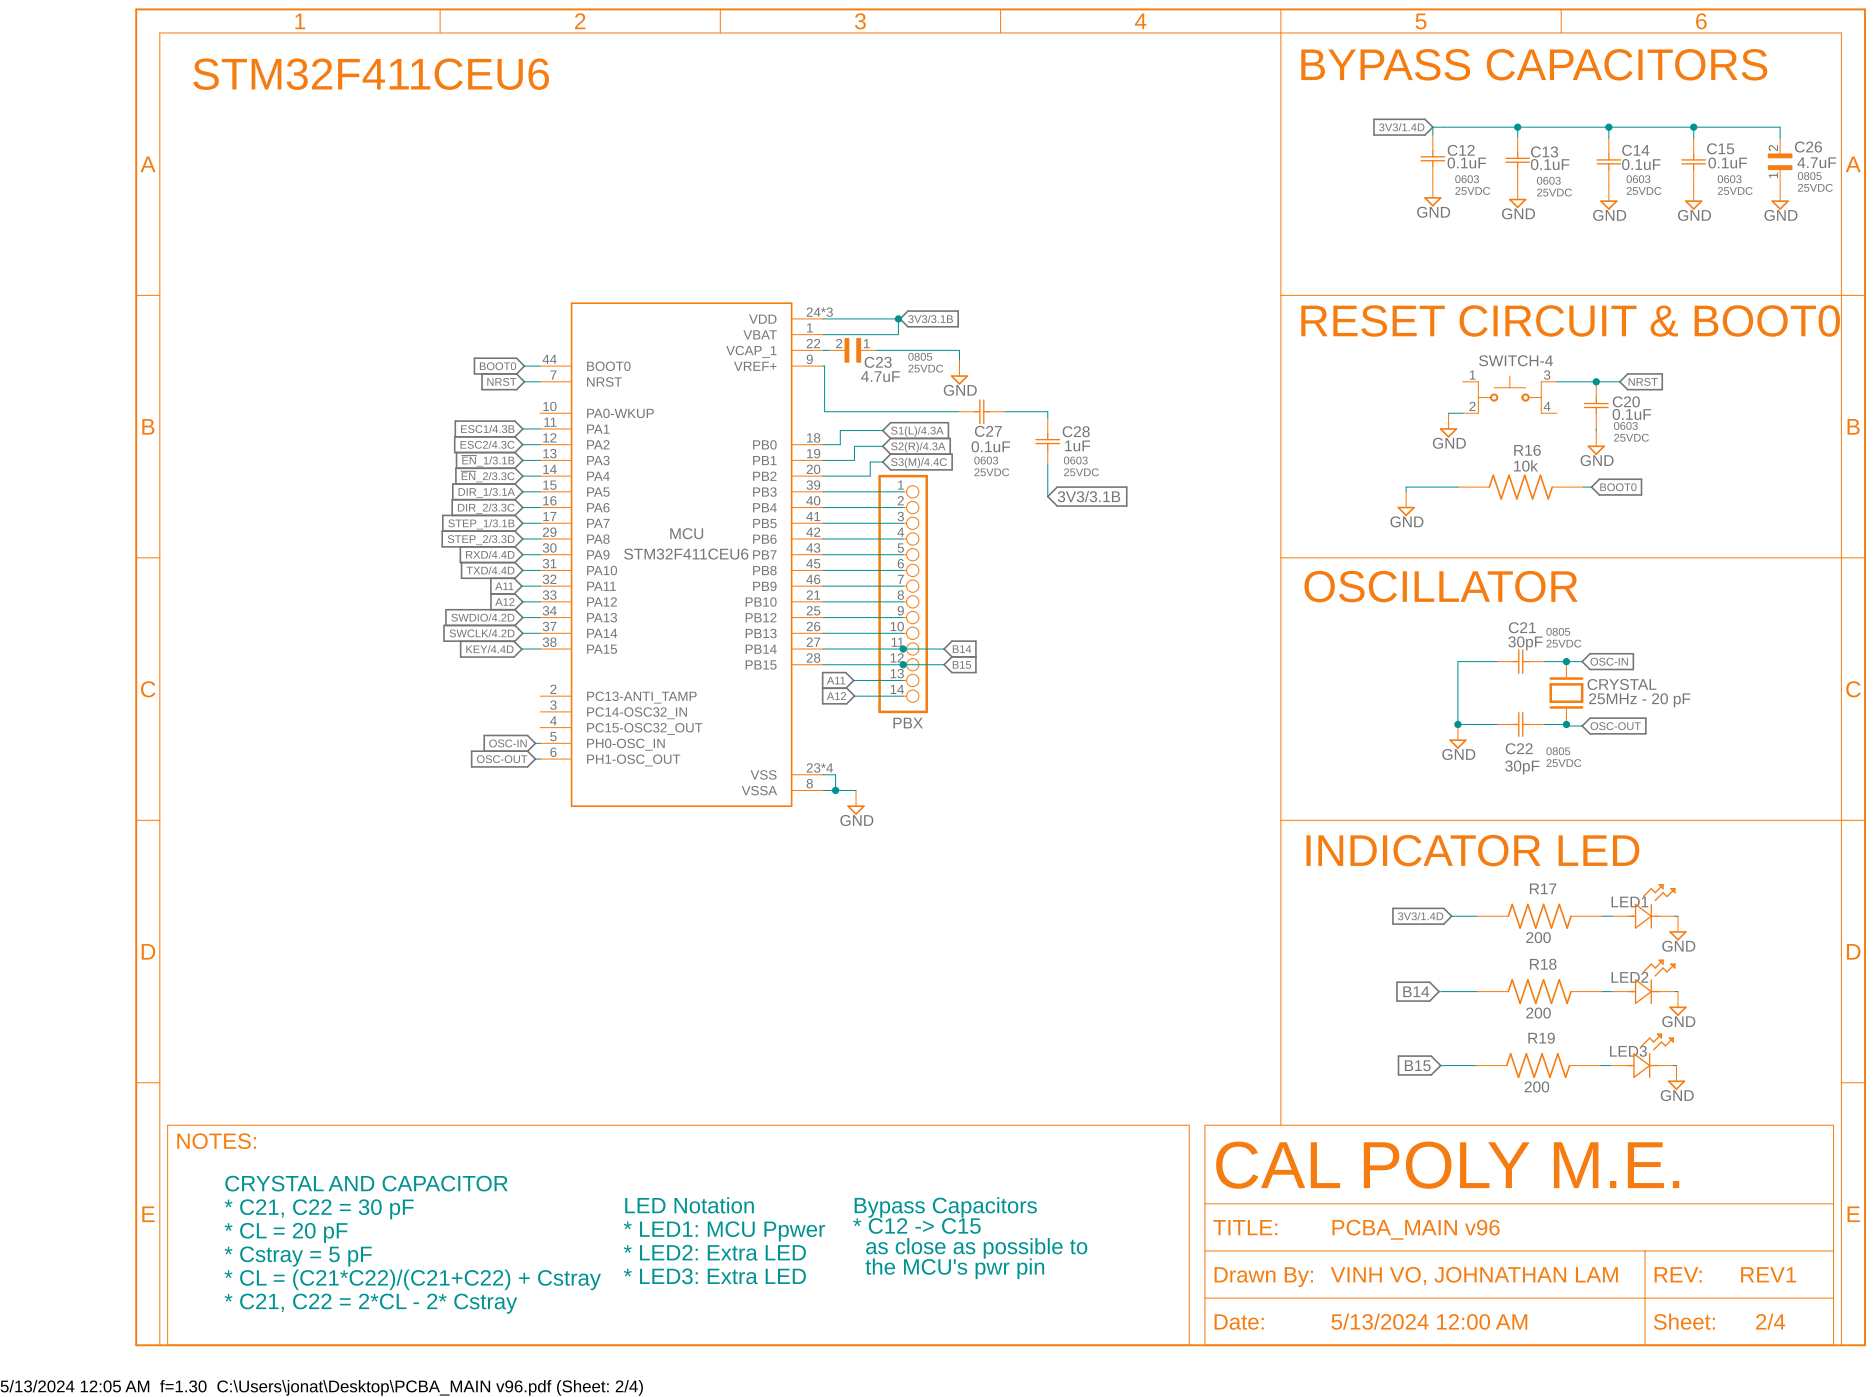
[picture p150: page 2]

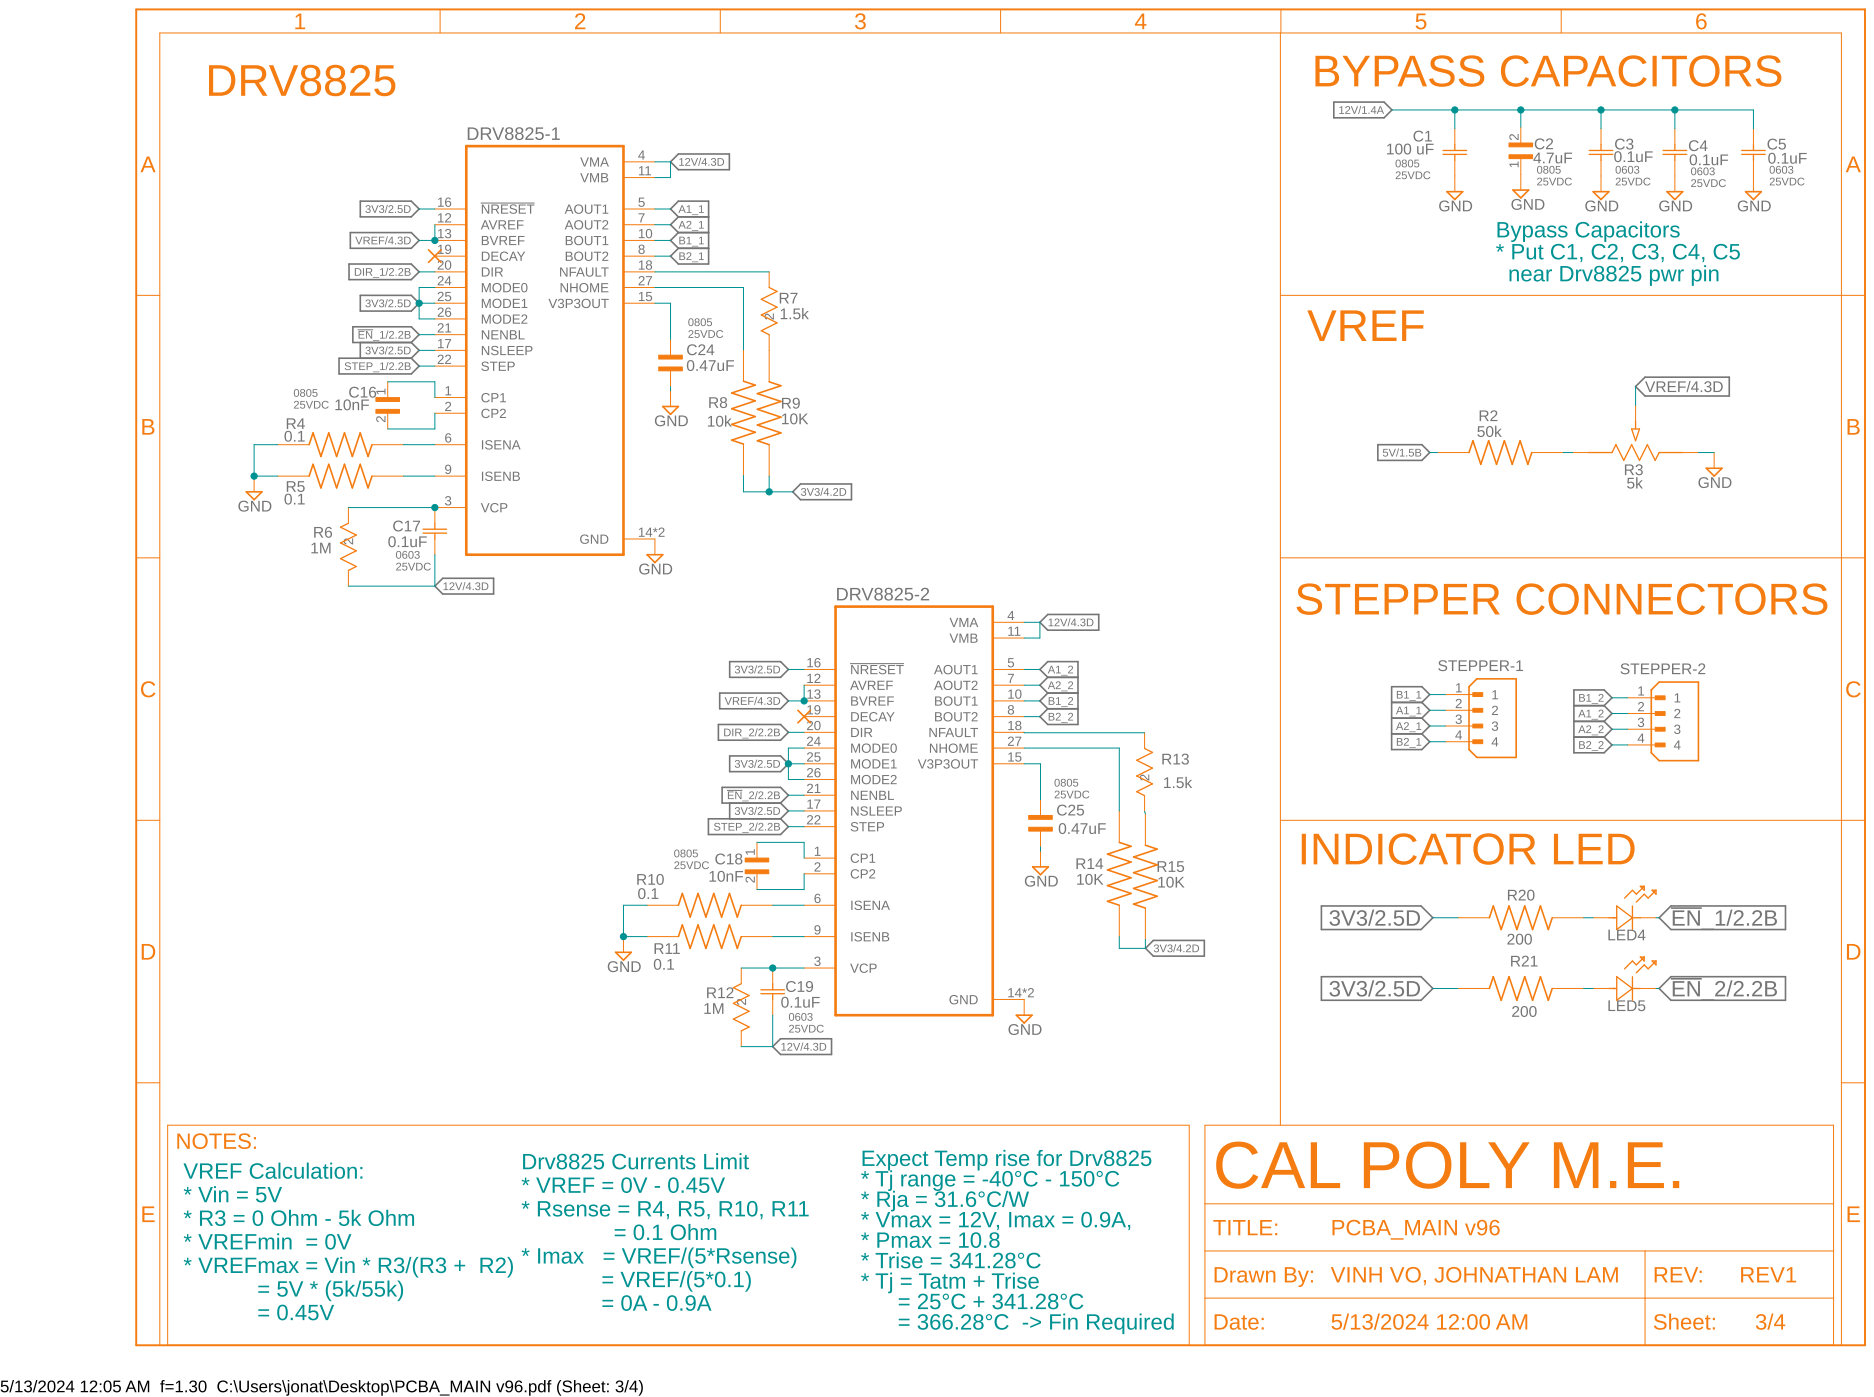
[picture p151: page 3]

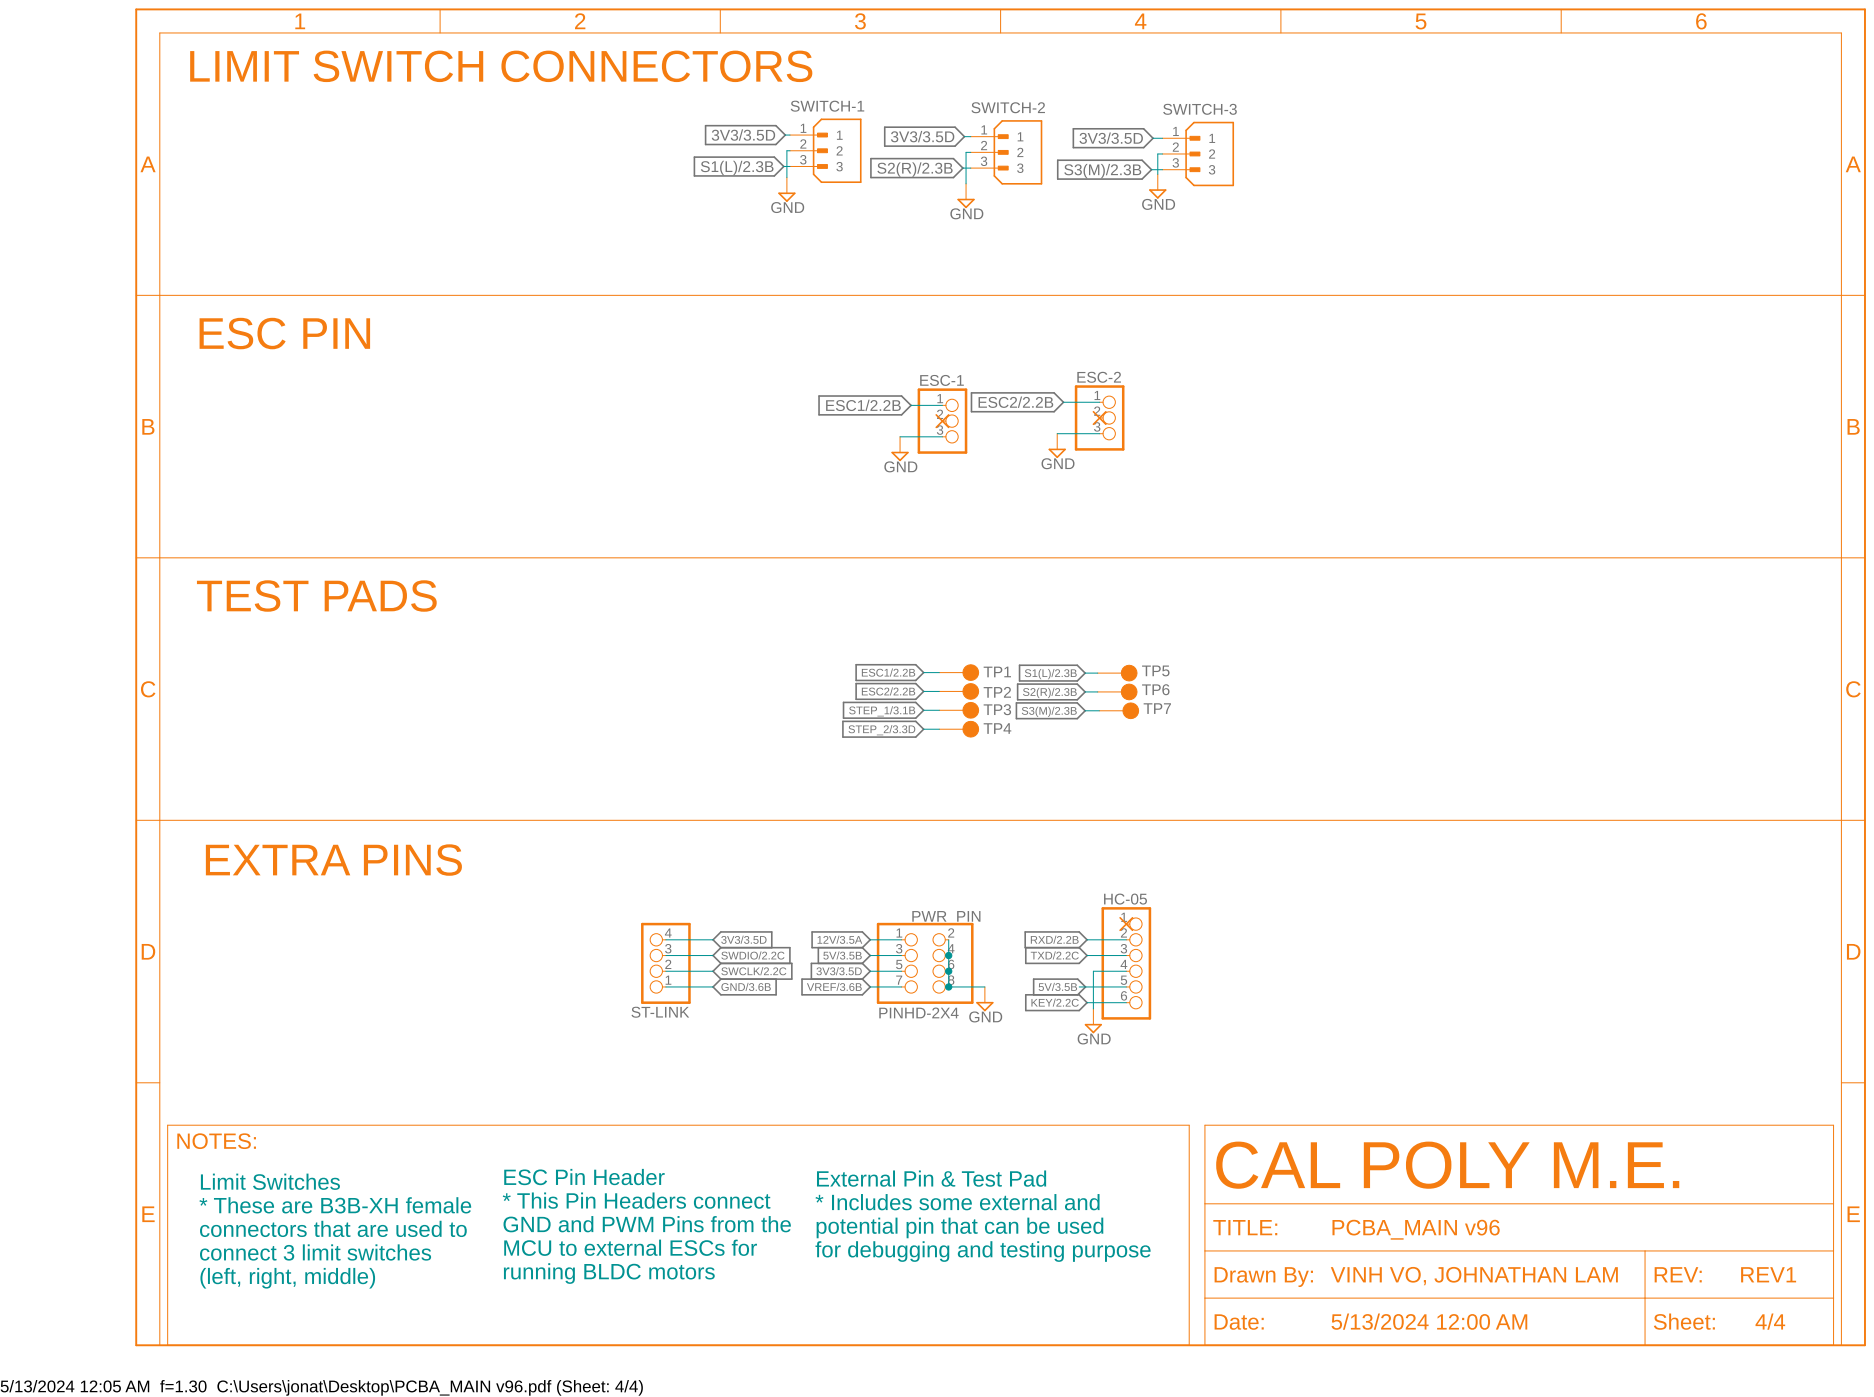
[picture p152: page 4]
