vvinhvvo98/Basketball-Launcher/PCBA/PCBA/PCBA_MAIN FOOTPRINT.pdf

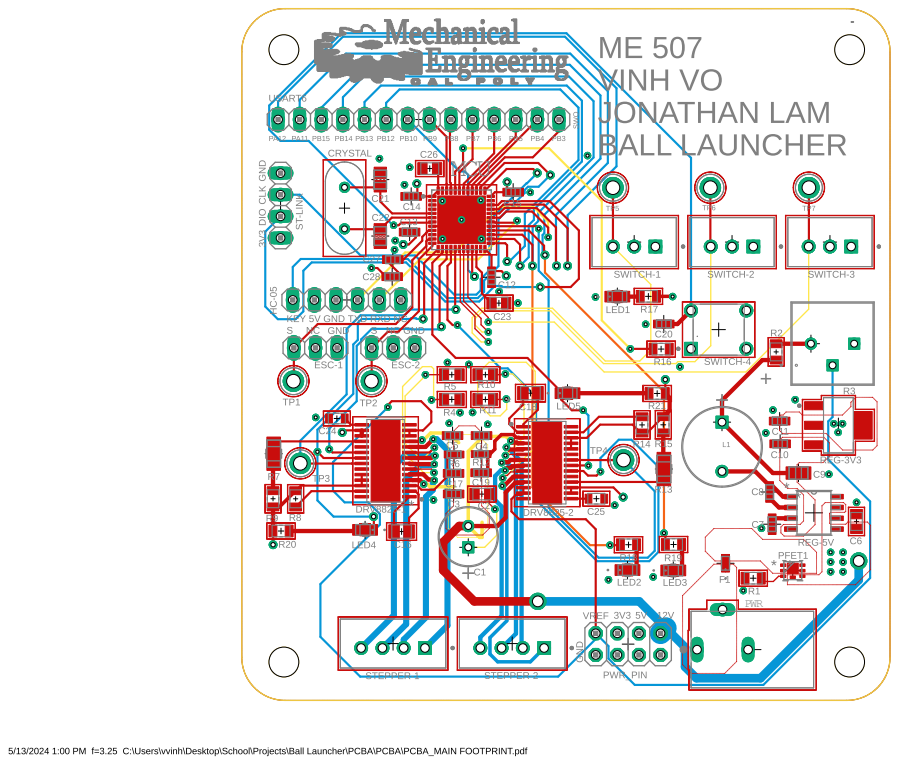
[picture p153: page 1]
