vvinhvvo98/Basketball-Launcher/Ball_Launcher_Main/Core/Src/main.c

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
/* Includes ------------------------------------------------------------------*/
#include "main.h"

/* USER CODE BEGIN Includes */
#include <stdio.h>
#include <stdint.h>
#include <string.h>
#include "stm32f4xx_hal.h"
#include "stepper_driver.h"
#include "switch.h"
#include "d4215.h"
#include "led.h"
/* USER CODE END Includes */

TIM_HandleTypeDef htim2;
TIM_HandleTypeDef htim3;
TIM_HandleTypeDef htim4;

UART_HandleTypeDef huart1;
UART_HandleTypeDef huart6;

/* USER CODE BEGIN PV */
// Initiate data buffer
char charIn;
char data[20];

// Initiate reset timer parameter
uint32_t ti = 0;
uint32_t tf = 0;
uint32_t dt = 0;

// Initiate yaw + pitch angle + target angle for steppers
uint16_t yaw = 0;
uint16_t pitch = 0;
uint16_t angleTarget = 0;

// Initiate rise fall and total for radio driver
uint16_t rise = 0;
uint16_t fall = 0;
uint16_t total = 0;

// Initiate yaw and pitch direction from controller and direction from the switch
uint8_t yawDirection   = 0;
uint8_t pitchDirection = 0;
uint8_t yawDirectionSW   = 0;
uint8_t pitchDirectionSW = 0;

// Initiate flags
uint8_t idx   = 0;
uint8_t MOVE  = 0;
uint8_t SHOT  = 0;
uint8_t ESTOP = 0;
uint8_t CAL   = 0;
uint8_t HOME  = 0;
uint8_t DROP  = 0;
uint8_t SW1   = 0;
uint8_t SW2   = 0;
uint8_t SW3   = 0;
uint8_t SW    = 0;

// Initiate STATE & STATE NUMBER
uint8_t STATE 		    = 0;
uint8_t STATE_0_INIT    = 0;
uint8_t STATE_1_HUB     = 1;
uint8_t STATE_2_ESTOP   = 2;
uint8_t STATE_3_STEPPER = 3;
uint8_t STATE_4_BLDC    = 4;


/* USER CODE END PV */

void SystemClock_Config(void);
static void MX_GPIO_Init(void);
static void MX_USART1_UART_Init(void);
static void MX_USART6_UART_Init(void);
static void MX_TIM2_Init(void);
static void MX_TIM4_Init(void);
static void MX_TIM3_Init(void);
/* USER CODE BEGIN PFP */
void HAL_UART_RxCpltCallback(UART_HandleTypeDef *huart);
void dataProcess(char* data);
uint16_t speedCalculate(uint16_t first, uint16_t second, uint16_t third);
uint16_t map(uint16_t x, uint16_t in_min, uint16_t in_max, uint16_t out_min, uint16_t out_max);
/* USER CODE END PFP */

/**
  * @brief  The application entry point.
  * @retval int
  */
int main(void)
{

  /* MCU Configuration--------------------------------------------------------*/

  /* Reset of all peripherals, Initializes the Flash interface and the Systick. */
  HAL_Init();

  /* Configure the system clock */
  SystemClock_Config();

  /* Initialize all configured peripherals */
  MX_GPIO_Init();
  MX_USART1_UART_Init();
  MX_USART6_UART_Init();
  MX_TIM2_Init();
  MX_TIM4_Init();
  MX_TIM3_Init();
  /* USER CODE BEGIN 2 */
  // Create desired object
  StepperX STEPPER1;
  StepperX STEPPER2;
  D4215X ESC1;
  D4215X ESC2;
  D4215X SER1;
  SwitchX S1;
  SwitchX S2;
  SwitchX S3;
  LEDX LED1;
  LEDX LED2;

  /* USER CODE END 2 */

  /* Infinite loop */
  /* USER CODE BEGIN WHILE */
  while (1)
  {
	  // Print to UART6 for debug
      char buffer[100];
	  HAL_UART_Receive_IT(&huart1, (uint8_t *)&charIn, 1);
      snprintf(buffer, sizeof(buffer), "%d\t%d\t%d\t%d\t\r\n", MOVE, SHOT, ESTOP, STATE);
      HAL_UART_Transmit(&huart6, (uint8_t *)buffer, strlen(buffer), 100);

      // Run Finite State Machine

      // STATE 0: INIT ALL OBJECTS
	  if (STATE == STATE_0_INIT) {
		  //INIT SERVO
		  HAL_TIM_PWM_Start(&htim3, TIM_CHANNEL_2);
		  // INIT RADIO TIMER
		  HAL_TIM_Base_Start(&htim4);
		  HAL_TIM_IC_Start_IT(&htim4, TIM_CHANNEL_1);
		  HAL_TIM_IC_Start_IT(&htim4, TIM_CHANNEL_2);
		  // INIT STEPPER MOTOR
  		  Stepper_init(&STEPPER1, GPIOA, GPIO_PIN_3, GPIO_PIN_5, GPIO_PIN_7);
  		  Stepper_init(&STEPPER2, GPIOA, GPIO_PIN_4, GPIO_PIN_6, GPIO_PIN_8);
  		  // INIT D4215 BLDC MOTORS
  		  D4215_init  (&ESC1,&htim2,TIM_CHANNEL_2);
  		  D4215_init  (&ESC2,&htim2,TIM_CHANNEL_3);
  		  D4215_init  (&SER1,&htim3,TIM_CHANNEL_2);
  		  // INIT 3 LIMIT SWITCHES
  		  Switch_init (&S1, GPIOB, GPIO_PIN_0);
  		  Switch_init (&S2, GPIOB, GPIO_PIN_1);
  		  Switch_init (&S3, GPIOB, GPIO_PIN_2);
  		  // INIT 2 EXTRA LEDS
  		  LED_init    (&LED1, GPIOB, GPIO_PIN_14);
  		  LED_init    (&LED2, GPIOB, GPIO_PIN_15);
  		  // MOVE --> STATE 1: DECISION HUB
  		  STATE = STATE_1_HUB;
	  }

	  // STATE 1: DECISION HUB TO BRANCH TO DIFFERENT HUB
	  else if (STATE == STATE_1_HUB) {
		  // TURN OFF 2 LEDS
		  LED_off(&LED1);
		  LED_off(&LED2);
		  // ENABLE 2 STEPPERS
  		  Stepper_enable(&STEPPER1);
  		  Stepper_enable(&STEPPER2);
  		  // READ 3 LIMIT SWITCHES
		  SW1   = Switch_getStatus(&S1);
		  SW2   = Switch_getStatus(&S2);
		  SW3   = Switch_getStatus(&S3);
		  if (DROP == 1) {
			  D4215_set(&SER1, 30);
		  }
		  else {
			  D4215_set(&SER1, 0);
		  }
		  // CHECK ESTOP
		  if (ESTOP == 1) {
			  ti = HAL_GetTick();
			  STATE = STATE_2_ESTOP;
		  }
		  // CHECK LIMIT SWITCHES OR "MOVE" FLAG FROM CONTROLLER
		  else if ((MOVE == 1 && SHOT == 0) || SW1 == 0 || SW2 == 0 || SW3 == 0) {
			  if (SW1 == 0) {
			      SW = 1;
			      angleTarget = 10;
			      yawDirectionSW = 0;
			  } else if (SW2 == 0) {
			      SW = 2;
			      angleTarget = 10;
			      yawDirectionSW = 1;
			  } else if (SW3 == 0) {
				  SW = 3;
			      angleTarget = 10;
			      pitchDirectionSW = 0;
			  } else {
				  angleTarget = 10;
				  SW = 0;
			  }
			  STATE = STATE_3_STEPPER;
		  }
		  // CHECK "SHOT" FLAG FROM CONTROLLER
		  else if (MOVE == 0 && SHOT == 1) {
			  STATE = STATE_4_BLDC;
		  }
		  // STOP IF
		  else {
			  D4215_set(&ESC1, 0);
			  D4215_set(&ESC2, 0);
			  STATE = STATE_1_HUB;
		  }
	  }
	  // STATE 2: EMERGENCY STOP STATE
	  else if (STATE == STATE_2_ESTOP) {
		  // DISABLE STEPPER MOTORS
  		  Stepper_disable(&STEPPER1);
  		  Stepper_disable(&STEPPER2);
  		  // STOP BLDC MOTORS
		  D4215_set(&ESC1, 0);
		  D4215_set(&ESC2, 0);
		  // CHECK FOR RESET BY PUSHING 2 BUTTONS AT THE SAME TIME FOR 5 SECONDS
		  if (MOVE == 1 && SHOT == 1) {
			  tf = HAL_GetTick();
			  dt += (tf-ti);
			  ti = tf;
		  }
		  else {
			  dt = 0;
		  }
		  STATE = (dt > 5000) ? STATE_1_HUB : STATE_2_ESTOP;

	  }
	  // STATE 3: SPIN STEPPER MOTORS
	  else if (STATE == STATE_3_STEPPER) {
		  LED_on(&LED1);
		  // LEFT SWITCH HIT --> MOVE TO THE RIGHT
		  if (SW == 1) {
			  for (int i = 0; i <= angleTarget/2; i++) {
				  Stepper_setspeed (&STEPPER1, 10, yawDirectionSW);
			  }
			  SW = 0;
		  }
		  // RIGHT SWITCH HIT --> MOVE TO THE LEFT
		  else if (SW == 2) {
			  for (int i = 0; i <= angleTarget/2; i ++) {
				  Stepper_setspeed (&STEPPER1, 10, yawDirectionSW);
			  }
			  SW = 0;
		  }
		  // MID SWITCH HIT --> MOVE UP
		  else if (SW == 3) {
			  for (int i = 0; i <= 10 * angleTarget/2; i ++) {
				  Stepper_setspeed (&STEPPER2, 10, pitchDirectionSW);
			  }
			  SW = 0;
		  }
		  // IF NOT SWITCH, MOVE ACCODING TO THE IMU DATA
		  else {
			  uint16_t yaw_map = map(yaw, 20, 250, 5, 30);
			  if (yaw > 20) {
				  for (int i = 0; i <= yaw_map; i ++) {
					  Stepper_setspeed (&STEPPER1, 1, yawDirection);
				  }
			  }
			  uint16_t pitch_map = map(pitch, 20, 250, 5, 50);
			  if (pitch > 20) {
				  for (int i = 0; i <= pitch_map; i ++) {
					  Stepper_setspeed (&STEPPER2, 1, pitchDirection);
				  }
			  }
		  }
		  STATE = STATE_1_HUB;
	  }

	  // STATE 4: BLDC MOTOR
	  else if (STATE == STATE_4_BLDC) {
		  LED_on(&LED2);
		  // TURN SERVO RELEASE BALL
		  D4215_set(&ESC1, 50);
		  D4215_set(&ESC2, 50);
		  STATE = STATE_1_HUB;
	  }

	  // STATE 1: DECISION HUB IN CASE SOME ERROR
	  else {
		  STATE = STATE_1_HUB;
	  }
    /* USER CODE END WHILE */

    /* USER CODE BEGIN 3 */
  }
  /* USER CODE END 3 */
}

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
/* USER CODE BEGIN 4 */
void HAL_UART_RxCpltCallback(UART_HandleTypeDef *huart)
{
  if (huart->Instance == USART1)
  {
    if (charIn == '\n')
    {
      data[idx] = '\0'; // Null-terminate the buffer
//      HAL_UART_Transmit(&huart6, (uint8_t*)data, idx, 100);
//      HAL_UART_Transmit(&huart6, (uint8_t*)"\r\n", 2, 100);
      dataProcess(data);
      idx = 0;
    }
    else
    {
      if (idx < sizeof(data) - 1)
      {
        data[idx++] = charIn;
      }
    }
    // Restart UART receive interrupt for next character
    HAL_UART_Receive_IT(&huart1, (uint8_t *)&charIn, 1);
  }
}

void dataProcess(char* data) {
	MOVE = (int16_t)data[0] - 48;
	SHOT = (int16_t)data[2] - 48;
	yawDirection   = ((uint8_t)data[4] == 45) ? 0 : 1;
	pitchDirection = ((uint8_t)data[9] == 45) ? 0 : 1;
//	if (pitchDirection == 0) {
//		pitchDirection == 1;
//	} else {
//		pitchDirection == 0;
//	}
//
//	if (yawDirection == 0) {
//		yawDirection == 1;
//	} else {
//		yawDirection == 0;
//	}

	uint16_t yaw1 = (uint16_t)data[5] - 48;
	uint16_t yaw2 = (uint16_t)data[6] - 48;
	uint16_t yaw3 = (uint16_t)data[7] - 48;

	uint16_t pitch1 = (uint16_t)data[10] - 48;
	uint16_t pitch2 = (uint16_t)data[11] - 48;
	uint16_t pitch3 = (uint16_t)data[12] - 48;

	yaw   = speedCalculate(yaw1, yaw2, yaw3);
	pitch = speedCalculate(pitch1, pitch2, pitch3);

	DROP  = (int16_t)data[14] - 48;
}


uint16_t speedCalculate(uint16_t first, uint16_t second, uint16_t third) {
	uint16_t number = 100 * first + 10 * second + 1 * third;
	return number;
}

void HAL_TIM_IC_CaptureCallback(TIM_HandleTypeDef *htim) {
    if (htim->Instance == TIM4) {
        if (htim->Channel == HAL_TIM_ACTIVE_CHANNEL_1) {
            rise = HAL_TIM_ReadCapturedValue(htim, TIM_CHANNEL_1);
        } else if (htim->Channel == HAL_TIM_ACTIVE_CHANNEL_2) {
            fall = HAL_TIM_ReadCapturedValue(htim, TIM_CHANNEL_2);
            if (fall >= rise) {
                total = fall - rise;
            } else {
                total = UINT16_MAX - rise + fall + 1;
            }

            if (total > 1800 && total < 2200) {
            	ESTOP = 1;
            }
            else {
            	ESTOP = 0;
            }
        }
    }
}
uint16_t map(uint16_t x, uint16_t in_min, uint16_t in_max, uint16_t out_min, uint16_t out_max) {
    return (uint16_t)((x - in_min) * (out_max - out_min) / (in_max - in_min) + out_min);
}
/* USER CODE END 4 */
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
