vvinhvvo98/Basketball-Launcher/Ball_Launcher_Main/Ball_Launcher_Main.ioc

Mcu.UserName=STM32F411CEUx
PA1.Signal=S_TIM2_CH2
PA10.Signal=USART1_RX
PA11.Signal=USART6_TX
PA12.Signal=USART6_RX
PA2.Signal=S_TIM2_CH3
PA3.Signal=GPIO_Output
PA4.Signal=GPIO_Output
PA5.Signal=GPIO_Output
PA6.Signal=GPIO_Output
PA7.Signal=GPIO_Output
PA8.Signal=GPIO_Output
PA9.Signal=USART1_TX
PB0.Signal=GPIO_Input
PB1.Signal=GPIO_Input
PB10.Signal=GPIO_Output
PB12.Signal=GPIO_Output
PB13.Signal=GPIO_Output
PB14.Signal=GPIO_Output
PB15.Signal=GPIO_Output
PB2.Signal=GPIO_Input
PB5.Signal=S_TIM3_CH2
PB6.Signal=S_TIM4_CH1
PB8.Signal=GPIO_Output
PB9.Signal=GPIO_Output
