vvinhvvo98/Basketball-Launcher/PAGES/controller.c

/**
 * @file controller.c
 * @brief Controller Component Documentation
 */

/**
 * @page controller_detail CONTROLLER
 * 
 * @section overview FINAL DESIGN
 * The controller will use an STM32 BlackPill microcontroller with an IMU sensor attached to the user's hand. 
 * It will send signals via Bluetooth to the launcher, allowing the launcher to receive the data and rotate according to the IMU sensor's input. 
 * The data transfer includes the velocity of the angles, and the communication uses a UART connection between the HC-05 Bluetooth module. 
 * The controller also features buttons and an indicator LED, all mounted on a 3D-printed handle bracket.   
 * 
 * <div class="image-frame">
 * <a href=https://vvinhvvo98.github.io/Basketball-Launcher/controller_detail.html>
 *      <img src="control.png" width="1200" height="500" style="border: 10px solid black; border-radius: 50px;">
 * </a>
 * </div>
 * 
 * <br> <!---->
 *
 * @section schematic CONTROLLER PCBA
 * Below are the overall schematic and footprint of the PCBA that is used to integrate the STM32 BlackPill, mpu6050 IMU, HC-05, and LEDs together. 
 * The PDF of this schematic is also attached with higher solution can be found in the picture below
 * <div class="image-frame">
 *   <a href="ControllerSchematic.pdf" target="_blank">
 *       <img src="PCBCONTROLLER.png" width="1200" height="800" style="border: 10px solid black; border-radius: 10px;">
 *   </a>
 * </div>
 * 
 * <br> <!---->
 *
 * @section pcbaC CONTROLLER PCBA
 * <div class="image-frame">
 * <img src="PCBCONTROLLERLAYOUT.png" width="1200" height="400" style="border: 10px solid black; border-radius: 50px;">
 * </div>
 * <br> <!---->
 * <div class="image-frame">
 * <img src="pcb1.png" width="1200" height="800" style="border: 10px solid black; border-radius: 50px;">
 * </div>
 * 
 * <br> <!---->
 *
 * @section fsm FINITE STATE MACHINE
 * <div align="center">
 * | State       | Description                                        | Actions                                                | Transitions                                                                                    |
 * |-------------|----------------------------------------------------|--------------------------------------------------------|------------------------------------------------------------------------------------------------|
 * | STATE0      | INIT - Attempt to connect to IMU                   | - Attempt to connect<br> - Turn on LED1 if successful  | - If unsuccessful, transition to **STATE1**<br> - If successful, transition to **STATE2**    |
 * | STATE1      | ERROR- Failed to connecto IMU                      | - Toggle LED1 if failed to connect to the IMU          | - Always transition to **STATE0**                                                             |
 * | STATE2      | IMU  - Read data from the IMU                      | - Continuosly read the data from the IMU               | - Always transition to **STATE3**                                                             |
 * | STATE3      | BUTTON_LED - Read buttons & update LEDs            | - Countinously read the button<br> - Update the LEDs   | - Always transition back to **STATE4**                                                        | 
 * | STATE4      | TRANSFER   - Send data to UART1 and UART6          | - Send data to UART1 (bluetooth)<br> - UART6 (debug)   | - Always transition back to **STATE2**                                                        | 
 * </div>
 * 
 * <div class="image-frame">
 * <img src="FSM1.png" width="1200" height="800" height="400" style="border: 10px solid black; border-radius: 50px;">
 * </div>
 * 
 * <br> <!---->
 *
 * @section bomm5 BILL OF MATERIAL - 3D PRINTED PARTS
 * Most of the 3D printed parts are printed using BambuLab XC1 3D printer and BambuLab filaments. 
 * All the CAD 3D model files can be found here for reference:
 * <div class="image-frame">
 * <a href=https://github.com/vvinhvvo98/Basketball-Launcher/tree/main/CAD>
 *      <img src="link.png" width="250" height="250" style="border: 10px solid black; border-radius: 50px;">
 * </a>
 * </div>
 * 
 * <br> <!---->
 *
 * @section bome2 BILL OF MATERIAL - ELECTRONICS
 * All of the components for electronics are listed in the attached PDF file below
 * <div class="image-frame">
 *   <a href="BILL_OF_MATERIAL.xlsx" target="_blank">
 *       <img src="xlsx.png" width="250" height="250" style="border: 10px solid black; border-radius: 50px;">
 *   </a>
 * </div>
 */
