vvinhvvo98/Basketball-Launcher/(commit log)

2024-05-14 CAD & PCB UPLOAD
    [1xBox.STL, 1xCover.STL, 1xCycloidal Disk 1.STL, 1xCycloidal Disk 2.STL, 1xInput Shaft.STL, 2xBearing Ring.STL, 4668K121_Permanently Lubricated Stainless Steel Ball Bearing.SLDPRT, 50xSpacer 10 mm.STL]
2024-05-15 init main page
    [BOM(UPDATE).xlsx]
2024-05-18 upload bom
    [BOM_UPDATE.xlsx]
2024-05-18 add schematic
2024-05-20 update CAD
    [1xBox.STL, 1xCover.STL, 1xCycloidal Disk 1.STL, 1xCycloidal Disk 2.STL, 1xInput Shaft.STL, 2xBearing Ring.STL, 4668K121_Permanently Lubricated Stainless Steel Ball Bearing.SLDPRT, 50xSpacer 10 mm.STL]
2024-05-22 update image
    [Assem2.SLDASM, Part3.SLDPRT]
2024-05-24 update docs
    [BOM(UPDATE).xlsx]
2024-05-30 upload website
    [PCBA Box.SLDPRT]
2024-06-01 upload docs
    [Assem2.SLDASM, Ball.SLDPRT, Part2.SLDPRT, Pipe.SLDPRT, Pipe2.SLDPRT, mg90s-horn.SLDPRT, mg90s-horn.stl, servo motor (mg90s) v1.step]
2024-06-03 Project Done
    [BOM(UPDATE).xlsx, Pipe2.SLDPRT, lever.SLDPRT, mg90s-horn.SLDPRT]
2024-06-13 Upload images
    [Stands.SLDPRT]
